mfeo15/CHIC-NAPaC/Report/LaTex source files/bibliography.tex

% References of the Report
\thispagestyle{empty}
\vspace{1cm}
\begin{thebibliography}{9}
\addcontentsline{toc}{section}{References}

\bibitem{lab3-report} 
\textit{Lab 3.0 : Camera \& LCD conceptual design}. \\
CS-473 EPFL. Matteo Yann Feo \& Simone Aron Sanso. November 28th, 2017

\bibitem{lcd-controller} 
\textit{ILI9341 - a-Si TFT LCD Single Chip Driver 240RGBx320 Resolution and 262K color}. 
Rev. 1.11. ILI TECHNOLOGY CORP.

\bibitem{lcd-display} 
\textit{LT24 User Manual}. 
Altera. June 2015
 
\bibitem{avalon-interface} 
\textit{Avalon® Interface Specifications}.
MNL-AVABUSREF. Intel. May 2017.
 
\bibitem{fifo} 
\textit{Single- and Dual-Clock FIFO Megafunction}.
Rev. 4.0. Altera. May 2007.

\end{thebibliography}
