mfeo15/CHIC-NAPaC/Report/LaTex source files/sections/3_EE/EE_main.tex

\newpage
\section{Electronic engineering}
\label{sec:ee}

In this section will be presented the work related on the electronic field.

\medskip First, the hardware subsection will explore the development kit selection, before highlighting the ESP32 capabilities and its electronic characteristics.
