mfeo15/CHIC-NAPaC/Report/LaTex source files/sections/appendix/B_mainPCBschematic.tex

\newpage
\section{Main PCB schematic}
\label{appendix:main_pcb_schematic}

\begin{figure}[H]
    \centering
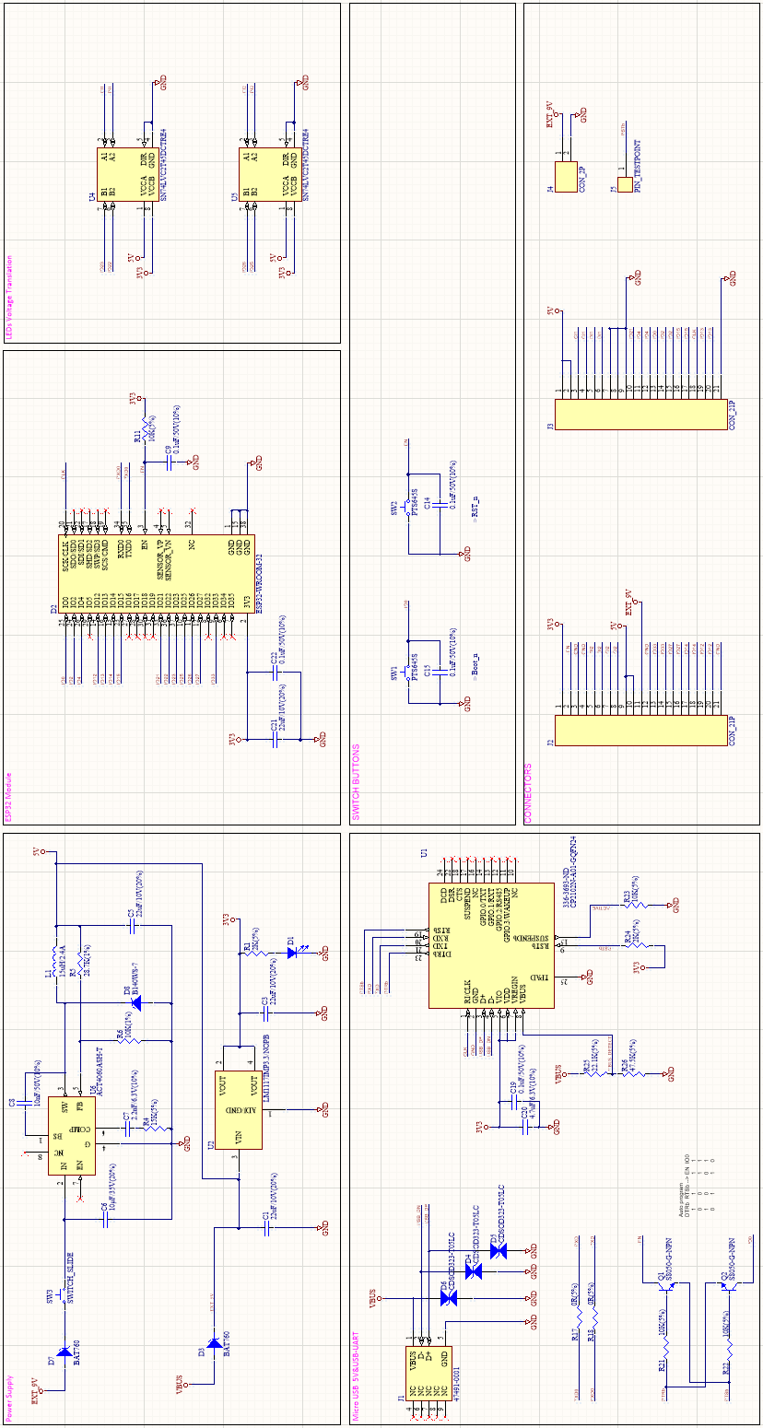
[picture p63: Report/LaTex source files/images/EE_fullPCBschematic.PNG]
    
    \caption{Full schematics of the main PCB}
    \label{fig:main_pcb_schematic}
\end{figure}
