mfeo15/CHIC-NAPaC/Report/LaTex source files/sections/appendix/F_HW.tex

\newpage
\section{Graphs from Soft Sensor testing}
\label{appendix:SS_graphs}

The following graphs illustrate test scenarios and values obtained while testing soft sensors.

\begin{figure}[ht]
    \centering
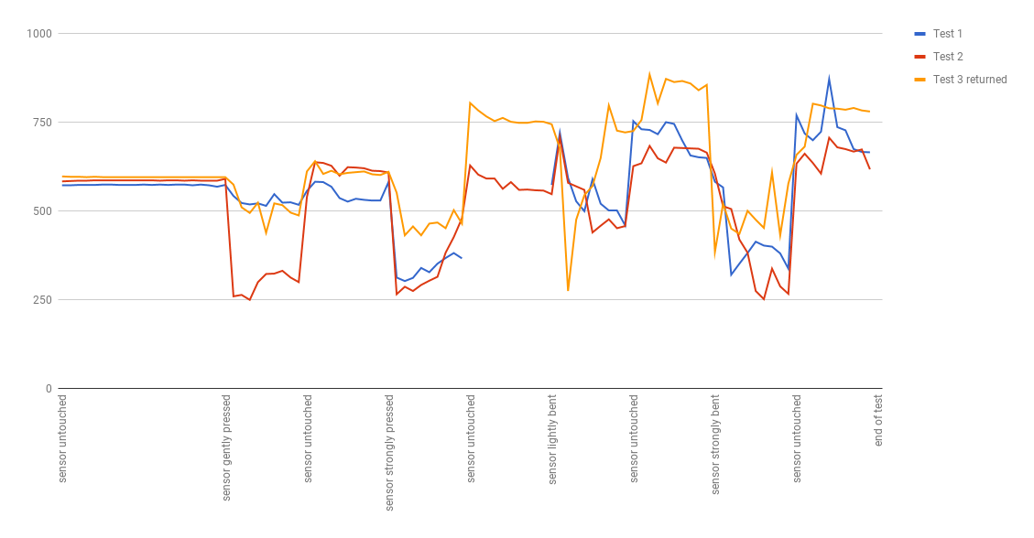
[picture p65: Report/LaTex source files/images/HW/velostat.png]
    
    \caption{Values obtained from testing the Velostat bend sensor}
    \label{fig:velostat_graph}
\end{figure}

\clearpage
\newpage

\begin{figure}[hbtp]
    \centering
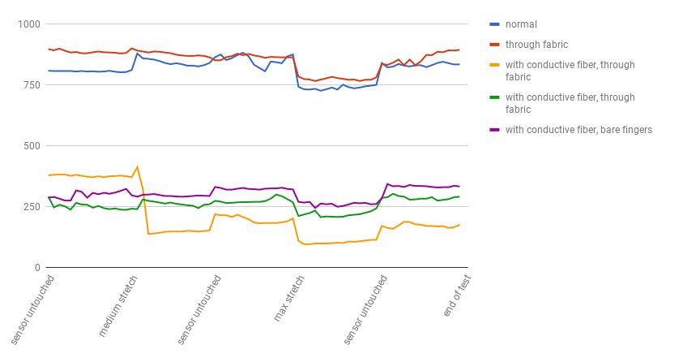
[picture p66: Report/LaTex source files/images/HW/eontex.png]
    
    \caption{Values obtained from testing the Eontex stretch sensor}
    \label{fig:eontex_graph}
\end{figure}

\clearpage
