mfeo15/CHIC-NAPaC/Report/LaTex source files/appendix.tex

% Appendix of the Report
\newpage
\appendix
\thispagestyle{empty}

\section{List of included contents}
\label{appendix:contents}

In the following appendix, a list of figures and a list of tables of the whole report is presented to the reader. This shall help him navigating through the content of the report, the different diagrams and tabulations.

\listoftables
\listoffigures

\section{Maybe another appendix ?}
\label{appendix:another}

Lorem ipsum dolor sit amet, consectetur adipiscing elit. Nunc ac ultricies felis. Donec lobortis dignissim velit, et rhoncus urna volutpat at. In hac habitasse platea dictumst. Nulla finibus ullamcorper eleifend. Suspendisse euismod placerat rhoncus. Donec rutrum eu lacus nec viverra. Maecenas luctus, dui nec scelerisque dictum, nisi lorem hendrerit ex, sed faucibus nulla metus ultricies ipsum. Nam luctus magna velit, ac luctus tortor porttitor ut. Aenean fringilla velit et magna tempus egestas.
