mfeo15/CHIC-NAPaC/Report/LaTex source files/kotlinLanguage.tex

\usepackage[dvipsnames]{xcolor}
\usepackage{listings}

\lstdefinelanguage{Kotlin}{
  keywords={package, as, as?, typealias, this, super, val, var, fun, for, null, true, false, is, in, throw, return, break, continue, object, if, try, else, while, do, when, class, interface, enum, object, companion, override, public, private, get, set, import, abstract, vararg, expect, actual, where, suspend, data, internal, dynamic, final, by},
  keywordstyle=\color{NavyBlue}\bfseries,
  ndkeywords={@Deprecated, @JvmName, @JvmStatic, @JvmOverloads, @JvmField, @JvmSynthetic, Iterable, Int, Long, Integer, Short, Byte, Float, Double, String, Runnable, Array},
  ndkeywordstyle=\color{BurntOrange}\bfseries,
  emph={println, return@, forEach, map, mapNotNull, first, filter, firstOrNull, lazy, delegate},
  emphstyle={\color{OrangeRed}},
  identifierstyle=\color{black},
  sensitive=true,
  commentstyle=\color{gray}\ttfamily,
  comment=[l]{//},
  morecomment=[s]{/*}{*/},
  stringstyle=\color{ForestGreen}\ttfamily,
  morestring=[b]",
  morestring=[s]{"""*}{*"""},
}
