mfeo15/CHIC-NAPaC/Report/LaTex source files/images/intro_one_pager.pdf

# Have you ever felt like spending more time with your child?

Toygether is a soft toy for kids, aged from 2 to 5, that can connect to their parent’s smartphone. It enables parents to have simple playful moments with their child through light and music.

With ever increasing working days and commute times, parents might have
less time to spend with their loved ones. Toygether aims at bridging this gap
by providing a screenless interaction platform, enabling young children and
parents to play even when they cannot physically be together. | When you see your

## toy filling up with light

and sound, my love,

## it’s me that is thinking about you and wants to play

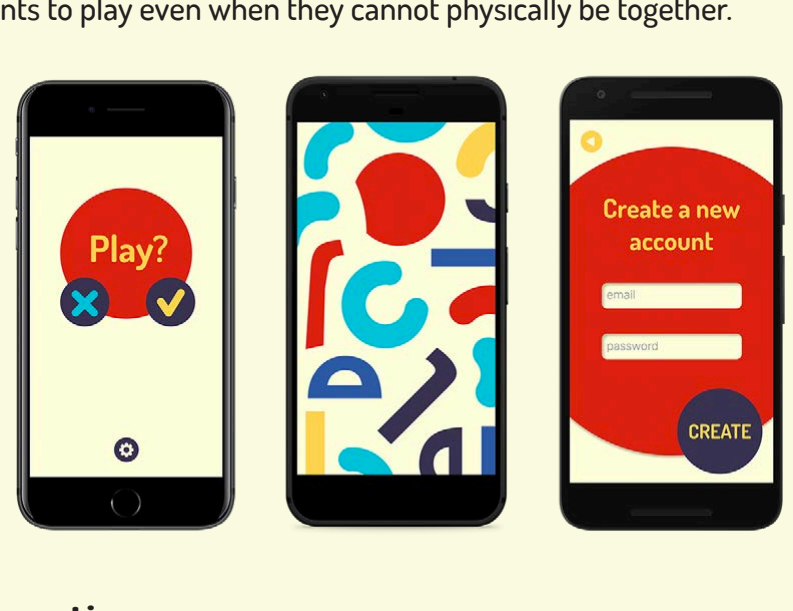
[picture p80: figure]

## Interactive

The plush toy and the smartphone app are connected together, allowing meaningful interaction between the parent and the child, even at distance.

## Educational

The plush toy helps developing all senses of the kid. The sense of touch is awakened with the different materials. The music feature provides a very rich experience for the cognitive development. Finally, playing with the toy can help improve memory and coordination.

## Washable

The electronics are easily removable, which allows easy cleaning.

## Screenless

Z-generation children are likely to be over-exposed to screens. Toygether is a solution enabling parents to stay in touch and play with their kids at distance without putting a screen in their hands.

Estelle GENEUX
Business Information
Technology

Simone SANSO
Electronic
Engineering

Chloe DICKSON
Firmware & Mechanical
Engineering

Matteo Yann FEO
Software
Engineering

Luca SASSOLI
Media & Interaction
Design

Marjane AMARA
Industrial Design

The Toygether team, based in Lausanne, Switzerland - toygether@163.com
