mfeo15/CHIC-NAPaC/SHS/SHS_Research_project.pdf

# Communication Technologies for Left-Behind Children in Rural China

Matteo Yann Feo
Master of Computer Science
Swiss Federal Institute of Technology, EPFL Lausanne, Switzerland
Email: matteo.feo@epfl.ch

Simone Aron Sanso
Master of Micro Engineering
Swiss Federal Institute of Technology, EPFL Lausanne, Switzerland
Email: simone.sanso@epfl.ch

Abstract—Starting from a literature review focusing on the effects of distant parenting on left-behind children in rural China, it has been shown that increased remittances (i.e. sending of money) allowed an enhancement of physical health and academic performance. However, mental health was found to be seriously affected by the lack of parental care, thus increasing the likelihood of depressions during the children’s growth. A comparative analysis has been then realized, comparing three different scenarios of distant parenting: the first one covered the hospitalization of children, the second incarcerated parents and the third transnational parents, out-migrating for the same reason of the Chinese context. All three scenarios revealed the importance and the pros of communication technologies in distant parenting situations. To validate our assumptions, a survey has been forwarded towards parents and children having lived at distance during a continuous period of time, because of activities organized for the children (boy-scouting, summer camps and intercultural exchange programs). Both parents and children demonstrated to rate as essential the importance of communication between parents and children at distance. With even stronger and more sensitive settings than those joyful ones presented here, we anticipate how even more crucial the communication technologies might be rated by families of left-behind children. During an interview with an expert in Chinese anthropology and urban sociology, this hypothesis has been ascertained. Envisioning further investigations on the Chinese field, an interview protocol has been implemented and can be used to validate or refute our hypothesis, by questioning parents of left-behind children. Furthermore, the interview protocol provides a useful tool to analyze more in-depth the psychological effects of parents in this situation.

LIST OF ABBREVIATION

CHIC | China Hardware Innovation Camp
CRC | Convention on the Rights of the Child
ICT | Information and communications technology
LBC | Left-Behind Child(ren)
UN | United Nations
I. INTRODUCTION
Every year, Mainland China witnesses the biggest human mass migration process on Earth, during the Lunar New Year celebrations (Jingyong Zhang et al. 2015). In February 2018, more than 385 million Chinese, according to Forbes (2018), converged back from cities to rural areas. This year, the purpose was to celebrate the year of the Dog, with their family

(Forbes 2018). Among those travellers, a substantial percentage consisted of migrant workers who moved from rural areas to more urbanized ones, in order to seek job opportunities. They live away from their family and usually all return home during the week before New Year, providing support to them via remittances throughout the year. According to Guo, Sun, and Wang 2017, ”An increasing number of children in Chinese rural areas live far away from their parents, as about 80% of the migrant workers leave their children behind in their home-village”. For this reason, they are called ”Left Behind Children” ( 留守儿童, pinyin: liush ´ ou’ ˇ ert ´ ong ´ ), because they are raised by other family members (the second parent figure or the grandparents) or, in the worst scenario, completely left on their own in their home village. The situation of departing parents has substantial impacts on the child’s development, depending on multiple factors involved.
Our research study aims at understanding how communication technologies, connecting parents with their left behind children in rural China, could be beneficial. First, when focusing the study on a subset of the population, as we are doing by specifying ”Rural China”, a clear definition of this expression needs to be provided. According to Shen 1995, the definition is strongly influenced by three crucial censuses, which occurred in 1982, 1987 and 1990. Those collected statistics have been used to divide home-towns of each Chinese province into either ”agricultural” or rural areas, and ”non-agricultural” or urbanized areas. The 1990-census is the most widely adopted allocation between ”agricultural” and ”non-agricultural” villages for such kind of researches. Therefore, our study will be based on this definition of ”rural China”. Nowadays, people are used to connecting with each other via always improving technologies (Bird 2018). We are thus interested in discovering patterns, in parallel to the enhancement of communication channels, between children and their distant parents. Our initial reasoning, biased by definition towards the western social context we have grown into, would indicate that the issue of left-behind children in China could harm both their physical and mental aspects. Moreover, our background suggests that a stronger communication between family members could lead to positive effects and eventually mitigate the issue. Such instinctive conclusions will be challenged during the course of the following research study. The Chinese context of left-behind children lays on the antipodes of our own and each conclusion we might consider trivial to draw needs to be reexamined in a different light. The study’s goal is to explore if and how such context-issue located in China could benefit from enriched communication, via technological means.
To illustrate our work on the presented topic, we will undergo a series of key steps as follows: firstly, an overview in the form of literature review will showcase related work and previous investigations, regarding the left-behind children issue in China and the effects caused by it (section II); then, the methodologies followed during the research will be presented and covered (III); obtained results of the research are thus introduced to the reader with the help of descriptive statistics (IV); interesting patterns in the collected data will be retrieved and compared to the main issue regarding left-behind children, with the support of external expertise (V); and lastly, our final remarks and future scenarios on the presented work (VI).

II. RELATED WORK

A large number of studies have been conducted about the reality of left-behind children, on different localities around the world. These studies have been focusing on different impacts of parental migration, from the children’s perspective. Interestingly, this phenomenon is not only restricted to China (Song and Y. Zhang 2009; He et al. 2012; Guo, Sun, and Wang 2017; Fan et al. 2010; Bai et al. 2017), but also frequently appears in Mexico (Sawyer 2016; Kanaiaupuni 2000; Hildebrandt et al. 2005; Fernandez 1998; Dreby 2007), Latin America (Mundial 2006; Acosta, Fajnzylber, and Lopez 2007; Anton 2010), Romania (Botezat and Pfeiffer 2014), ´ Philippines (Yang 2008; Cortes 2015; Arguillas and Williams 2010) and Thailand (Jampaklay 2006). In this section, specific terms used throughout the research will be defined. Then, related work will be reviewed, about the impact of parental migration on physical health, academic performance and mental health of left-behind children.

A. Definitions and terminology
According to the United Nations (UN 1998), the commonly accepted definition of ’migrant’ is ”any person who changes his or her country of usual residence”. A more precise classification can be introduced with time and space constraints (Rossi 2008). The process is then defined as ”permanent”, ”long-term” (at least 12 months) or ”seasonal”, with either an internal or an international migration. Purposes of recreation, holiday, visits to friends, business, medical treatment, or religious pilgrimages are, although, not considered as migration processes (UN 1998). Two scenarios of parental migration can appear. Either the parents migrate with their children, or they leave them behind (Rossi 2008). Another possible result of parental migration is related to the issue of foster children. Although they share the same loss of parental care, the complete interruption of communication with both parents determines a completely different case that cannot be discussed nor compared with the two previously mentioned scenarios

(Pilon 2003). The commonly accepted definition of LBC (left-behind children) refers to children who stay at home when one or both parents relocate elsewhere, to join the labor force, for at least six months (Lu 2011). In the Chinese context, parental migration is considered to be seasonal and internal, since migrants move from rural to industrialized regions, spending yearly around 11 months away and returning home during the Spring Festival. The formal definition of ’children’, given in the CRC (Convention on the Rights of the Child), Article 1 drafted by United Nations (1989), states that ”individuals below the age of 18” form the children population. However, other conventions to define ’children’ can be found. The 0-15 age range is the most adopted one, in accordance with the research context, due to medical (women fertility) and labor (legal working age) reasons.

B. Impact on LBC’s physical health

The study of Guo, Sun, and Wang (2017) reveals that the ”overall effect” of parental migration on children’s health is uncertain.
Several research studies found positive effects of parental migration on children’s health (Mundial 2006; Acosta, Fajnzylber, and Lopez 2007; Anton 2010; Stillman, Gibson, ´ and McKenzie 2012) and have mainly attributed them for the increased incomes of the family. Remittances helped reducing childbirth mortality (Hildebrandt et al. 2005), increasing birth weight and decreasing the number of underweight newborns (Frank and Hummer 2002). Children are better nourished and can take advantage of an eased access to health services (Nobles 2006). As a consequence, higher incomes enable the children to better manage chronic health problems through medication (Case, Lubotsky, and Paxson 2002).
Other research studies raised negative effects of parental migration (Amato and Gilbreth 1999; Kanaiaupuni 2000; Fernandez 1998), mainly due to the reduction of parental care. Song and Y. Zhang (2009) found that LBC started to overuse health services. A possible cause of this behaviour is the attempt to replace the lacking parental care by medical services. Another intriguing fact from this study is that the access to health services depended on whom the children were left with. Statistically, maternal migration had a negative effect on children’s health. This result confirms several studies showing that maternal presence is essential for the development of a child (Cortes 2015; Jampaklay 2006; Macours and Vakis 2010; Thomas 1994). With paternal migration, longer time and distance of migration positively affected children’s health, again as a consequence of increased remittances. Children’s health status revealed to be also affected by socio-economic factors, dependant on the household (Behrman 1996). One reason why poor parents do not out-migrate could be the need of initial capital to cover emigration costs, for transportation and accommodation reasons. Lastly, health impact of parental migration has been shown to be independent to the child’s age and gender (Guo, Sun, and Wang 2017).

C. Impact on LBC’s academic performance

The study of Bai et al. (2017) rejected the hypothesis that parental migration deteriorated the academic performance of children. Additionally, they found that when one parent or both out-migrated, the academic performance of LBC was even significantly improving, compared to the rest of the students. Increased incomes can, therefore, bring a larger impact than the reduction of parental care. Rising incomes might provide several benefits for LBC, like a better nutrition, improved access to educational materials and fewer housework responsibilities. An analysis about the heterogeneity of the impact, among children of different households, showed that the positive effect of parental migration was even larger for students initially poorly performing at school. An explanation for LBC’s academic improvements is the availability of additional materials, which might have led them to overcome educational barriers that limited their performances. For instance, betternourished students see their academic performance rising (Luo et al. 2012). Remittances could also be invested in tutoring and other additional learning materials like books, computers and learning software. The positive impact of parental migration has been found to become larger when the out-migrating parent had a poor level of education. If the parent has a high level of education, a trade-off between parental tutoring and migrant remittances appears. Therefore, depending on the out-migrating parent’s background, the impact on the academic performance can significantly differ among LBC (Sawyer 2016).

D. Impact on LBC’s mental health

According to the study of He et al. (2012), LBC were at greater risk to develop depression, compared to the other students. The work confirmed a previous study from Fan et al. (2010), conducted on the same topic. The emotional disturbances and higher risks of depression are more evident in specific age-ranges. During early adolescence, changes in sexual cognition and social development occur, leading to determinant consequences for the overall maturity process. Without parental care, psychological problems occurring in the late childhood and adolescence can introduce direct repercussions on LBC’s mental health, increasing the indicators of adult depression risks (Kosterman et al. 2010).
The results presented in the Chinese context were further confirmed by another study, deriving pieces of evidence from Romania (Botezat and Pfeiffer 2014), where the migration fluxes end towards more occidental European regions. Compared to non-migrant households, the study illustrates substantial increases in depression, as well as higher propensity to be bullied during childhood, particularly in rural areas. These research insights match previous results from the literature on the mental health of left-behind children (Gibson, McKenzie, and Stillman 2011; Dreby 2007; Mazzucato and Schans 2011). Children left alone to take care of themselves, living in an environment without any adult supervision, result in even larger risks of depression (Lahaie et al. 2009).

Ren and Treiman (2016) realized a more philosophical research about the possibility of wrongly perceiving causes of depression with Chinese LBC. The research compared the difference of family ”arrangements”, or emotional bonds between parents and children, in China and other countries where the phenomenon of parental migration frequently occurs (i.e. Nicaragua, Philippines, Mexico). They concluded that, in the Chinese context, these family arrangements have ”little impact on the emotional well-being of children”. For this reason, researches about LBC in the specific context of China should be considered a singularity of its own, due to the impressive number of internal migrants, incomparable to any other country. From the Chinese point of view, since the situation of leaving children behind became more common in rural areas (Hao 2006), non-Chinese researchers shall be cautious about their belief of understanding the local social context in China.

III. METHODS

In this study, we seek to evaluate how communication technologies could alleviate the negative consequences of parental migration in rural China. As widely covered in the previous section, LBC are particularly subjective to retain long-term effects on mental well-being, due to the absence of parental care in crucial ages. Therefore, we aim to investigate how the increasing adoption of ICTs (Information and communications technologies) might improve the condition of Chinese families in this context.
To this end, a research methodology has been structured as follows. The topic of ICTs for families will first be analyzed from a more global perspective, focusing on different geographical areas and situations. Our findings will be subsequently related to the local reality faced in rural China. In this manner, the importance of fostering communication technologies between distant parents and children will be explored, through a comparison of related studies within western countries (subsection III-A). Then, after drawing subsequent assumptions, these latter will be tested through a study case realized in our geographical proximity (Switzerland, France and Germany). For this purpose, the recruitment of the samples will be highlighted (III-B), before diving into the content of the survey (III-C).
A. Comparative analysis on similar situations

In this subsection, an analysis of different scenarios will be presented, investigating whether communication affects the mental well-being of children. The first sensible context that will be approached relates to hospitalized children, with long-term chronic diseases disrupting their previous social routine. The second scenario will explore the challenges faced by imprisoned parents to communicate with their children. The last scheme portrays transnational families, for which at least one of the parents left the family to migrate to another country.

a) Hospitals: In the research, conducted by Wadley et al. (2014), is shown that children undergoing long term hospitalization face psychological obstacles, due to a brutal change of previous daily habits. A long term isolation from their social life, both from their family and peers at school, causes concerns to their emotional well-being. Furthermore, this social dislocation occurs at a time when social engagement is crucial for children’s development, as explains the study of Hopkins, Moss, et al. (2014). A comparable situation emerges between this context and the LBC issue, despite the different duration of separation. Furthermore, staying ”out of sight” (Yates et al. 2010, page 80) can lead to apprehension for the isolated child, about coming back to meet again after a long period of time. Therefore, ICTs’ capabilities need to be further investigated. Innovative ICTs could not only be used to bridge distant people together, but also enhance emotional well-being by avoiding staying too long out of each other’s mind. According to different studies (Vernon et al. 1971, Bossert 1994 and Thomson 2012), hospitalization can increase children’s stress. Parents, on the other hand, must continue working and may also experience anxiety and sense of guilt, not being able to be present for their child. This context, thus, shows similarities with migrating parents, leaving their children behind. As revealed in the studies of Stewart-Brown (1998) and Ryan and Deci (2001), physical diseases could also result from emotional distress. Social support through ICTs, therefore, becomes essential for distant families. The research from Hopkins, Nisselle, et al. (2013) highlighted the impact of prolonged absence from school, possibly resulting in a child’s disengagement that can later cause employment difficulties. Challenges associated to unpredictability and vulnerability of children’s health within the hospital’s context, presented by Yates et al. (2010), can be compared to fears and worries of migrating parents, regarding their LBC.
Indirectly contributing to the emotional well-being of persons in sensitive settings, this first analysis of ICTs within hospitals already clearly demonstrates how technology could provide support and connection between LBC and out-migrating parents.
b) Prison parenting: In 2007, 1.7 millions of children had an incarcerated parent in the United States of America (Glaze and Maruschak 2008). Poehlmann et al. (2010) state that these children experience a larger risk of substance abuse, behavioural problems and thus academic failure. Furthermore, poverty and changes in caregiver due to the parents’ incarceration are either the cause or a ”risk marker” (Murray and Farrington 2008) of children’ problematics.
Children’s age is an important factor to take into consideration when approaching the parent-child interactions in this context. Infants, for instance, particularly need contact with their mother. In fact, Byrne, Goshin, and Joestl (2010) showed that infants who stayed in the nursery program of the prison, where the mother resided, were more likely to keep a long term attachment with their mother (with respect to other children discharged from the program less than one year after their arrival). The actual parent-child mean of contact may differ with the age of the child since infants are not able to write letters or even have an oral conversation. Furthermore, when children are too young to have their own opinion, caregivers might act as ”gatekeepers” (Enos 2001). Thus, instead of facilitating the parental contact with the child, some might even limit it. Then, when becoming teenagers, children further develop their verbal skills and sometimes start visiting their incarcerated parents, hiding it from the caregivers (Shlafer and Poehlmann 2010). An absence of contact with the parents might cause feelings of alienation to the child (Shlafer and Poehlmann 2010) since no one ever gave enough affection and attention to let the child feel self-confident.
Parents, on the other hand, might feel stress from losing contact with their children (Day et al. 2005, Clarke et al. 2005, Magaletta and Herbst 2001, Roy and Dyson 2005, J. Arditti and Few 2008). Experienced symptoms of incarcerated parents are depression and anxiety (Houck and Loper 2002). The impressive outcome is that both direct and distal communications are able to improve the state of mind of incarcerated parents. Poehlmann (2005) showed that visits could decrease the depression of mothers in prison. Likewise, Loper et al. (2009) discovered that mothers with more frequent phone calls, letters or emails were feeling less distress. As Casey-Acevedo, Bakken, and Karle (2004) associated joy and relief to visits, distant communications can also have a significant impact on parental mental health.
Regarding facility visitation policies, depending on the institutional security level, the parents are allowed to receive ”full” contact visits (where physical contact is allowed), or ”open” but without contact visits, or ”barrier” visits (occurring with a Plexiglas barrier) (Johnston 1995, Sturges and Hardesty 2005). In some jails, visits can even happen only through a television transmission, where the incarcerated parent and the child are located in two separate areas. From this literature review, child visits can happen to be associated with emotional distress, together with uncomfortable environments and almost no opportunity for meaningful contact, as also explained by
J. A. Arditti (2003) and Loper et al. (2009).
Parents might prefer avoiding their child seeing them in a rather negative environment. Incarcerated parents thus prefer contacting their family with alternatives to visitations, such as written correspondence, because the settings are more under the parental control than on the authorities of the penitentiary. On the other hand, the child is less likely to overhear inappropriate discussions. The parent might be more relaxed and focused on the content of the interaction with the child, rather than on the environment. Visitation rooms, letters and phone calls become the child’s reality of the relationship with their parent. When children and parents did not manage to keep in contact, visits could also be stressful for the child. A perfect transition before initiating visitations could then be remote forms of contact. Alternatives for younger children, not yet apt to communicate orally, could make the use of a playful interaction. To conclude with regard to this context, distal communications offer flexibility (Tuerk and

Loper 2006), which is not given to incarcerated parents.

c) Transnational parenting: The study of Bacigalupe and Lambe (2011) provides another relevant example to test the importance, for growing children, of having communication channels with their family. The paper focuses on the increasing adoption of ICTs in migrant families and how technologies can ease the parenting role that became more difficult with the distance.
The first key consideration the study highlights is the need to completely change people’s state of mind about ICTs in family communications. The general public is often reminded of the negative impact an over-usage of technologies could bring in the family bonds. In fact, the adoption of technologies in a household might lead to unhealthy and, paradoxically, even distant connections with the other family members. However, when families face the situation of living at distance, the previous negative statements about ICTs need to be questioned. Therefore, a transnational family context cannot be modeled as the common family idea, where both parents and children can easily meet in reality.
An objective analysis of the study’s content could not be possible without taking some distance with the paper. Faceto-face relationships are not anymore the only manner to maintain and build a social bond between people (Bacigalupe and Lambe 2011). Introducing new possibilities of ICTs, this vision can be completely remodelled. Licoppe (2004) describes this new era of communication technologies as ”a continuous pattern of mediated interactions that combine into ‘connected relationships’, in which the boundaries between absence and presence eventually get blurred” (page 135-136). The research of Bacigalupe and Lambe (2011) recalls that parental migration always existed since civilization exists. However, it often implied a sharp consequence on the household stability. The social concept of family often identifies the parental caregiving when growing children. Without ICTs, out-migrating parents would require frequent visits or, since recently, expensive international calls in order to keep a solid family bond. Most migrants, due to scarce resources, were not able to maintain such a functional long-distance family. This lack of parenting would eventually cause the irreversible problems during the child growth identified in the literature review (section II). Therefore, ICTs could bridge migrated parents with the rest of the family and provide the missing communication channel that leads to an unhealthy child’s growth. We believe that, potentially, such new communication technologies could be the key to mitigate negative mental consequences, introduced in the context of LBC in China. The role of ICTs is to allow families to engage in a ”transnational care-giving”. The rising adoptions of smart-phones, primary kind of ICT, is a clear signal of the importance such technologies have in the process. In fact, transnational families benefit from those tools to accomplish each small parental duty, necessary to the well functioning of the family such as bedtime routines or even hygiene check-ups. To further analyze this process, one needs to first define parental care-giving in detail. According to Finch (1989), it could be expressed in five basic forms: ’financial’ (i.e. remittances), ’practical’ (i.e. sharing expertise), ’personal’ (i.e. hands-on care of sickness), ’accommodation’ (i.e. having a place to stay), and ’emotional’ or moral support (Bacigalupe and Lambe 2011). The adoption of communication technologies gives access for children to a new channel that effectively provides care-giving, as described, by migrant parents. Therefore, by using ICTs, transnational families are able to cover each of the forms of care-giving listed previously (Baldassar 2007). While some of these forms could be argued to need real proximity with the parents and in-person visits, all of them can still be handled at distance. Furthermore, with ICTs, the emotional and moral support from parental care-giving would be strongly enhanced and could, therefore, be mitigating the negative consequences of mental well-being for LBC.
In conclusion, the usage of ICTs in migrant families is less likely to have the negative impact that families living close together could face. ICTs actually provide a tool to strengthen family connections otherwise very difficult, if not impossible, to maintain. In this new light, we think that children of out-migrating parents could benefit from communication technologies to mitigate consequences identified in LBC mental health. By enriching accesses to different forms of parental caregiving at distance, as defined Finch (1989), ICTs may be the key to improve the difficult conditions of migrant families.
B. Recruitment
In the analysis covered in the previous subsection, the importance of communication channels between growing children and the rest of the household has been clearly highlighted. Moreover, similar negative effects to the ones identified in the LBC’s context were presented. Therefore, considered as not completely grown up yet, children below the legal age (18 years old in Europe, 15 years old in China) require strong communication with their parents to avoid negative mental consequences, regardless of the surrounding context. Even though each person’s background is different, communication appeared to represent a key component of a healthy child’s development.
In order to enrich our research, we decided to test this assumption in our own local context. The purpose of this section is to introduce the procedure that has been used, before presenting the results (see section IV).
The objective of this phase is to understand the importance of communication in distant households and how ICTs might have helped mitigate negative effects related to that context. To this end, we decided to tackle the problem by identifying different situations present in our reality (a ”Western context”, primarily focused in Switzerland, France and Germany) in which households would be separated for a continuous amount of time. A complete recruited-population research has been done, which provided promising results for situations such as summer camps, scouting adventures or intercultural exchanges. Kids and teenagers whom joined such programs have spent from a couple of weeks (specifically the younger ones) up to six months or a year away from their family. As we previously did in the definition of LBC, by identifying constraints on both child age and family-separation time, the same must be done with the recruited population. While tackling the question from our local perspective, a trade-off aroused on the population characteristics. As mentioned, the younger the children and the less likely the children have spent more than a couple of weeks away from their family. On the other hand, increasing the age of the participants induced longer separation-times, better matching those of LBC (of at least six months). Therefore, during the discussion of the results, these factors shall be kept in mind to draw a more accurate conclusion.
In addition to children and teenagers recruitment, particular consideration from the parents’ side has been taken. Since the study focused on the importance of communication, obtaining results concerning the two sides of the channel could potentially lead to richer conclusions. Moreover, especially when dealing with younger children, parents could provide more easily the needed information.
While reading the previous paragraphs about the sample population recruitment phase, the reader might underline the impressive difference between the LBC issue and the distant-parenting experiences chosen. In fact, results collected from this selected population are difficult to relate to the Chinese issue because of the former experiences a family-detachment due to joyful and/or educative motifs. On the other hand, the migration decision is forced by much more difficult reasons. However, other possible populations have been considered to be recruited for such phase. Military recruits, who are often required to spend significant periods of time away from their home, or incarcerated parents who face the challenge of communicating with their family as already presented before could have led to richer results in the research. Although, due to difficulties with such recruitment, a trade-off has been achieved, thus leaving more accurate populations for further investigations and future iterations of the study.
To collect the data from those two described populations, an online survey has been prepared and posted on social media platforms. Initially, to be able to draw statistical conclusions, the expected minimum number of answers was set to 30 situations of distant parenting with children below 18 years old. Not being able to reach enough valuable data, we decided to turn ourselves to associations. The objective was not only to obtain more insights towards distant-parenting situations, but also to reach a more homogeneous population. Thus, we have been in contact with a consistent number of associations to spread out the survey (refer to annex D for the list of contacts). The idea was to examine the question in our own region, by reaching out entities in the Canton de Vaud (eventually expanding then to Switzerland as a whole), whose work related to distant parenting experiences for children and their families.
C. Content of the survey

As previously mentioned, the goal addressed with the survey was to determine the importance of maintaining a communication channel via ICTs, in any context of distant parenting. We aim to directly test on our European local reality how kids, away from their family, might find comfort in this connection. Even though the population we recruited and described in the previous section is mainly composed of families divided by joyful activities (intercultural exchanges, summer camps, etc.), homesickness can easily emerge. For this reason, even this type of joyful experiences can lead to a substantial decline in the emotional well-being, particularly for young children at their very first time away from home. The content of the survey intends to give an understanding about how essential channels of communication become for distant families in such context and, therefore, even more crucial in harder situations as the ones experienced by LBC in China.
The survey was written down in both French and English to maximize its accessibility. Post-processing tasks have then merged the results for comparisons. Moreover, the survey contained similar questions for both parents and children, but each from their own perspective to eventually later draw conclusions, with respect to both groups of family members. To investigate the problem, the survey tried to collect enough demographic data of both children and parents, answering about their first experience of distant parenting. The idea is to, during the afterwards analysis, determine different patterns in how the communication channel might be correlated to gender, age or parental role (mother and father). This latter, for example, might be interesting because it could lead to results similar to the ones mentioned in our literature review for LBC in China. Different parental roles are key factors in how the distant parenting experience is handled. Furthermore, we investigated the kind of short-term ”migration” to better understand how families have dealt with it, particularly in cases of long duration distant parenting and young ages of the children.
Before diving into the analysis of the results, the reader may first want to explore the questions that have been asked in the survey (appendix A). First, the context of the survey has been briefly explained. Then, questions were split into two categories, depending whether the person answering the survey has lived the situation of distant parenting as a child or a parent. Both child’s and parent’s gender were asked, in order to understand whether a stronger relationship could appear between distant mothers and children, as described in previously mentioned related work (section II-B). Then, more precise questions about the context of distant parenting situations were asked (reasons, duration, age of the child). The focus of the survey was on the communication technologies used during that period of time (frequency, main purpose and mean of communication). Finally, the questioned people were asked how they would rate the importance of communicating with their distant relatives. Notice that the scale has been chosen from 1 to 7, with value 1 corresponding to insignificant and 7 to essential, in order to keep one neutral answer (4/7) and three possible choices of negative (3/7 and below) and positive answers (5/7 and above). Notice as well that when the importance of communication is presented as null (0/7), it means that no data has been received for a particular setting of distant parenting (i.e. in fig. 11 with the frequency of communication corresponding to ”once per month”).

IV. RESULTS
This section reports the results of our study, organized around the questionnaires. In total, 116 persons have answered the questions that have been presented previously. Before diving into the analysis (see section V-A), the collected statistics need to be objectively presented. First of all, the sampled population present the following characteristics: 55.9% of the questionnaires have been filled with the English form, against 40.1% in French; 75% of the population was composed of children (37.9% sons and 62.1% daughters), and 25% by parents (10.3% fathers and 89.7% mothers). The two main features of interest are the Child’s age, to compare the input with the LBC issue, and the Importance of communication from which we aim to draw relevant conclusions. Such characteristics are presented in tables I and II, for the children and parents population, respectively. The first class contains 87 children, with a mean age of 14 years and 3 months old (14.31), having spent at least three days away from their family. These children rated, on average, the importance of communication 5.80 over a maximum score of 7, with a standard deviation of 1.46. The second class (29 questioned parents having lived a distant parenting experience with a child of 9 years old on average) rated the importance of communication at 5.79, with a standard deviation of 1.69. Despite the difference in the total number of parents and children having participated to the survey, both final results regarding such latter feature are surprisingly close to each other.

TABLE I
STATISTICS FOR THE CHILD RESULTS OF THE SURVEY
Child’s age | Importance Rating [0-7]
Mean Std Min 25% 50% 75% Max | 14,31 5,06 2 10 14 18 23 | 5,80 1,46 2 5 6 7 7
Count | 87

TABLE II
STATISTICS FOR THE PARENT RESULTS OF THE SURVEY
Child’s age | Importance Rating [0-7]
Mean Std Min 25% 50% 75% Max | 9,00 3,23 3 7 9 10 17 | 5,79 1,69 0 5 6 7 7
Count | 29

To conclude the section, we present to the user the statistics illustrated in the previous tables by adopting box-plot representation for each feature. Figure 1 illustrates the different input data regarding children’s age. Even though the parent population is considerably smaller than the children one, it generally focuses on a younger age range that better matches the premises of the research. Despite the heterogeneity of the two sampled categories, figure 2 illustrates surprising close results regarding the importance of communication.

0 | 5 | 10 | 15 | 20 | 25

Children
(Parents’ survey)

Children
(Children’s survey)

Children’s age

Fig. 1. Age of the children by the two categories of samples. Notice that the ’Parents’ samples have filled their children’s age, illustrated above.

0 | 2 | 4 | 6

Parents

Children

Importance of communication

Fig. 2. Importance of communication rated by the two categories of samples

V. DISCUSSION

The methodology of this study converged in a collection of results obtained through a research on the importance of maintaining a communication channel between parents and children, during distant-parenting situations. In the previous section, the results have been introduced in order to better define the sampled population. The aim of this section, on the other hand, is to construct from these objective results, our own hypotheses on the issue, by identifying the interesting patterns according to different features of the data (subsection V-A). Then, we will discuss whether the obtained hypotheses could be transposed back to a Chinese context, seen for the LBC issue (V-B). Lastly, we will draw an interview protocol, aimed to be helpful for a future field test in Mainland China, that could eventually bring to us the final prove, or disprove, to our hypotheses (V-C).

A. Analysis of the results
In this first part of the discussion, we aim to get a deeper understanding of the obtained results, that have been described in the previous section. The goal is to determine whether interesting patterns could be retrieved from the studied population, in accordance with the distant-parenting issue, and how this latter is faced by distant families.
As already mentioned while explaining the content of the survey (see section III-C), the literature review proposed substantial differences in the way the paternal or maternal figures dealt with distant parenting. Unfortunately, the data on the parent side is not sufficiently rich to draw a representative analysis and to determine whether similarities in our survey occurred. On the other hand, we might be interested in discovering unknown outlines on the child’s side according to statistics (like age, gender, etc.) that have not been sufficiently explored yet.

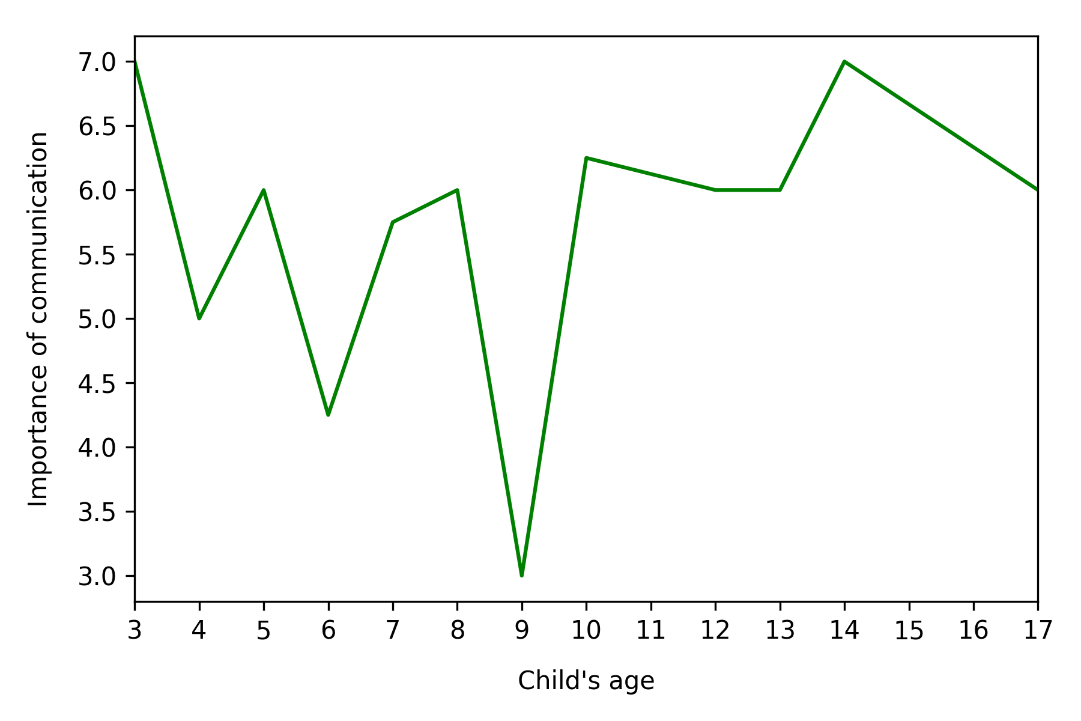
[picture p81: figure]

Fig. 3. Averaged importance of communication rated by the parents category, over child’s age

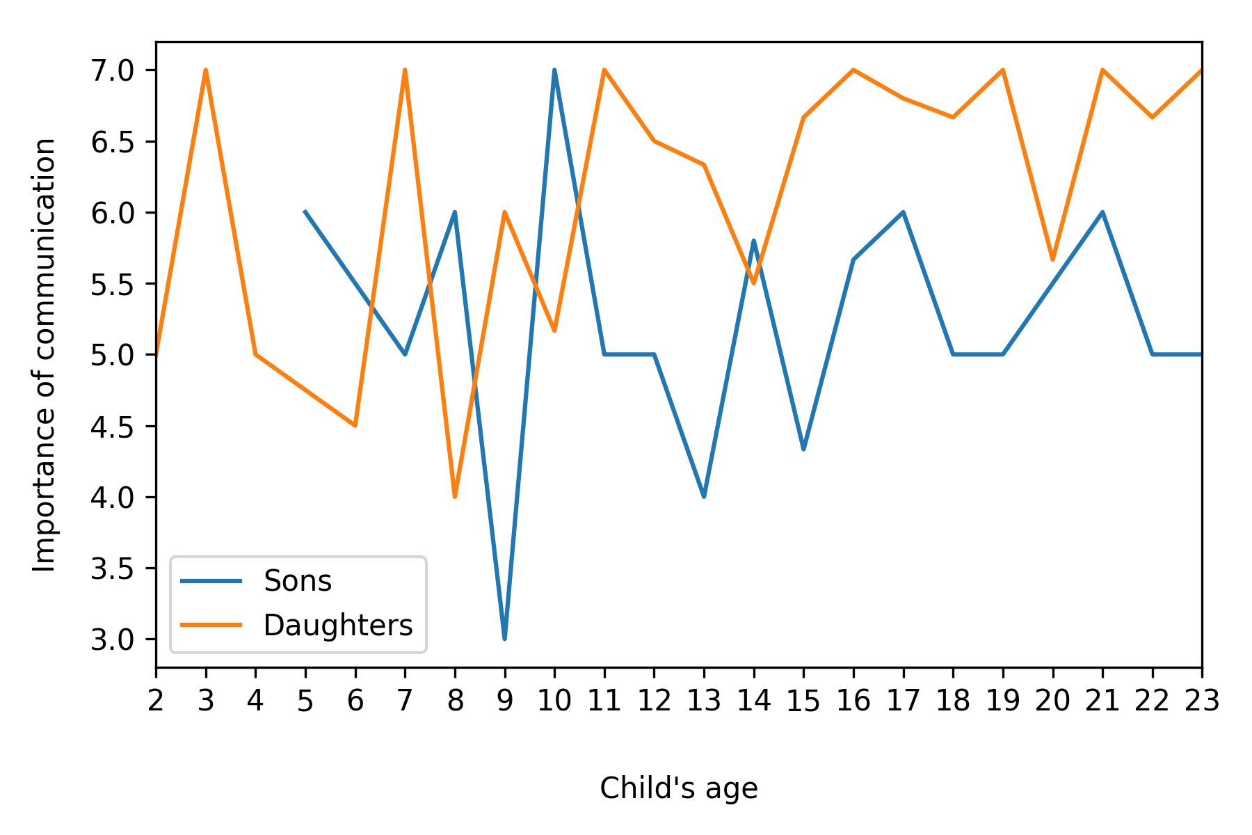
[picture p82: figure]

Fig. 4. Averaged importance of communication rated by the children category, over child’s age

The very first outcome from the collected data is about the feature regarding the importance of communication. We wanted to understand how the importance of communication was perceived, by both parents and children, and specifically how other factors might modify its trend. The two plots in figure 3 and figure 4 illustrate how the adoption of communication technologies (ICTs) are perceived by parents and children, according to different child’s age during the distant-parenting experience. As already shown in the initial results (table I and table II), the importance is generally perceived as extremely high, regardless of age differences. Although this latter might seem a trivial consideration, it is useful to keep in mind that such results are strongly related to the context from which they have been extrapolated and might be different in other social conditions and in other cultures, such as China. In order to avoid biases of any kind due to triviality in our own perspective, every result needs to be considered at this stage to later discuss it, in the Chinese context (see section V-B). Moreover, the two plots already illustrate the second consideration we can draw from the results. The trend clearly showcases a strong inclination of daughters, compared to same aged male peers, to give a higher weight to the importance of communication, from the age of ten years old (figure 4). Such results, therefore, suggests a possible exploratory pattern toward different responses according to child’s gender and age, when being away from home for the very first time.
The plot presented in figure 5 tries to relate the frequency of communication with distant parents-children, according to different duration of the journey, during which the children spent time away from their families. The first intuition we had regarding a possible child’s gender bias in the data is confirmed by such plot. It generally illustrates a higher tendency for girls to have more frequent communication with their distant families, regardless of the duration of the experience. Would this trend suggest that daughters are more likely to consider communication more important than boys?

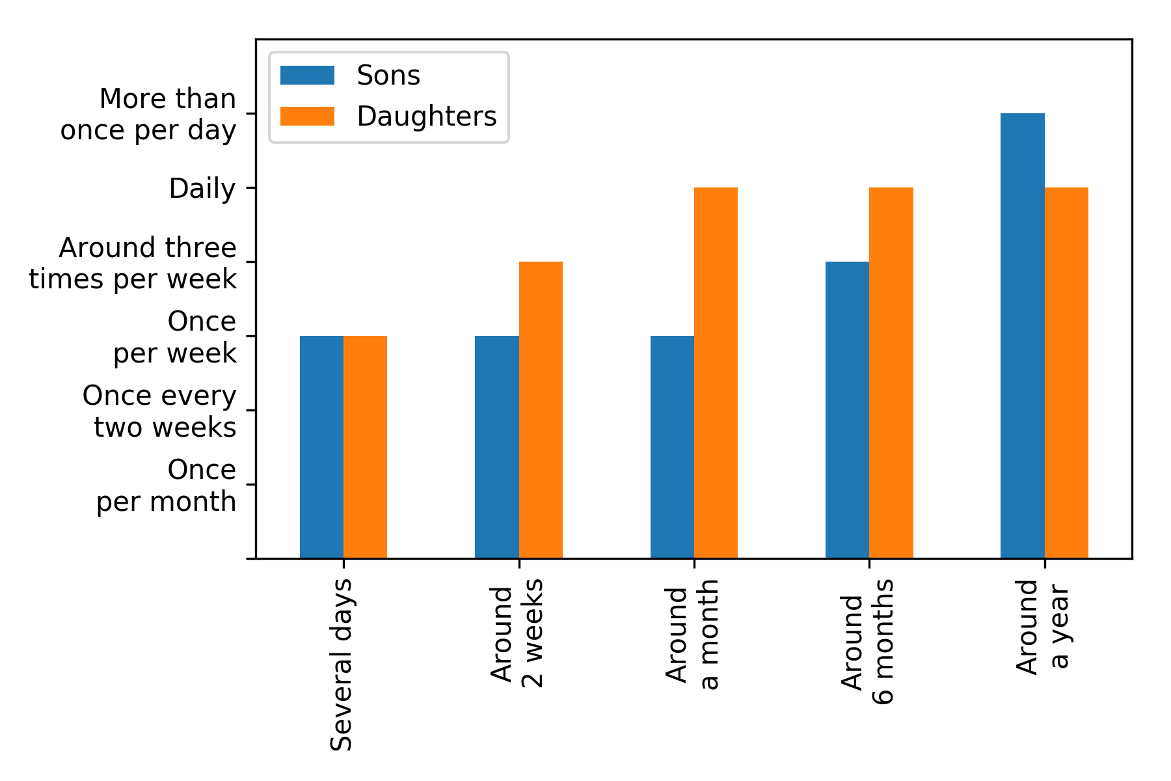
[picture p83: figure]

Fig. 5. Distribution of communication frequencies, over the duration of distant parenting
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
