mfeo15/CHIC-NAPaC/Report/LaTex source files/images/EE_Comparaison_ESP32_ArduinoUNO.jpg

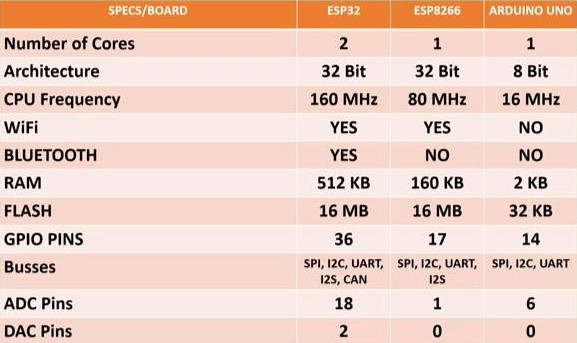
Report/LaTex source files/images/EE_Comparaison_ESP32_ArduinoUNO.jpg
