mfeo15/CHIC-NAPaC/Report/LaTex source files/images/EE_LEDsVoltageTranslation.PNG

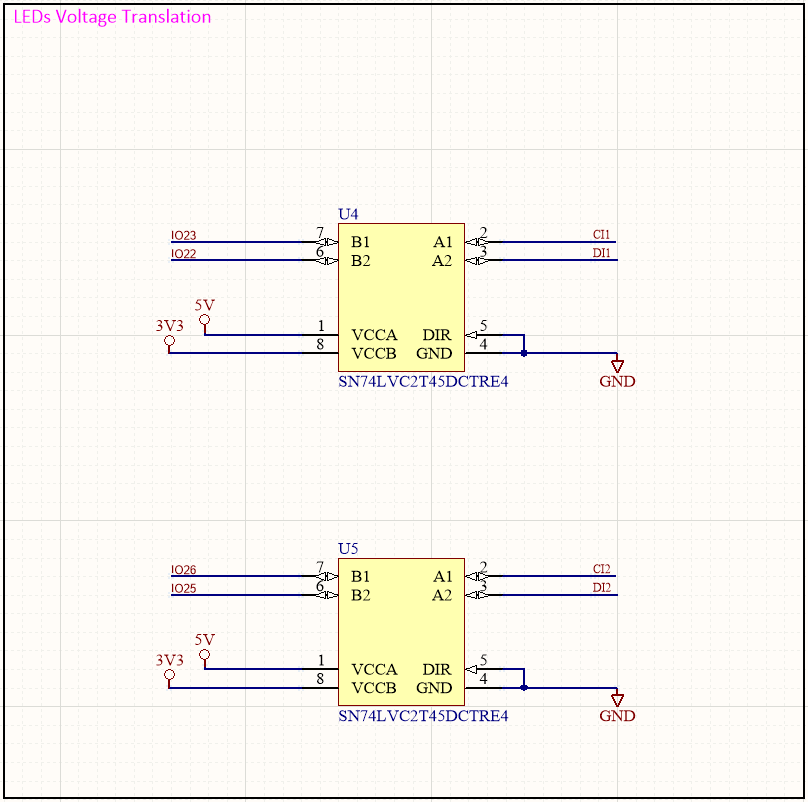
Report/LaTex source files/images/EE_LEDsVoltageTranslation.PNG
