mfeo15/CHIC-NAPaC/Report/LaTex source files/images/FW/capa_squeeze_hand.png

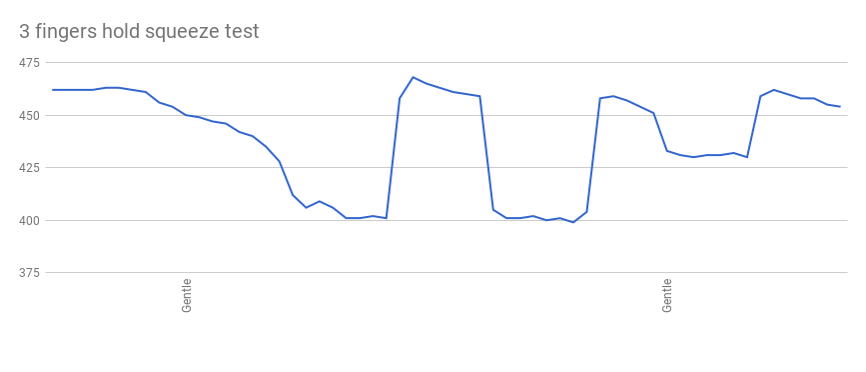
Report/LaTex source files/images/FW/capa_squeeze_hand.png
