mfeo15/CHIC-NAPaC/Report/LaTex source files/images/HW/heatbond_tracks.jpg

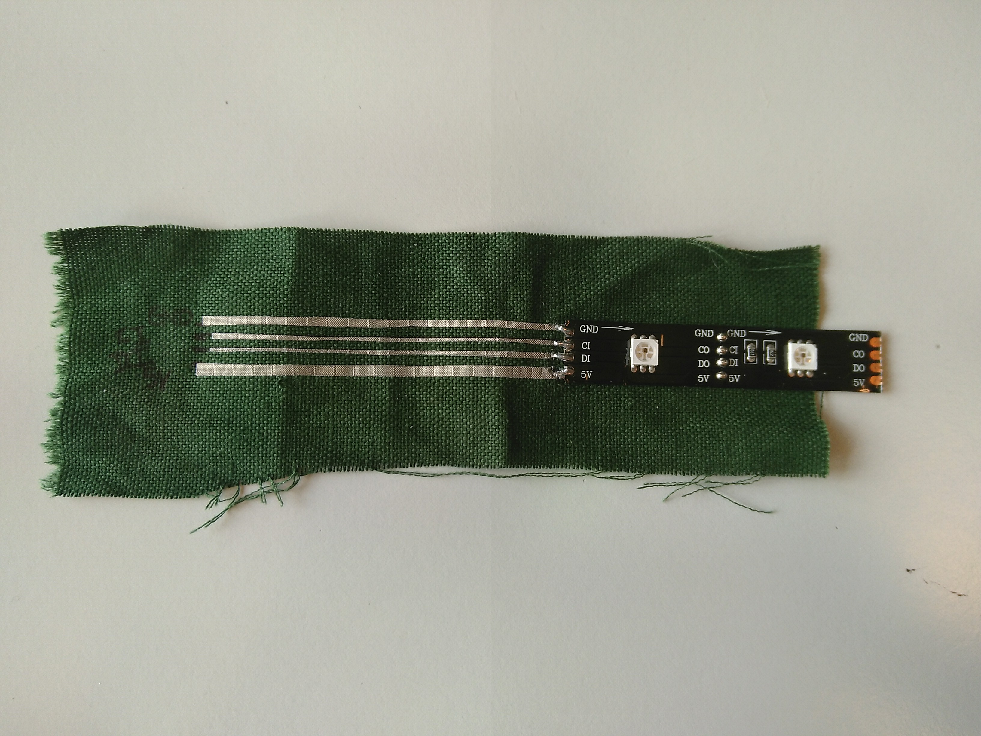
Report/LaTex source files/images/HW/heatbond_tracks.jpg
