mfeo15/CHIC-NAPaC/Report/LaTex source files/images/HW/proto1.jpg

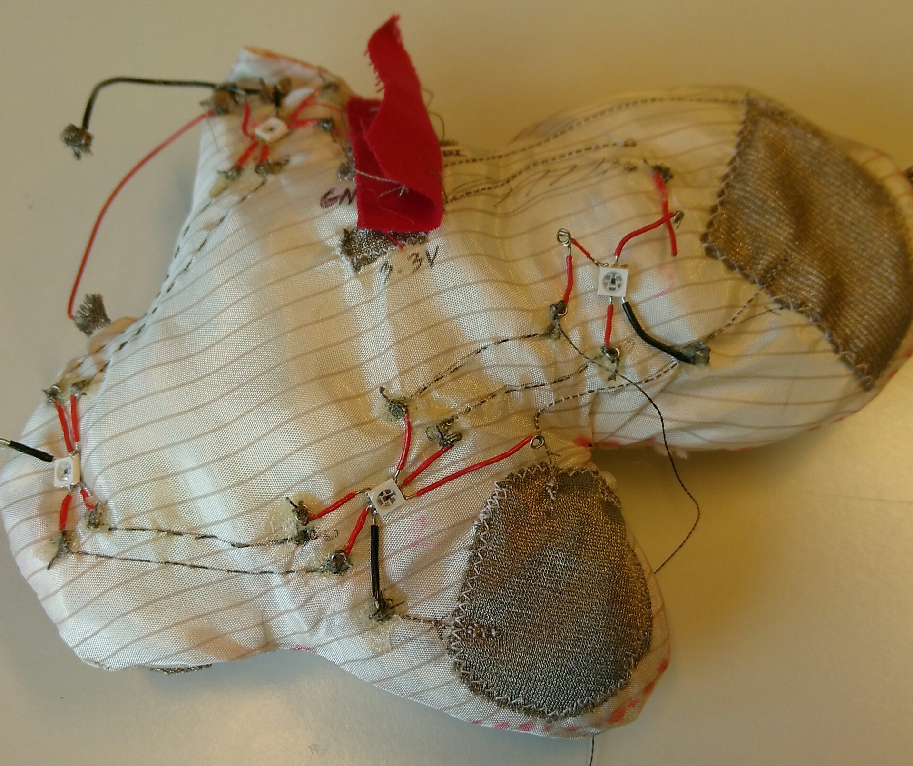
Report/LaTex source files/images/HW/proto1.jpg
