mfeo15/CHIC-NAPaC/Report/LaTex source files/images/HW/proto2_soft_connected.jpg

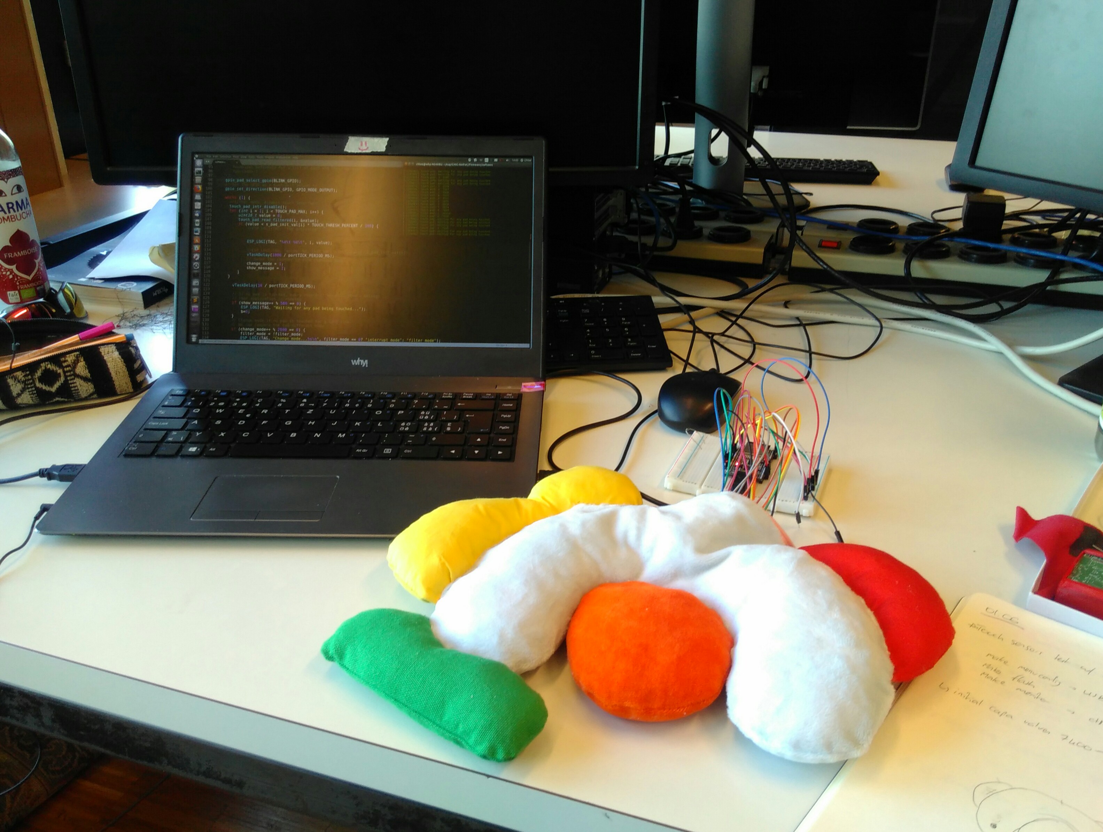
Report/LaTex source files/images/HW/proto2_soft_connected.jpg
