mfeo15/CHIC-NAPaC/Report/LaTex source files/images/HW/softPCB1_capa2.jpg

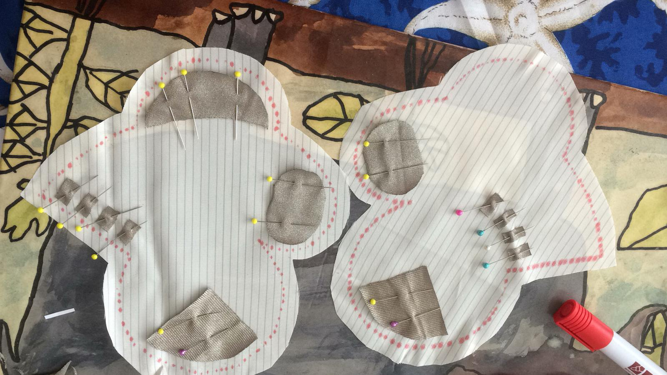
Report/LaTex source files/images/HW/softPCB1_capa2.jpg
