mfeo15/CHIC-NAPaC/Report/LaTex source files/images/HW/softPCB_sensors1.jpg

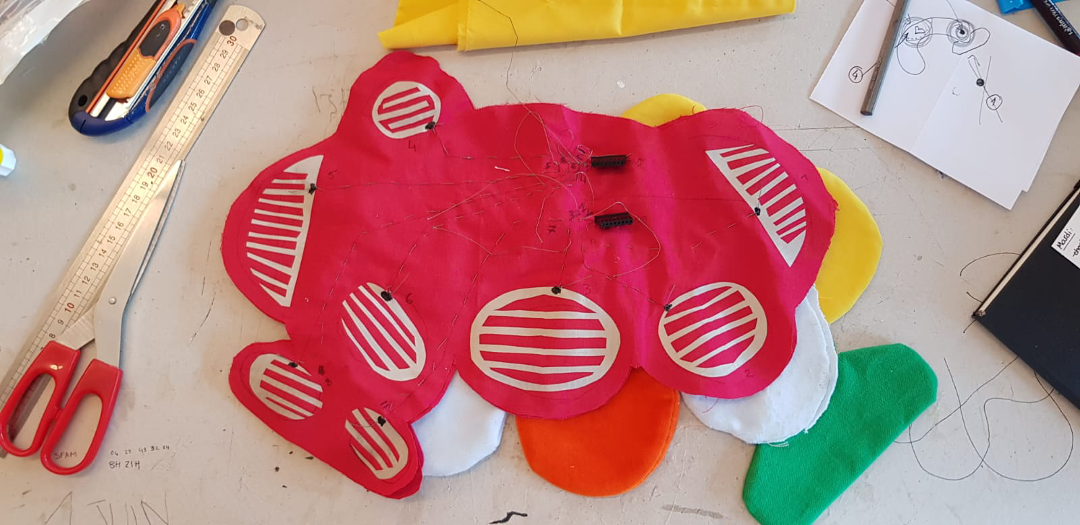
Report/LaTex source files/images/HW/softPCB_sensors1.jpg
