mfeo15/CHIC-NAPaC/Report/LaTex source files/images/HW/softPCB_track_inspo.jpg

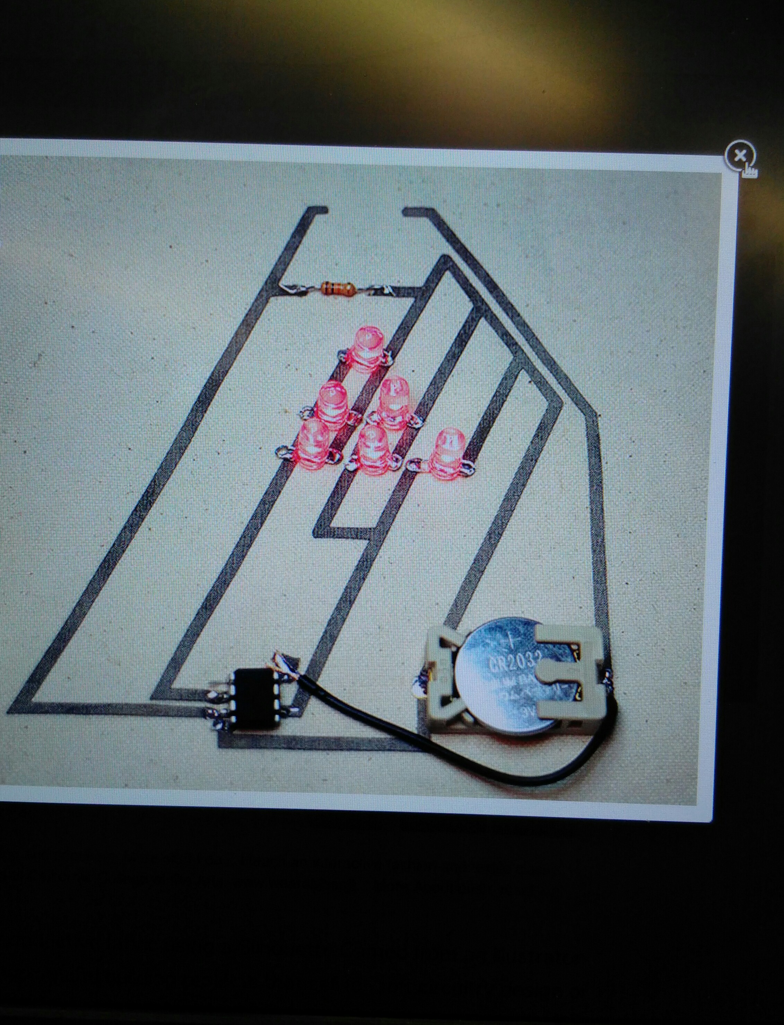
Report/LaTex source files/images/HW/softPCB_track_inspo.jpg
