mfeo15/CHIC-NAPaC/Report/LaTex source files/images/landing_page.PNG

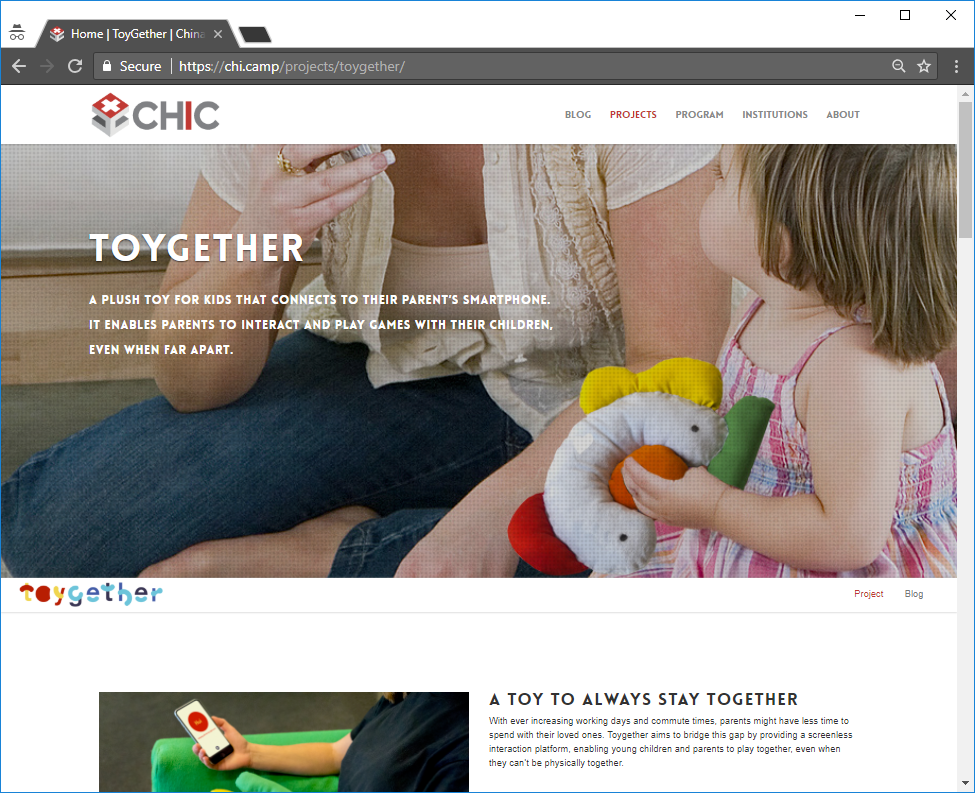
Report/LaTex source files/images/landing_page.PNG
