mfeo15/CHIC-NAPaC/Report/LaTex source files/images/SE_communication_sequenceDiag.png

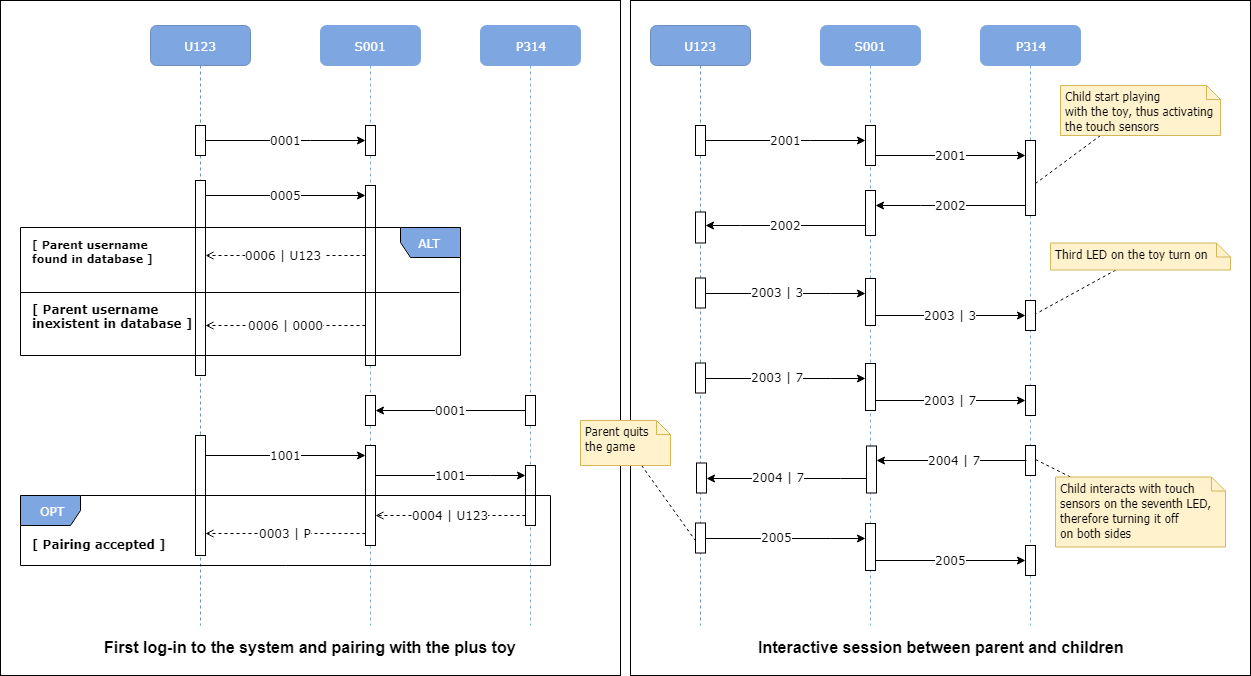
Report/LaTex source files/images/SE_communication_sequenceDiag.png
