mfeo15/CHIC-NAPaC/SHS/pre-processing of data/plot_5.png

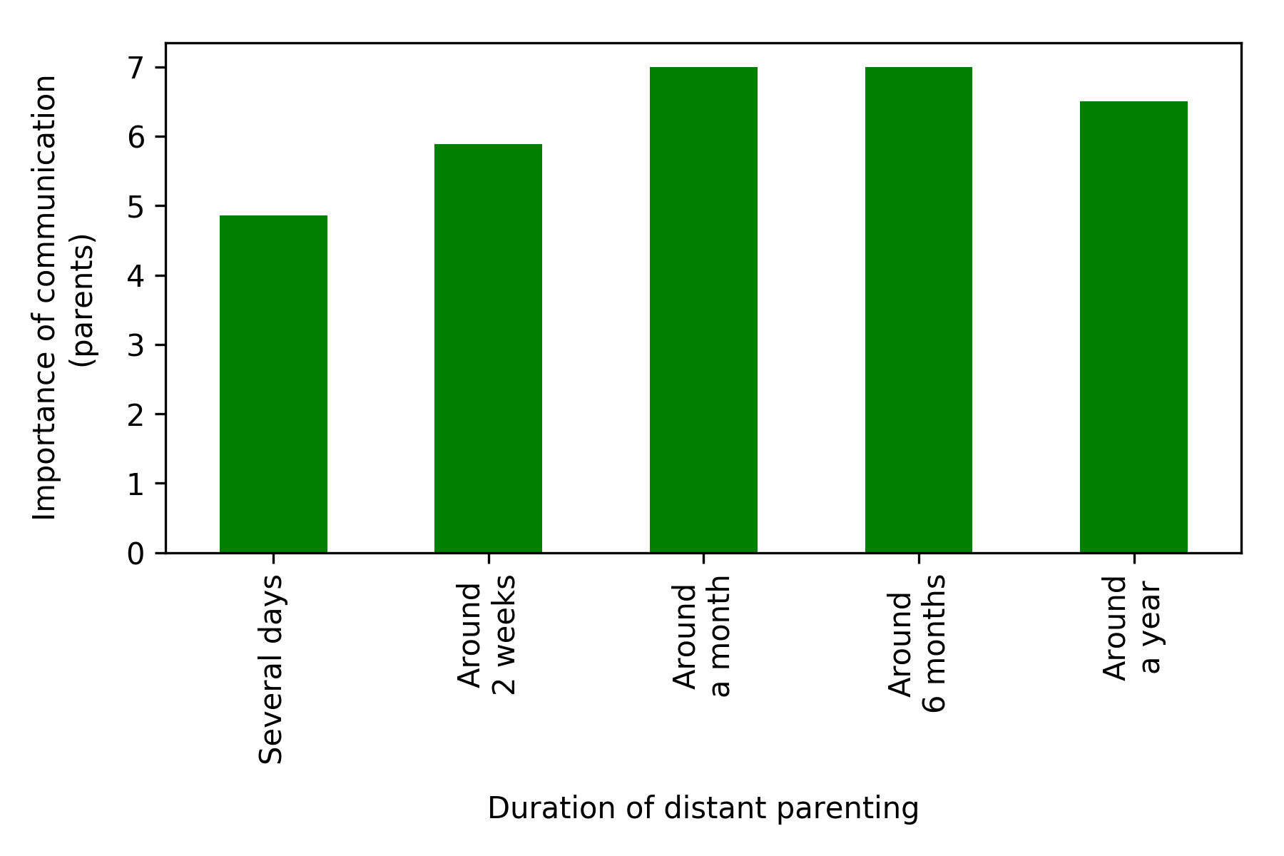
SHS/pre-processing of data/plot_5.png
