mfeo15/CHIC-NAPaC/SHS/pre-processing of data/plot_6.png

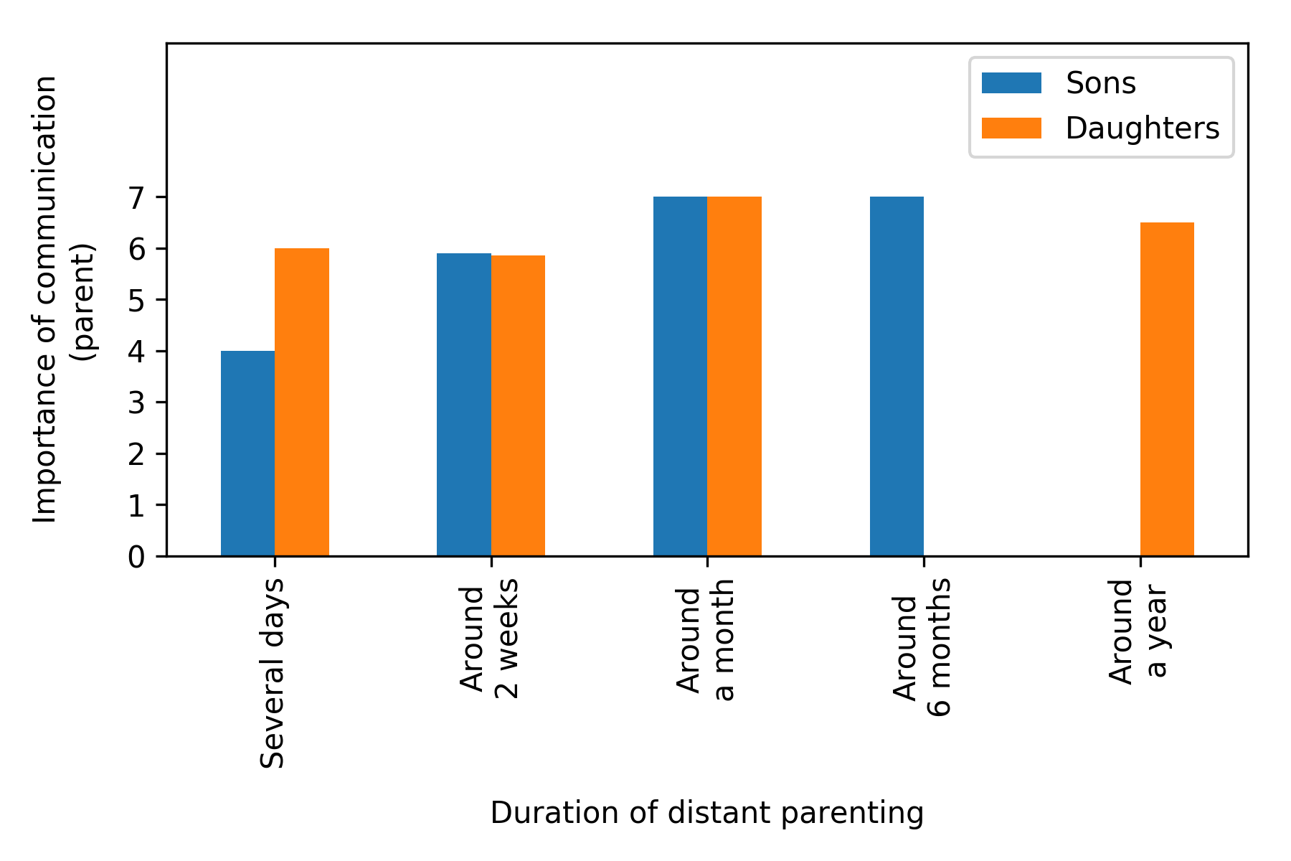
SHS/pre-processing of data/plot_6.png
