mfeo15/CHIC-NAPaC/SHS/pre-processing of data/plot_7.png

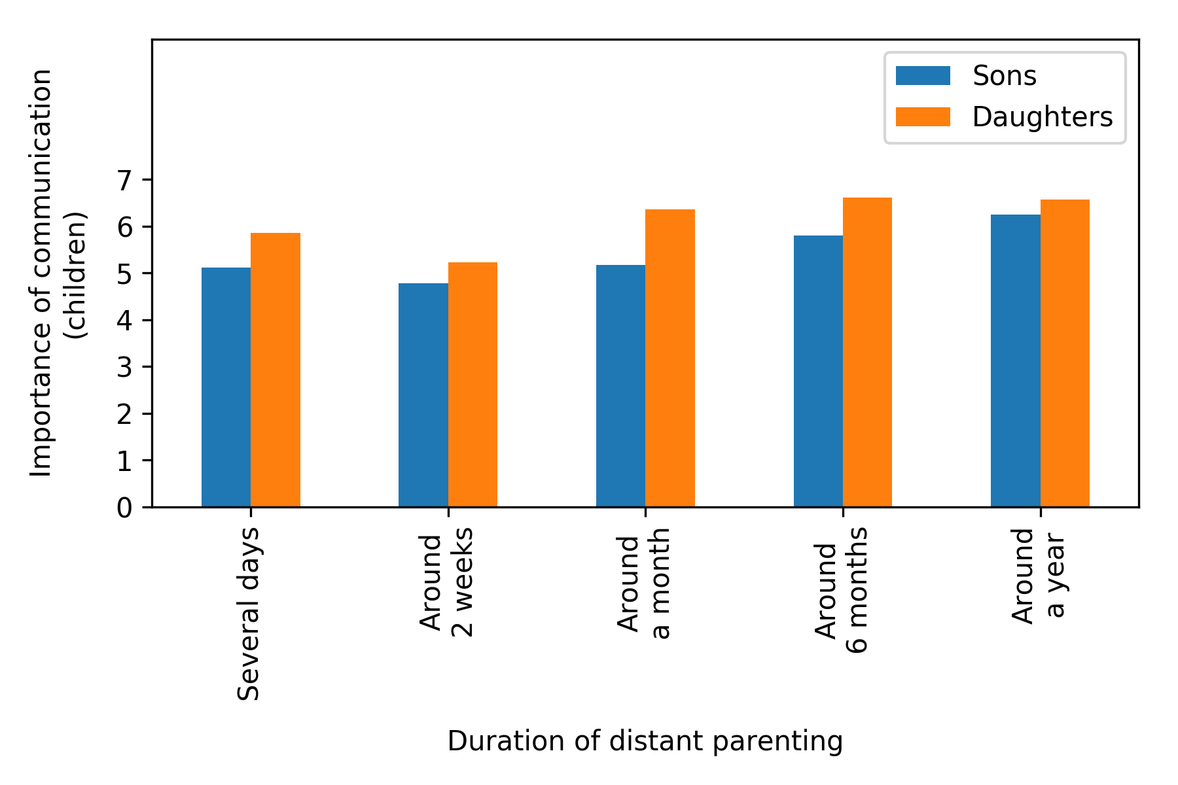
SHS/pre-processing of data/plot_7.png
