mfeo15/CHIC-NAPaC/SHS/pre-processing of data/plot_8.png

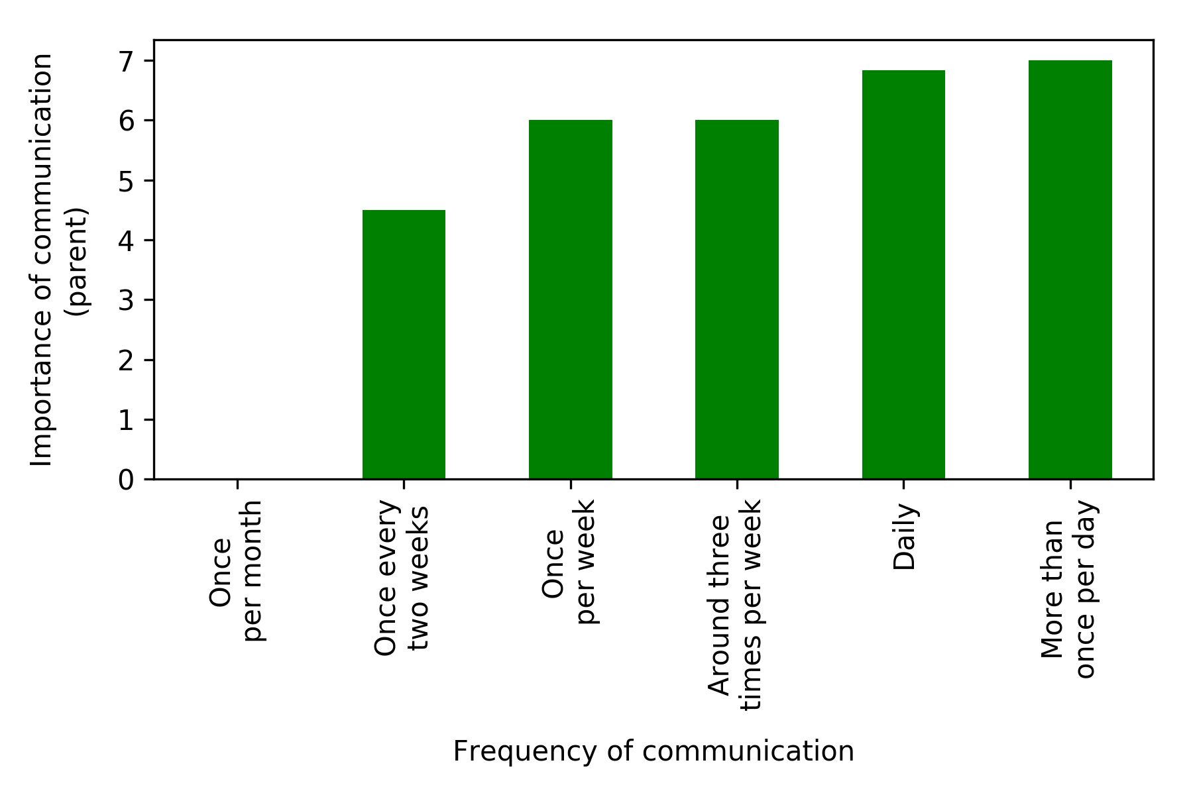
SHS/pre-processing of data/plot_8.png
