mfeo15/CHIC-NAPaC/SHS/pre-processing of data/plot_9.png

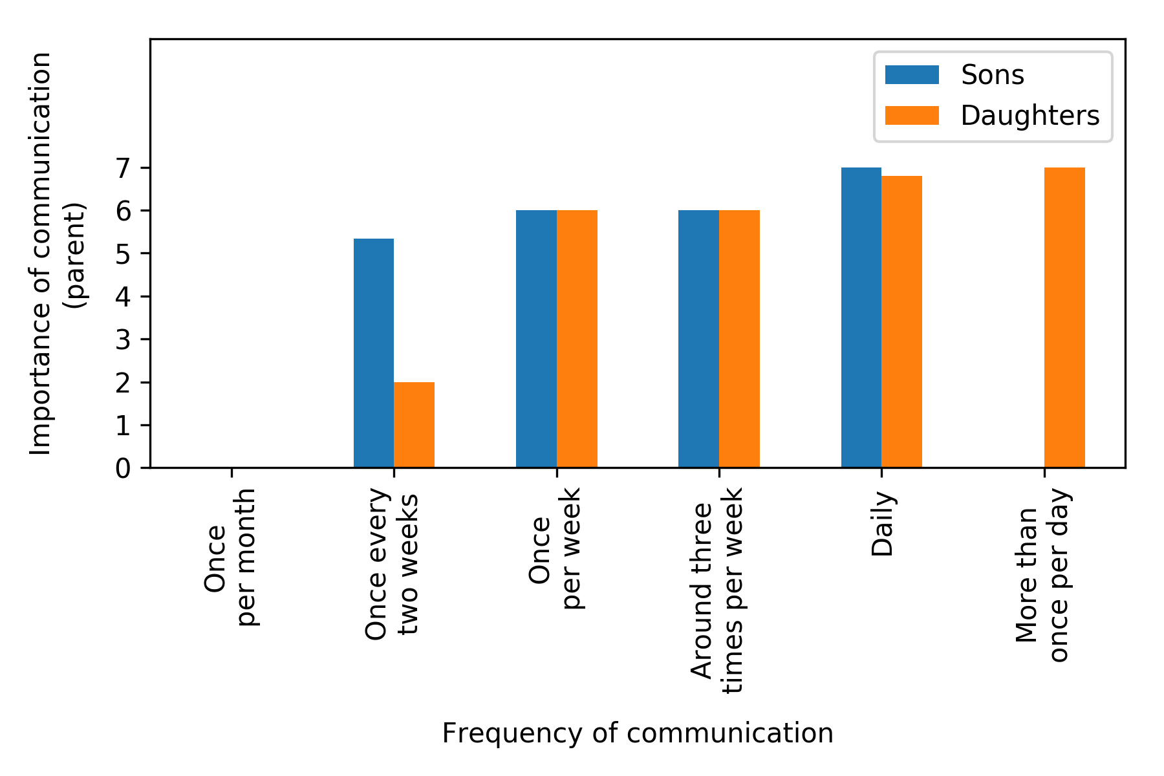
SHS/pre-processing of data/plot_9.png
