mfeo15/CHIC-NAPaC/SHS/pre-processing of data/plot_10.png

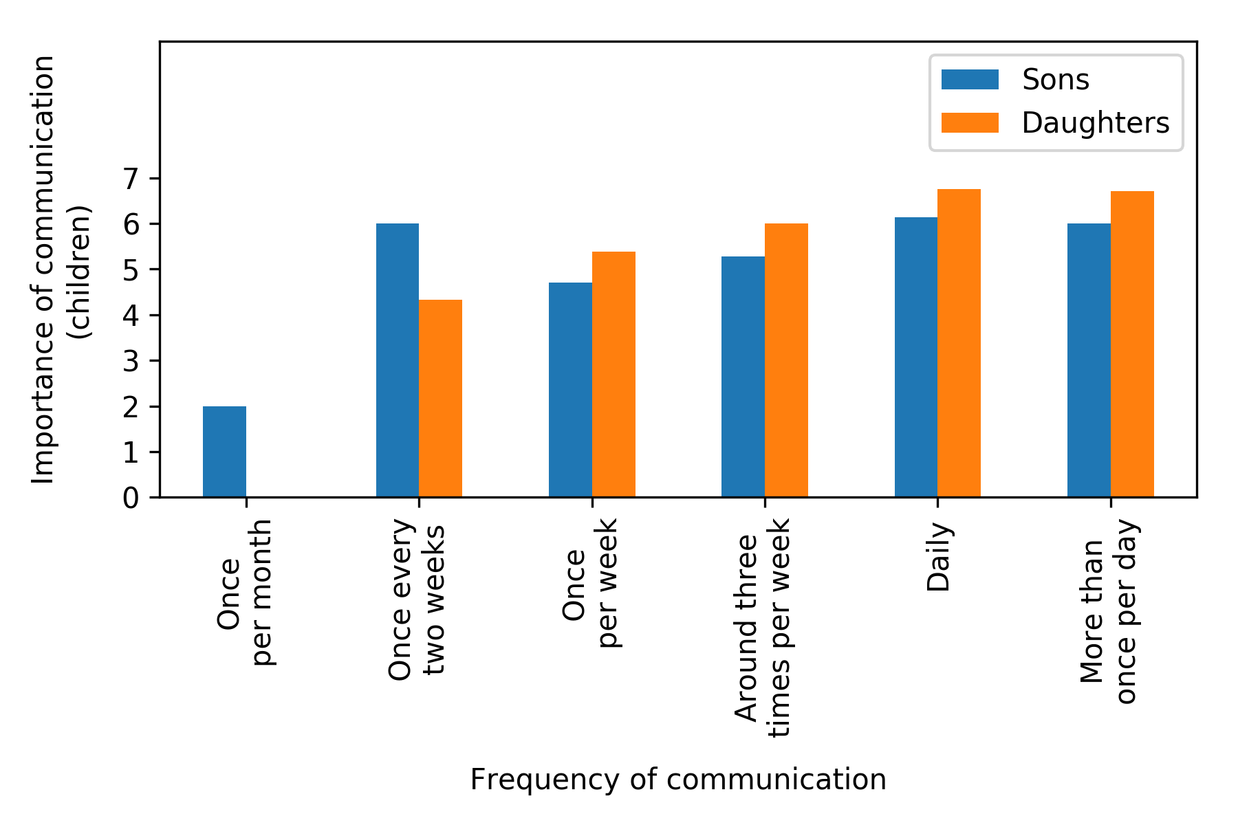
SHS/pre-processing of data/plot_10.png
