mfeo15/CHIC-NAPaC/SHS/pre-processing of data/plot_12.png

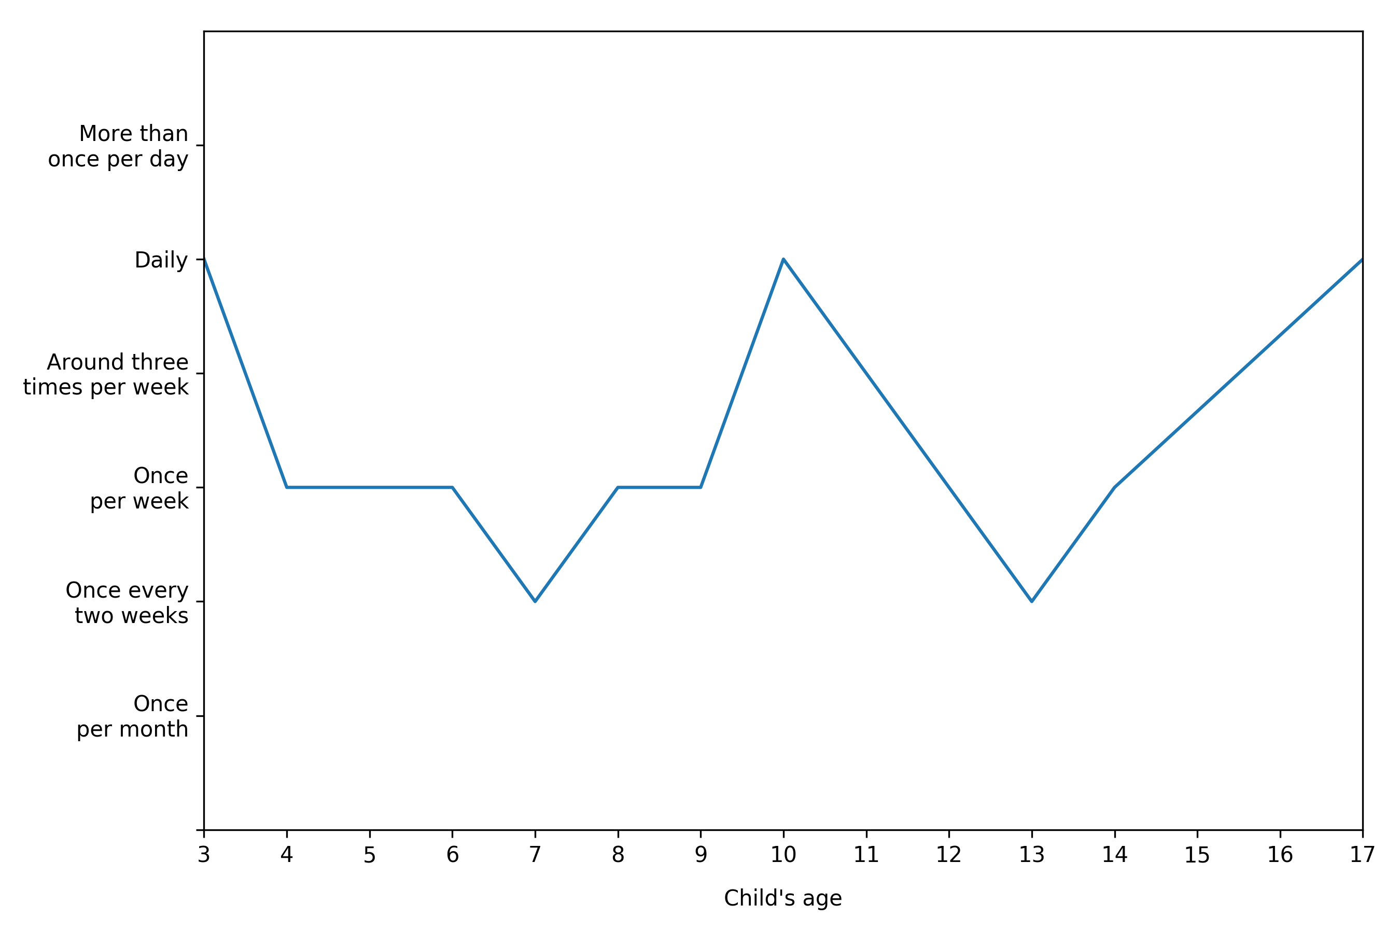
SHS/pre-processing of data/plot_12.png
