mfeo15/CHIC-NAPaC/SHS/report/plots/plot_6.png

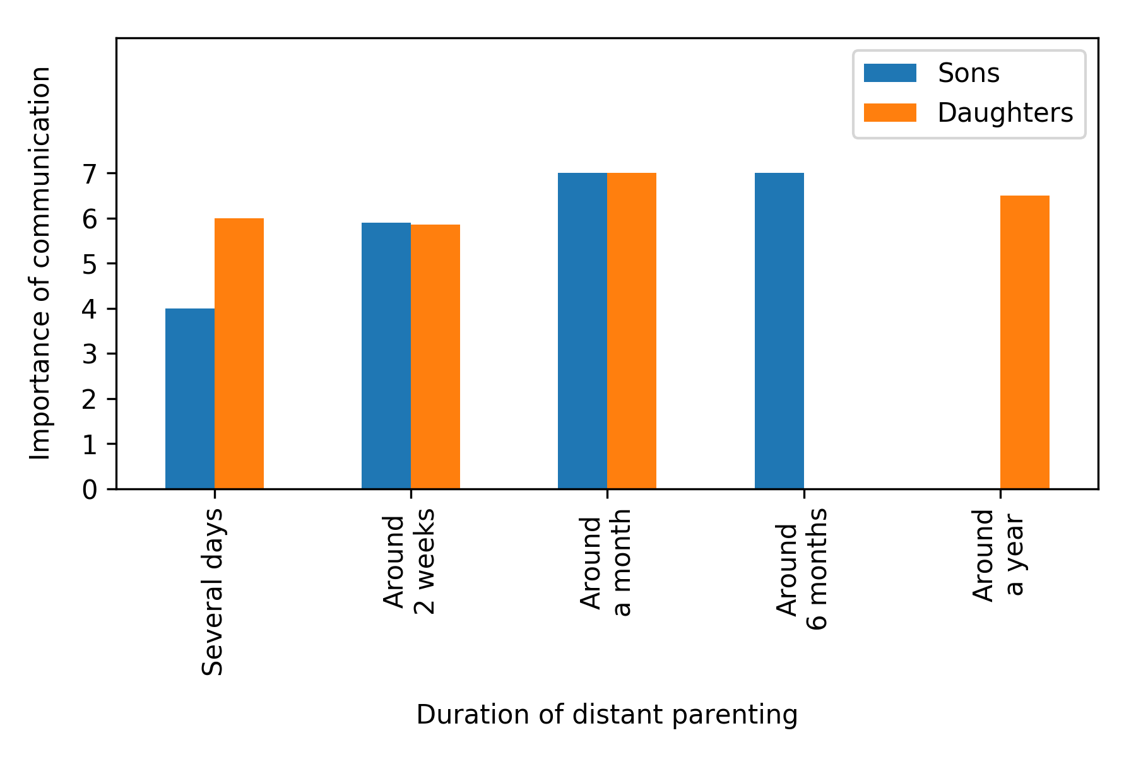
SHS/report/plots/plot_6.png
