mfeo15/CHIC-NAPaC/SHS/report/plots/plot_7.png

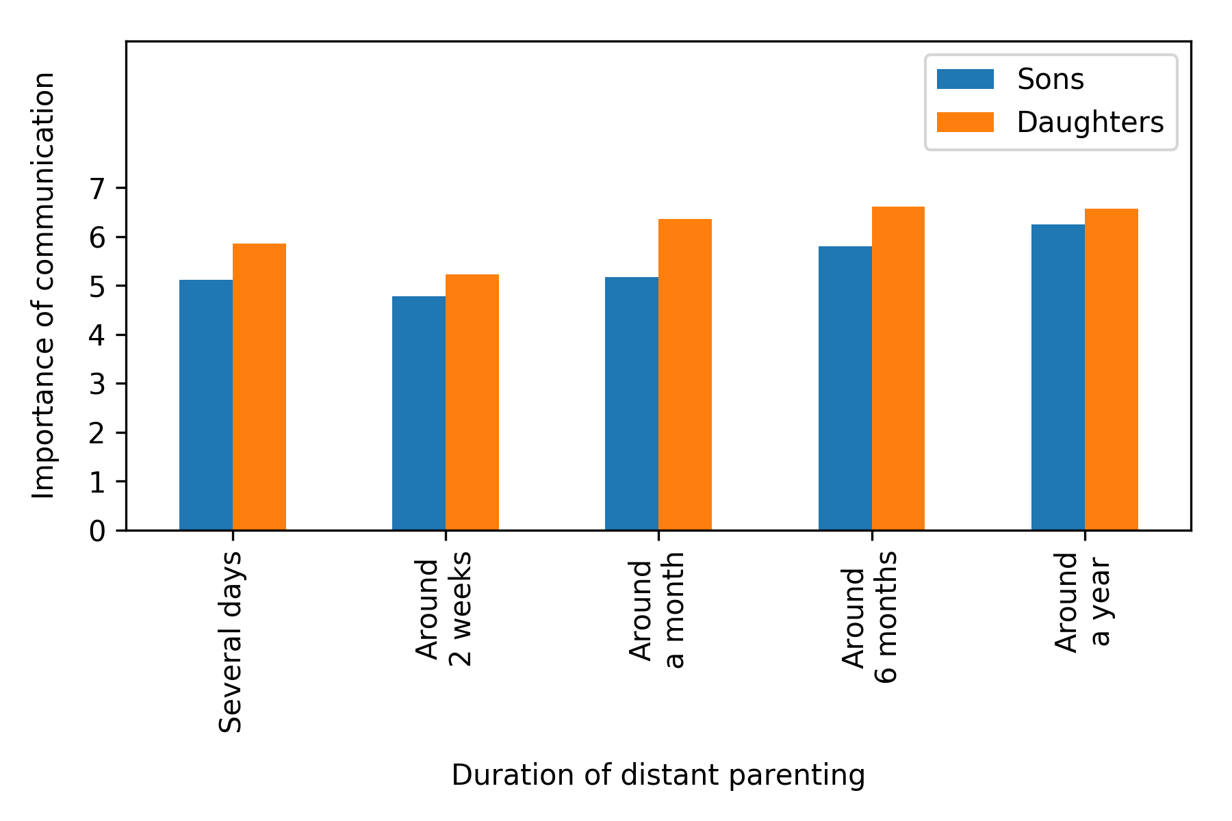
SHS/report/plots/plot_7.png
