mfeo15/CHIC-NAPaC/SHS/report/plots/plot_10.png

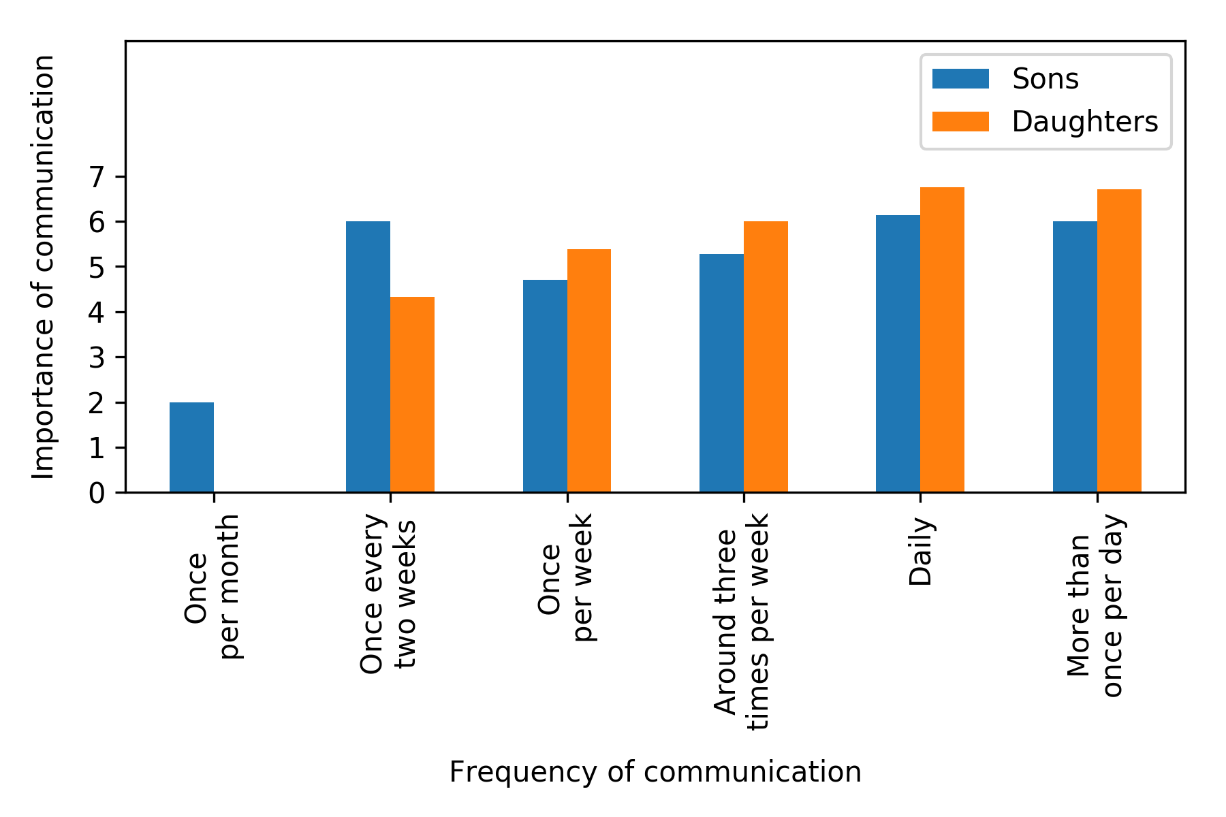
SHS/report/plots/plot_10.png
