mfeo15/CHIC-NAPaC/Project/PCB/PCB_NAPaC_Project1.xls

Description | LibRef | Designator | Supplier Order Qty 1 | Supplier Subtotal per Board 1 | Supplier Unit Price 1 | Manufacturer 1 | Manufacturer Part Number 1 | Supplier 1 | Supplier Currency 1
GRM188R71H104KA93D-0.1uF/50V(10%) | CAP-0.1uF/50V(10%) | C9, C14, C15, C19, C22 | 5 | 0.21 | 0.04 | Murata (https://octopart-clicks.com/click/altium?sku=16520001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) | GRM188R71H104KA93D (https://octopart-clicks.com/click/altium?sku=16520001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) | Distrelec | CHF
RC0402JR-0710KL | RESISTOR-10K(5%) | R11, R21, R22, R23 | 4 | 0.24 | 0.06 | Yageo (https://octopart-clicks.com/click/altium?sku=67R9964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) | RC0402JR-0710KL (https://octopart-clicks.com/click/altium?sku=67R9964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) | Newark | CHF
GRM188R61A226ME15D-22uF/10V(20%) | CAP-22uF/10V(20%) | C1, C3, C5, C21 | 4 | 1.23 | 0.31 | Murata (https://octopart-clicks.com/click/altium?sku=490-10476-6-ND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) | GRM188R61A226ME15D (https://octopart-clicks.com/click/altium?sku=490-10476-6-ND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) | Digi-Key | CHF
CDSOD323-T05LC | BidirectionalDiode | D4, D5, D6 | 3 | 2.43 | 0.81 | Bourns (https://octopart-clicks.com/click/altium?sku=652-CDSOD323-T05LC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) | CDSOD323-T05LC (https://octopart-clicks.com/click/altium?sku=652-CDSOD323-T05LC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) | Mouser | CHF
RC0402JR-070RL | RESISTOR-0R(5%) | R17, R18 | 2 | 0.12 | 0.06 | Yageo (https://octopart-clicks.com/click/altium?sku=67R9963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) | RC0402JR-070RL (https://octopart-clicks.com/click/altium?sku=67R9963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) | Newark | CHF
RC0402JR-072KL | RESISTOR-2K(5%) | R1, R24 | 2 | 0.12 | 0.06 | Yageo (https://octopart-clicks.com/click/altium?sku=67R9979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) | RC0402JR-072KL (https://octopart-clicks.com/click/altium?sku=67R9979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) | Newark | CHF
BAT760-7-Schottky Diodes & Rectifiers 0.5A 30V LF | SchottkyDiode | D3, D7 | 2 | 0.86 | 0.43 | Diodes (https://octopart-clicks.com/click/altium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) | BAT760-7 (https://octopart-clicks.com/click/altium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) | Avnet | CHF
21 Positions Header, Breakaway Connector 0.100" (2.54mm) Through Hole Tin | PINS_HEADER | J2, J3 | 2 | 0.73 | 0.37 | Sullins (https://octopart-clicks.com/click/altium?sku=S1012EC-21-ND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) | PREC021SAAN-RC (https://octopart-clicks.com/click/altium?sku=S1012EC-21-ND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) | Digi-Key | CHF
PTS645SL432LFS | SW | SW1, SW2 | 2 | 0.25 | 0.13 | ITT C&K (https://octopart-clicks.com/click/altium?sku=PTS645SL432LFS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) | PTS645SL43-2-LFS (https://octopart-clicks.com/click/altium?sku=PTS645SL432LFS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) | Avnet | CHF
Translation - Voltage Levels DUAL-BIT DUAL SUPPLY TRANSCEIVER | VOLTAGE_TRANSLATOR_3.3-5V | U4, U5 | 2 | 1.11 | 0.55 | Texas Instruments (https://octopart-clicks.com/click/altium?sku=9592768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) | SN74LVC2T45DCUT (https://octopart-clicks.com/click/altium?sku=9592768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) | Farnell | CHF
C0603X7R0J222K030BA | CAP-2.2nF/6.3V(10%) | C7 | 1 | 0.1 | 0.1 | TDK (https://octopart-clicks.com/click/altium?sku=810-C0603X7R0J222K0A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) | C0603X7R0J222K030BA (https://octopart-clicks.com/click/altium?sku=810-C0603X7R0J222K0A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) | Mouser | CHF
GRT188C80J475KE01D | CAP-0.4uF/6.3V(10%) | C20 | 1 | 0.3 | 0.3 | Murata (https://octopart-clicks.com/click/altium?sku=81-GRT188C80J475KE1D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) | GRT188C80J475KE01D (https://octopart-clicks.com/click/altium?sku=81-GRT188C80J475KE1D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) | Mouser | CHF
C0603C106M8PACTU | CAP-10µF/35V(20%) | C6 | 1 | 0.45 | 0.45 | KEMET (https://octopart-clicks.com/click/altium?sku=80-C0603C106M8PACTU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) | C0603C106M8PACTU (https://octopart-clicks.com/click/altium?sku=80-C0603C106M8PACTU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) | Mouser | CHF
RC0402F103CS | RESISTOR-10K(1%) | R6 | 1 | 0.18 | 0.18 | Samsung (https://octopart-clicks.com/click/altium?sku=1276-3530-6-ND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) | RC0402F103CS (https://octopart-clicks.com/click/altium?sku=1276-3530-6-ND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) | Digi-Key | CHF
C1608X7R1H103K080AE | CAP-10nF/50V(10%) | C8 | 1 | 0.2 | 0.2 | TDK (https://octopart-clicks.com/click/altium?sku=810-C1608X7R1H103KAE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) | C1608X7R1H103K080AE (https://octopart-clicks.com/click/altium?sku=810-C1608X7R1H103KAE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) | Mouser | CHF
RC0402JR-0715KL | RESISTOR-15K(5%) | R4 | 1 | 0 | 0 | Yageo (https://octopart-clicks.com/click/altium?sku=67R9973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) | RC0402JR-0715KL (https://octopart-clicks.com/click/altium?sku=67R9973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) | Newark | CHF
NRS8040T150MJGJ | SELF-15uH/2.4A | L1 | 1 | 0.49 | 0.49 | Taiyo Yuden (https://octopart-clicks.com/click/altium?sku=963-NRS8040T150MJGJ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) | NRS8040T150MJGJ (https://octopart-clicks.com/click/altium?sku=963-NRS8040T150MJGJ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) | Mouser | CHF
RC0402FR-0722K1L | RESISTOR-22.1K(5%) | R25 | 1 | 0 | 0 | Yageo (https://octopart-clicks.com/click/altium?sku=RC0402FR-0722K1L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) | RC0402FR-0722K1L (https://octopart-clicks.com/click/altium?sku=RC0402FR-0722K1L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) | Arrow | CHF
RC0402JR-072K7L | RESISTOR-28.7K(1%) | R5 | 1 | 0.06 | 0.06 | Yageo (https://octopart-clicks.com/click/altium?sku=67R9981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) | RC0402JR-072K7L (https://octopart-clicks.com/click/altium?sku=67R9981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) | Newark | CHF
RC0402FR-0747K5L | RESISTOR-47.5K(5%) | R26 | 1 | 0.02 | 0.02 | Yageo (https://octopart-clicks.com/click/altium?sku=2781938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) | RC0402FR-0747K5L (https://octopart-clicks.com/click/altium?sku=2781938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) | Future Electronics | CHF
USB Connectors MICRO USB B RECPT MIDDLE MNT ASSY | USB_CON8 | J1 | 1 | 1.03 | 1.03 | Molex (https://octopart-clicks.com/click/altium?sku=30076400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) | 47491-0001 (https://octopart-clicks.com/click/altium?sku=30076400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) | Distrelec | CHF
ACT4060ASH-T | SWITCHING_VOLTAGE_REGULATOR | U6 | 1 | 0.58 | 0.58 | Active-Semi (https://octopart-clicks.com/click/altium?sku=107-ACT4060ASH-T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) | ACT4060ASH-T (https://octopart-clicks.com/click/altium?sku=107-ACT4060ASH-T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) | Mouser | CHF
Diode Schottky 40V 1A 2-Pin SOD-323 T/R | SCHOTTKY_DIODE-40V/3A | D8 | 1 | 0.38 | 0.38 | Diodes (https://octopart-clicks.com/click/altium?sku=621-B140WS-7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) | B140WS-7 (https://octopart-clicks.com/click/altium?sku=621-B140WS-7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) | Mouser | CHF
CP2102N-A01-GQFN24 | CP2102N-GQFN24 | U1 | 1 | 1.33 | 1.33 | Silicon Labs (https://octopart-clicks.com/click/altium?sku=336-3693-ND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) | CP2102N-A01-GQFN24 (https://octopart-clicks.com/click/altium?sku=336-3693-ND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) | Digi-Key | CHF
ESP32-WROOM-32 | ESP-WROOM-32 | D2 | 1 | 3.75 | 3.75 | Espressif Systems (https://octopart-clicks.com/click/altium?sku=356-ESP-WROOM-32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) | ESP-WROOM-32 (https://octopart-clicks.com/click/altium?sku=356-ESP-WROOM-32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) | Mouser | CHF
LM1117IMP3.3/NOPB | LM1117-3.3 | U2 | 1 | 0.8 | 0.8 | Texas Instruments (https://octopart-clicks.com/click/altium?manufacturer=Texas%20Instruments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) | LM1117IMP-3.3/NOPB (https://octopart-clicks.com/click/altium?manufacturer=Texas%20Instruments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) | Distrelec | CHF
750-SS8050-G-BJT NPN SOT-23-3 TRANSISTOR 1.5A 40V | SS8050-G-NPN | Q1 | 1 | 0.23 | 0.23 | Comchip (https://octopart-clicks.com/click/altium?sku=750-SS8050-G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) | SS8050-G (https://octopart-clicks.com/click/altium?sku=750-SS8050-G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) | Mouser | CHF
SML-D12U1WT86-2.2V-20mA | RED_LED | D1 | 1 | 0.21 | 0.21 | Rohm (https://octopart-clicks.com/click/altium?sku=755-SML-D12U1WT86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) | SML-D12U1WT86 (https://octopart-clicks.com/click/altium?sku=755-SML-D12U1WT86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) | Mouser | CHF
48ASSP1S1M6QBT | SWITCH_SLIDE | SW3 | 1 | 2.26 | 2.26 | Wurth Electronics (https://octopart-clicks.com/click/altium?sku=11087397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) | 450302014072 (https://octopart-clicks.com/click/altium?sku=11087397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) | Distrelec | CHF
2 Positions Header, Breakaway Connector 0.100" (2.54mm) Through Hole Tin | PIN_ALIM | J4
1 Position Header, Breakaway Connector 0.100" (2.54mm) Through Hole Tin | PIN_TESTPOINT | J5
750-SS8050-G-BJT NPN SOT-23-3 TRANSISTOR 1.5A 40V | SS8050-G-NPNbis | Q2
 |  |  | TOT (CHF) | 19.67
