mfeo15/CHIC-NAPaC/Project/PCB/Project Outputs for PCB_NAPaC_Project1/PCB_NAPaC_Project1_Qt100.xls

LibRef | Quantity | Manufacturer 1 | Manufacturer Part Number 1 | Supplier Order Qty 1 | Supplier Unit Price 1 | Supplier 1 | Supplier Currency 1 | Supplier Subtotal 1
CAP-0.1uF/50V(10%) | 5 | Murata (https://octopart-clicks.com/click/altium?sku=16520001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) | GRM188R71H104KA93D (https://octopart-clicks.com/click/altium?sku=16520001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) | 500 | 0,03 | Distrelec | CHF | 15.38
RESISTOR-10K(5%) | 4 | Yageo (https://octopart-clicks.com/click/altium?sku=67R9964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) | RC0402JR-0710KL (https://octopart-clicks.com/click/altium?sku=67R9964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) | 400 | 0 | Newark | CHF | 1.19
CAP-22uF/10V(20%) | 4 | Murata (https://octopart-clicks.com/click/altium?sku=490-10476-6-ND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) | GRM188R61A226ME15D (https://octopart-clicks.com/click/altium?sku=490-10476-6-ND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) | 400 | 0,12 | Digi-Key | CHF | 48.3
BidirectionalDiode | 3 | Bourns (https://octopart-clicks.com/click/altium?sku=652-CDSOD323-T05LC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) | CDSOD323-T05LC (https://octopart-clicks.com/click/altium?sku=652-CDSOD323-T05LC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) | 300 | 0,48 | Mouser | CHF | 143.17
RESISTOR-0R(5%) | 2 | Yageo (https://octopart-clicks.com/click/altium?sku=67R9963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) | RC0402JR-070RL (https://octopart-clicks.com/click/altium?sku=67R9963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) | 200 | 0 | Newark | CHF | 0.79
RESISTOR-2K(5%) | 2 | Yageo (https://octopart-clicks.com/click/altium?sku=67R9979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) | RC0402JR-072KL (https://octopart-clicks.com/click/altium?sku=67R9979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) | 200 | 0 | Newark | CHF | 0.79
SchottkyDiode | 2 | Diodes (https://octopart-clicks.com/click/altium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) | BAT760-7 (https://octopart-clicks.com/click/altium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) | 200 | 0,3 | Avnet | CHF | 60.84
PINS_HEADER | 2 | Sullins (https://octopart-clicks.com/click/altium?sku=S1012EC-21-ND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) | PREC021SAAN-RC (https://octopart-clicks.com/click/altium?sku=S1012EC-21-ND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) | 200 | 0,27 | Digi-Key | CHF | 53.55
SW | 2 | ITT C&K (https://octopart-clicks.com/click/altium?sku=PTS645SL432LFS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) | PTS645SL43-2-LFS (https://octopart-clicks.com/click/altium?sku=PTS645SL432LFS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) | 200 | 0,11 | Avnet | CHF | 22.31
VOLTAGE_TRANSLATOR_3.3-5V | 2 | Texas Instruments (https://octopart-clicks.com/click/altium?sku=9592768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) | SN74LVC2T45DCUT (https://octopart-clicks.com/click/altium?sku=9592768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) | 200 | 0,31 | Farnell | CHF | 61.98
CAP-2.2nF/6.3V(10%) | 1 | TDK (https://octopart-clicks.com/click/altium?sku=810-C0603X7R0J222K0A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) | C0603X7R0J222K030BA (https://octopart-clicks.com/click/altium?sku=810-C0603X7R0J222K0A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) | 100 | 0,01 | Mouser | CHF | 1.38
CAP-0.4uF/6.3V(10%) | 1 | Murata (https://octopart-clicks.com/click/altium?sku=81-GRT188C80J475KE1D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) | GRT188C80J475KE01D (https://octopart-clicks.com/click/altium?sku=81-GRT188C80J475KE1D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) | 100 | 0,11 | Mouser | CHF | 11.16
CAP-10µF/35V(20%) | 1 | KEMET (https://octopart-clicks.com/click/altium?sku=80-C0603C106M8PACTU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) | C0603C106M8PACTU (https://octopart-clicks.com/click/altium?sku=80-C0603C106M8PACTU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) | 100 | 0,16 | Mouser | CHF | 15.91
RESISTOR-10K(1%) | 1 | Samsung (https://octopart-clicks.com/click/altium?sku=1276-3530-6-ND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) | RC0402F103CS (https://octopart-clicks.com/click/altium?sku=1276-3530-6-ND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) | 100 | 0,06 | Digi-Key | CHF | 5.8
CAP-10nF/50V(10%) | 1 | TDK (https://octopart-clicks.com/click/altium?sku=810-C1608X7R1H103KAE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) | C1608X7R1H103K080AE (https://octopart-clicks.com/click/altium?sku=810-C1608X7R1H103KAE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) | 100 | 0,06 | Mouser | CHF | 5.53
RESISTOR-15K(5%) | 1 | Yageo (https://octopart-clicks.com/click/altium?sku=67R9973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) | RC0402JR-0715KL (https://octopart-clicks.com/click/altium?sku=67R9973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) | 100 | 0 | Newark | CHF | 0.1
SELF-15uH/2.4A | 1 | Taiyo Yuden (https://octopart-clicks.com/click/altium?sku=963-NRS8040T150MJGJ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) | NRS8040T150MJGJ (https://octopart-clicks.com/click/altium?sku=963-NRS8040T150MJGJ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) | 100 | 0,31 | Mouser | CHF | 31.12
RESISTOR-22.1K(5%) | 1 | Yageo (https://octopart-clicks.com/click/altium?sku=RC0402FR-0722K1L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) | RC0402FR-0722K1L (https://octopart-clicks.com/click/altium?sku=RC0402FR-0722K1L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) | 100 | 0 | Arrow | CHF | 0.22
RESISTOR-28.7K(1%) | 1 | Yageo (https://octopart-clicks.com/click/altium?sku=67R9981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) | RC0402JR-072K7L (https://octopart-clicks.com/click/altium?sku=67R9981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) | 100 | 0 | Newark | CHF | 0.4
RESISTOR-47.5K(5%) | 1 | Yageo (https://octopart-clicks.com/click/altium?sku=2781938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) | RC0402FR-0747K5L (https://octopart-clicks.com/click/altium?sku=2781938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) | 100 | 0,02 | Future Electronics | CHF | 1.63
USB_CON8 | 1 | Molex (https://octopart-clicks.com/click/altium?sku=30076400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) | 47491-0001 (https://octopart-clicks.com/click/altium?sku=30076400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) | 100 | 0,84 | Distrelec | CHF | 84.32
SWITCHING_VOLTAGE_REGULATOR | 1 | Active-Semi (https://octopart-clicks.com/click/altium?sku=107-ACT4060ASH-T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) | ACT4060ASH-T (https://octopart-clicks.com/click/altium?sku=107-ACT4060ASH-T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) | 100 | 0,27 | Mouser | CHF | 26.97
SCHOTTKY_DIODE-40V/3A | 1 | Diodes (https://octopart-clicks.com/click/altium?sku=621-B140WS-7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) | B140WS-7 (https://octopart-clicks.com/click/altium?sku=621-B140WS-7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) | 100 | 0,12 | Mouser | CHF | 12.35
PIN_ALIM | 1
CP2102N-GQFN24 | 1 | Silicon Labs (https://octopart-clicks.com/click/altium?sku=336-3693-ND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) | CP2102N-A01-GQFN24 (https://octopart-clicks.com/click/altium?sku=336-3693-ND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) | 100 | 1,24 | Digi-Key | CHF | 123.93
ESP-WROOM-32 | 1 | Espressif Systems (https://octopart-clicks.com/click/altium?sku=356-ESP-WROOM-32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) | ESP-WROOM-32 (https://octopart-clicks.com/click/altium?sku=356-ESP-WROOM-32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) | 100 | 3,75 | Mouser | CHF | 375.46
LM1117-3.3 | 1 | Texas Instruments (https://octopart-clicks.com/click/altium?manufacturer=Texas%20Instruments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) | LM1117IMP-3.3/NOPB (https://octopart-clicks.com/click/altium?manufacturer=Texas%20Instruments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) | 100 | 0,66 | Distrelec | CHF | 66.09
PIN_TESTPOINT | 1
SS8050-G-NPN | 1 | Comchip (https://octopart-clicks.com/click/altium?sku=750-SS8050-G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) | SS8050-G (https://octopart-clicks.com/click/altium?sku=750-SS8050-G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) | 100 | 0,07 | Mouser | CHF | 6.72
SS8050-G-NPNbis | 1
RED_LED | 1 | Rohm (https://octopart-clicks.com/click/altium?sku=755-SML-D12U1WT86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) | SML-D12U1WT86 (https://octopart-clicks.com/click/altium?sku=755-SML-D12U1WT86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) | 100 | 0,06 | Mouser | CHF | 5.83
SWITCH_SLIDE | 1 | Wurth Electronics (https://octopart-clicks.com/click/altium?sku=11087397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) | 450302014072 (https://octopart-clicks.com/click/altium?sku=11087397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) | 100 | 1,9 | Distrelec | CHF | 190.28
TITLE_BLOCK | 1
 |  |  |  |  |  |  | TOT (CHF) (100 PCB) | 1373.5
 |  |  |  |  |  |  | Per PCB | 13.735
