mfeo15/CHIC-NAPaC/Project/PCB/Project Outputs for PCB_NAPaC_Project1/PCB_NAPaC_Project1_Qt1000.xls

LibRef | Quantity | Manufacturer 1 | Manufacturer Part Number 1 | Supplier Order Qty 1 | Supplier Unit Price 1 | Supplier 1 | Supplier Currency 1 | Supplier Subtotal 1
CAP-0.1uF/50V(10%) | 5 | Murata (https://octopart-clicks.com/click/altium?sku=16520001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) | GRM188R71H104KA93D (https://octopart-clicks.com/click/altium?sku=16520001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) | 5000 | 0,02 | Distrelec | CHF | 116.79
RESISTOR-10K(5%) | 4 | Yageo (https://octopart-clicks.com/click/altium?sku=67R9964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) | RC0402JR-0710KL (https://octopart-clicks.com/click/altium?sku=67R9964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) | 4000 | 0 | Newark | CHF | 7.9
CAP-22uF/10V(20%) | 4 | Murata (https://octopart-clicks.com/click/altium?sku=490-10476-6-ND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) | GRM188R61A226ME15D (https://octopart-clicks.com/click/altium?sku=490-10476-6-ND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) | 4000 | 0,07 | Digi-Key | CHF | 298.27
BidirectionalDiode | 3 | Bourns (https://octopart-clicks.com/click/altium?sku=652-CDSOD323-T05LC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) | CDSOD323-T05LC (https://octopart-clicks.com/click/altium?sku=652-CDSOD323-T05LC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) | 3000 | 0,33 | Mouser | CHF | 975.2
RESISTOR-0R(5%) | 2 | Yageo (https://octopart-clicks.com/click/altium?sku=67R9963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) | RC0402JR-070RL (https://octopart-clicks.com/click/altium?sku=67R9963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) | 2000 | 0 | Newark | CHF | 3.95
RESISTOR-2K(5%) | 2 | Yageo (https://octopart-clicks.com/click/altium?sku=67R9979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) | RC0402JR-072KL (https://octopart-clicks.com/click/altium?sku=67R9979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) | 2000 | 0 | Newark | CHF | 3.95
SchottkyDiode | 2 | Diodes (https://octopart-clicks.com/click/altium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) | BAT760-7 (https://octopart-clicks.com/click/altium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) | 2000 | 0,27 | Avnet | CHF | 541.25
PINS_HEADER | 2 | Sullins (https://octopart-clicks.com/click/altium?sku=S1012EC-21-ND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) | PREC021SAAN-RC (https://octopart-clicks.com/click/altium?sku=S1012EC-21-ND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) | 2000 | 0,18 | Digi-Key | CHF | 363.42
SW | 2 | ITT C&K (https://octopart-clicks.com/click/altium?sku=PTS645SL432LFS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) | PTS645SL43-2-LFS (https://octopart-clicks.com/click/altium?sku=PTS645SL432LFS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) | 2000 | 0,11 | Avnet | CHF | 223.1
VOLTAGE_TRANSLATOR_3.3-5V | 2 | Texas Instruments (https://octopart-clicks.com/click/altium?sku=9592768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) | SN74LVC2T45DCUT (https://octopart-clicks.com/click/altium?sku=9592768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) | 2000 | 0,23 | Farnell | CHF | 451.21
CAP-2.2nF/6.3V(10%) | 1 | TDK (https://octopart-clicks.com/click/altium?sku=810-C0603X7R0J222K0A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) | C0603X7R0J222K030BA (https://octopart-clicks.com/click/altium?sku=810-C0603X7R0J222K0A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) | 1000 | 0,01 | Mouser | CHF | 8.89
CAP-0.4uF/6.3V(10%) | 1 | Murata (https://octopart-clicks.com/click/altium?sku=81-GRT188C80J475KE1D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) | GRT188C80J475KE01D (https://octopart-clicks.com/click/altium?sku=81-GRT188C80J475KE1D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) | 1000 | 0,07 | Mouser | CHF | 69.16
CAP-10µF/35V(20%) | 1 | KEMET (https://octopart-clicks.com/click/altium?sku=80-C0603C106M8PACTU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) | C0603C106M8PACTU (https://octopart-clicks.com/click/altium?sku=80-C0603C106M8PACTU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) | 1000 | 0,13 | Mouser | CHF | 130.42
RESISTOR-10K(1%) | 1 | Samsung (https://octopart-clicks.com/click/altium?sku=1276-3530-6-ND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) | RC0402F103CS (https://octopart-clicks.com/click/altium?sku=1276-3530-6-ND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) | 1000 | 0,02 | Digi-Key | CHF | 24.26
CAP-10nF/50V(10%) | 1 | TDK (https://octopart-clicks.com/click/altium?sku=810-C1608X7R1H103KAE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) | C1608X7R1H103K080AE (https://octopart-clicks.com/click/altium?sku=810-C1608X7R1H103KAE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) | 1000 | 0,04 | Mouser | CHF | 37.55
RESISTOR-15K(5%) | 1 | Yageo (https://octopart-clicks.com/click/altium?sku=67R9973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) | RC0402JR-0715KL (https://octopart-clicks.com/click/altium?sku=67R9973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) | 1000 | 0 | Newark | CHF | 0.99
SELF-15uH/2.4A | 1 | Taiyo Yuden (https://octopart-clicks.com/click/altium?sku=963-NRS8040T150MJGJ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) | NRS8040T150MJGJ (https://octopart-clicks.com/click/altium?sku=963-NRS8040T150MJGJ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) | 1000 | 0,19 | Mouser | CHF | 185.75
RESISTOR-22.1K(5%) | 1 | Yageo (https://octopart-clicks.com/click/altium?sku=RC0402FR-0722K1L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) | RC0402FR-0722K1L (https://octopart-clicks.com/click/altium?sku=RC0402FR-0722K1L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) | 1000 | 0 | Arrow | CHF | 1.58
RESISTOR-28.7K(1%) | 1 | Yageo (https://octopart-clicks.com/click/altium?sku=67R9981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) | RC0402JR-072K7L (https://octopart-clicks.com/click/altium?sku=67R9981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) | 1000 | 0 | Newark | CHF | 1.98
RESISTOR-47.5K(5%) | 1 | Yageo (https://octopart-clicks.com/click/altium?sku=2781938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) | RC0402FR-0747K5L (https://octopart-clicks.com/click/altium?sku=2781938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) | 1000 | 0,02 | Future Electronics | CHF | 15.12
USB_CON8 | 1 | Molex (https://octopart-clicks.com/click/altium?sku=30076400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) | 47491-0001 (https://octopart-clicks.com/click/altium?sku=30076400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) | 1000 | 0,84 | Distrelec | CHF | 843.18
SWITCHING_VOLTAGE_REGULATOR | 1 | Active-Semi (https://octopart-clicks.com/click/altium?sku=107-ACT4060ASH-T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) | ACT4060ASH-T (https://octopart-clicks.com/click/altium?sku=107-ACT4060ASH-T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) | 1000 | 0,2 | Mouser | CHF | 202.55
SCHOTTKY_DIODE-40V/3A | 1 | Diodes (https://octopart-clicks.com/click/altium?sku=621-B140WS-7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) | B140WS-7 (https://octopart-clicks.com/click/altium?sku=621-B140WS-7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) | 1000 | 0,1 | Mouser | CHF | 97.82
PIN_ALIM | 1
CP2102N-GQFN24 | 1 | Silicon Labs (https://octopart-clicks.com/click/altium?sku=336-3693-ND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) | CP2102N-A01-GQFN24 (https://octopart-clicks.com/click/altium?sku=336-3693-ND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) | 1000 | 1,16 | Digi-Key | CHF | 1161.17
ESP-WROOM-32 | 1 | Espressif Systems (https://octopart-clicks.com/click/altium?sku=356-ESP-WROOM-32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) | ESP-WROOM-32 (https://octopart-clicks.com/click/altium?sku=356-ESP-WROOM-32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) | 1000 | 3,75 | Mouser | CHF | 3754.59
LM1117-3.3 | 1 | Texas Instruments (https://octopart-clicks.com/click/altium?manufacturer=Texas%20Instruments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) | LM1117IMP-3.3/NOPB (https://octopart-clicks.com/click/altium?manufacturer=Texas%20Instruments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) | 1000 | 0,66 | Distrelec | CHF | 660.87
PIN_TESTPOINT | 1
SS8050-G-NPN | 1 | Comchip (https://octopart-clicks.com/click/altium?sku=750-SS8050-G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) | SS8050-G (https://octopart-clicks.com/click/altium?sku=750-SS8050-G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) | 1000 | 0,04 | Mouser | CHF | 42.49
SS8050-G-NPNbis | 1
RED_LED | 1 | Rohm (https://octopart-clicks.com/click/altium?sku=755-SML-D12U1WT86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) | SML-D12U1WT86 (https://octopart-clicks.com/click/altium?sku=755-SML-D12U1WT86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) | 1000 | 0,04 | Mouser | CHF | 39.52
SWITCH_SLIDE | 1 | Wurth Electronics (https://octopart-clicks.com/click/altium?sku=11087397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) | 450302014072 (https://octopart-clicks.com/click/altium?sku=11087397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) | 1000 | 1,9 | Distrelec | CHF | 1902.85
TITLE_BLOCK | 1
 |  |  |  |  |  |  | TOT (CHF) (1000 PCB) | 12165.78
 |  |  |  |  |  |  | Per PCB | 12.16578
