mfeo15/CHIC-NAPaC/Project/PCB/Project Outputs for PCB_NAPaC_Project1/BOM.PNG

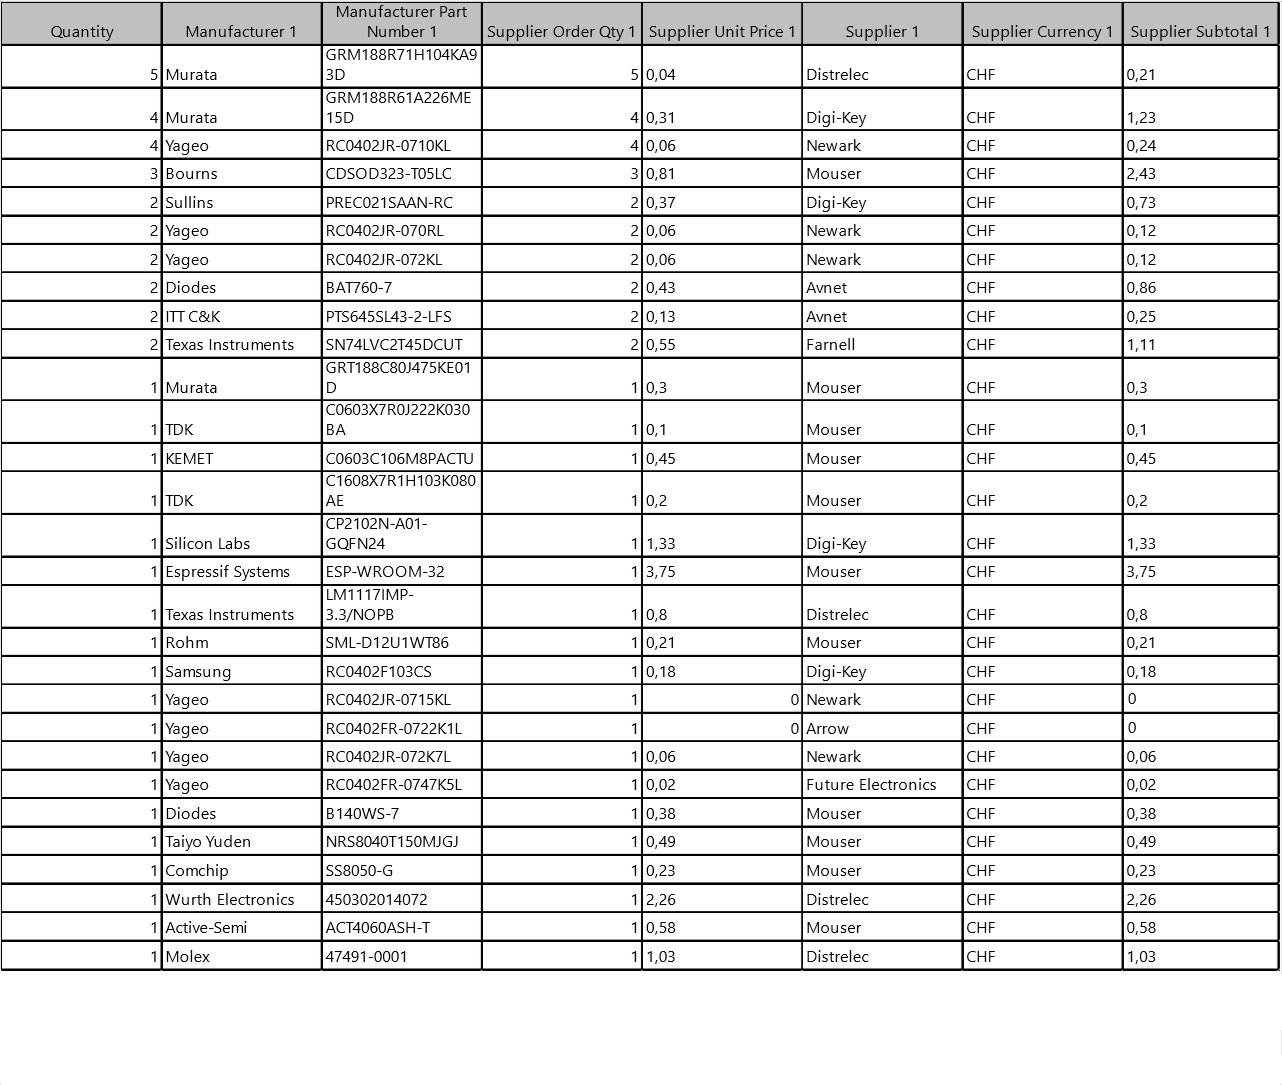
Project/PCB/Project Outputs for PCB_NAPaC_Project1/BOM.PNG
