mfeo15/CHIC-NAPaC/Project/PCB/NAPaC_DetachableModule.step

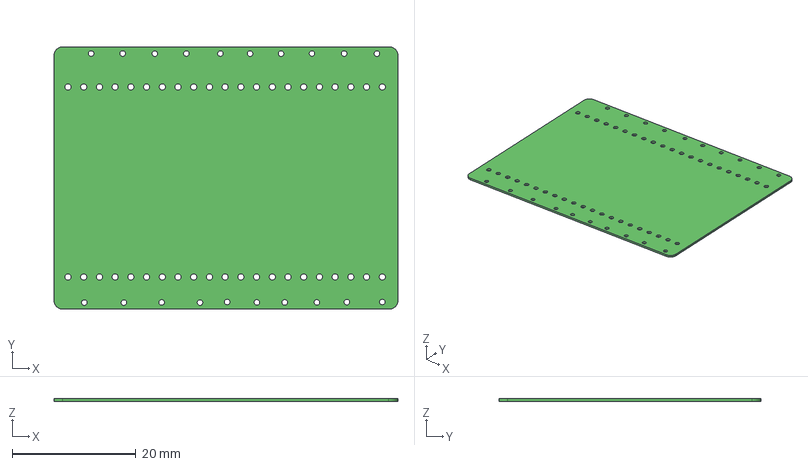
[picture p106: CAD file, 2018-06-01]
Project/PCB/NAPaC_DetachableModule.step
55.6 x 42.4 x 0.411 mm
