mfeo15/CHIC-NAPaC/(list of files, cad)

Other CAD files:
Project/PCB/oldPCB/NAPaC_DetachableModule.step
