mfeo15/CHIC-NAPaC/Project/PCB/Project Outputs for PCB_NAPaC_Project1/Job2.PDF

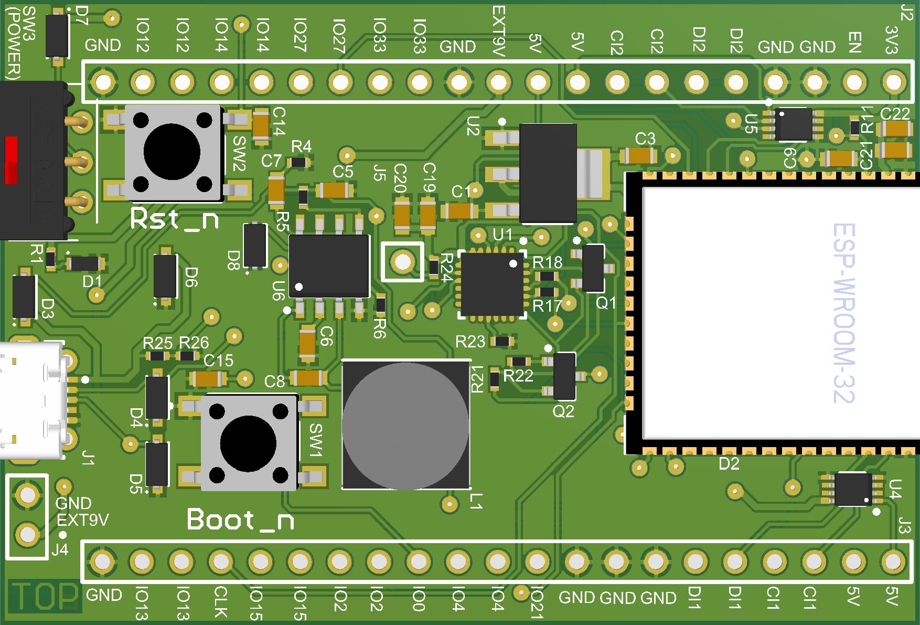
[picture p107: page 1]

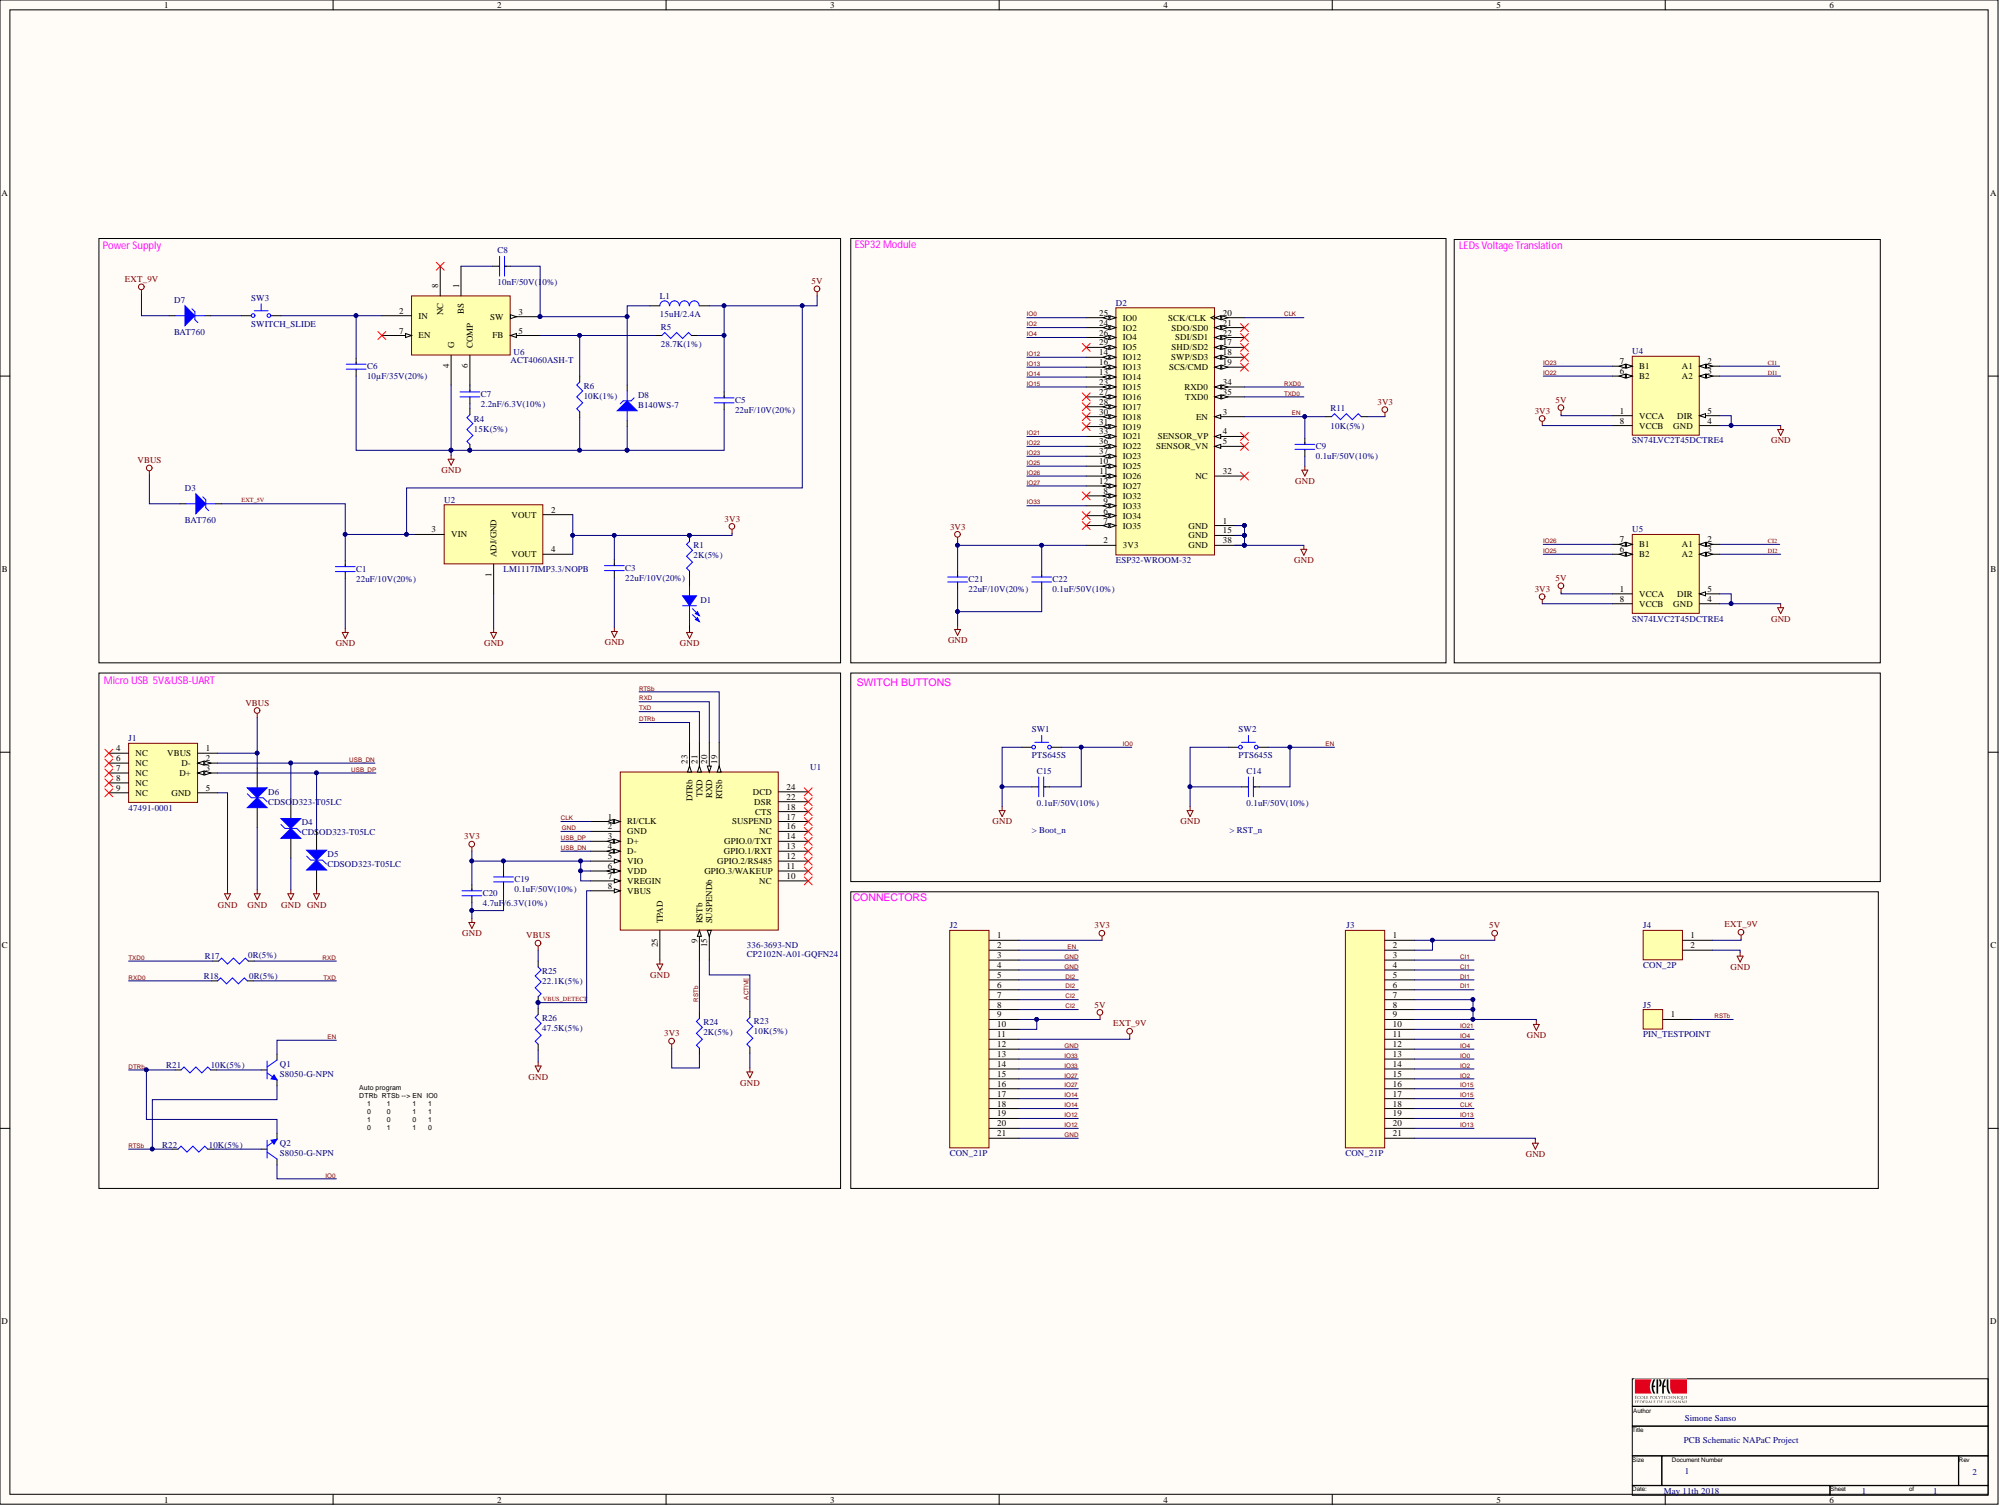
[picture p108: page 2]

Micro USB 5V&USB-UART

PCB Schematic NAPaC Project

Size | Document Number 1 | Rev 2

Date: May 11th 2018 | Sheet 1 of 1

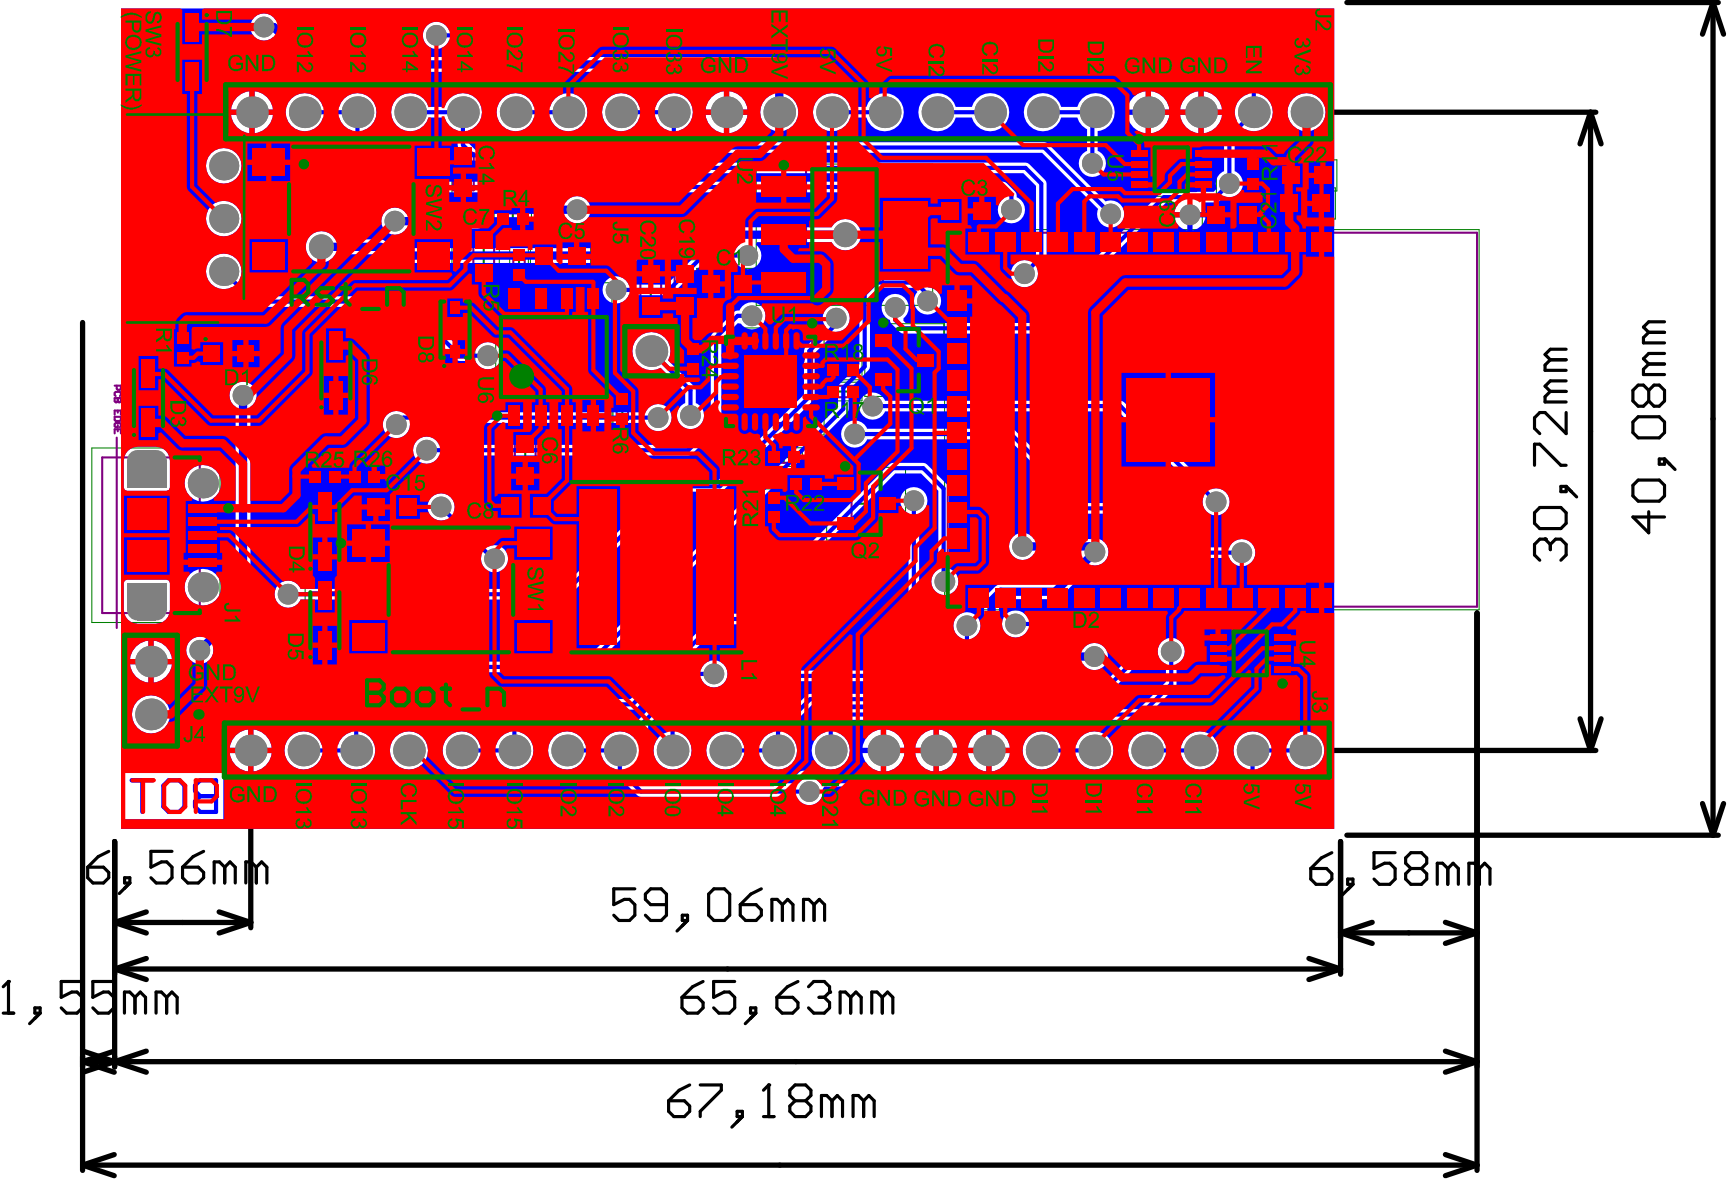
[picture p109: page 3]
