mfeo15/CHIC-NAPaC/SHS/report/InterviewProtocol_V2.pdf

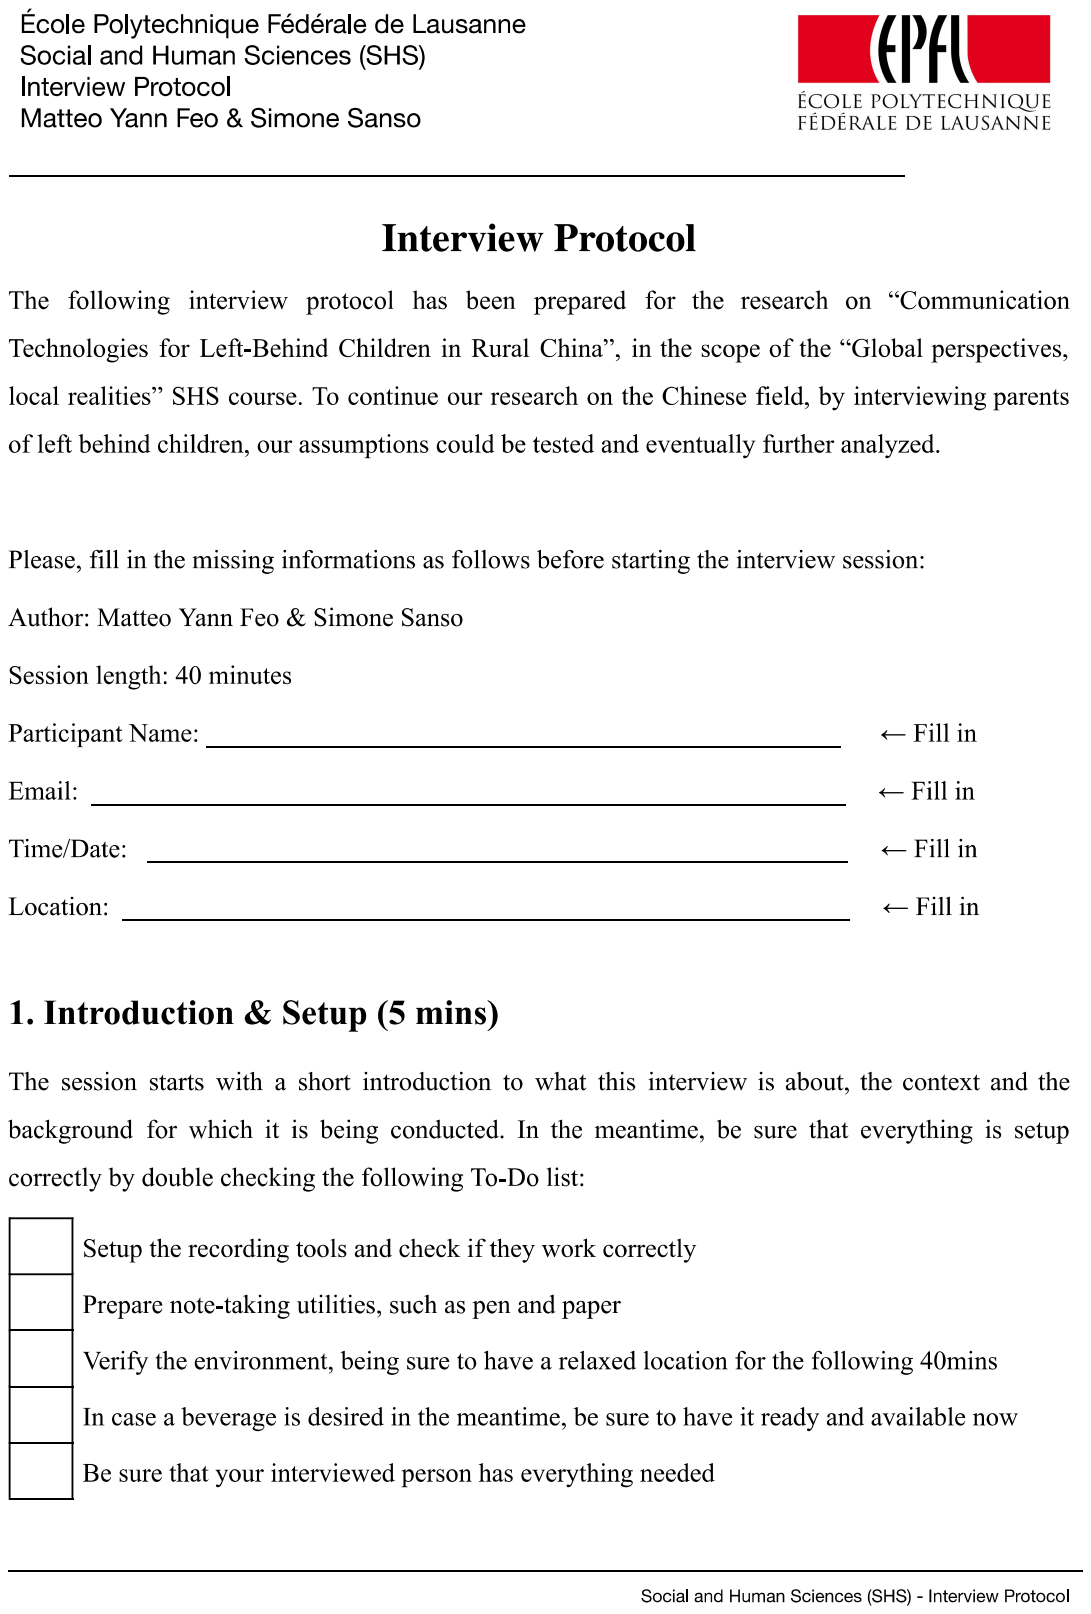
[picture p110: page 1]

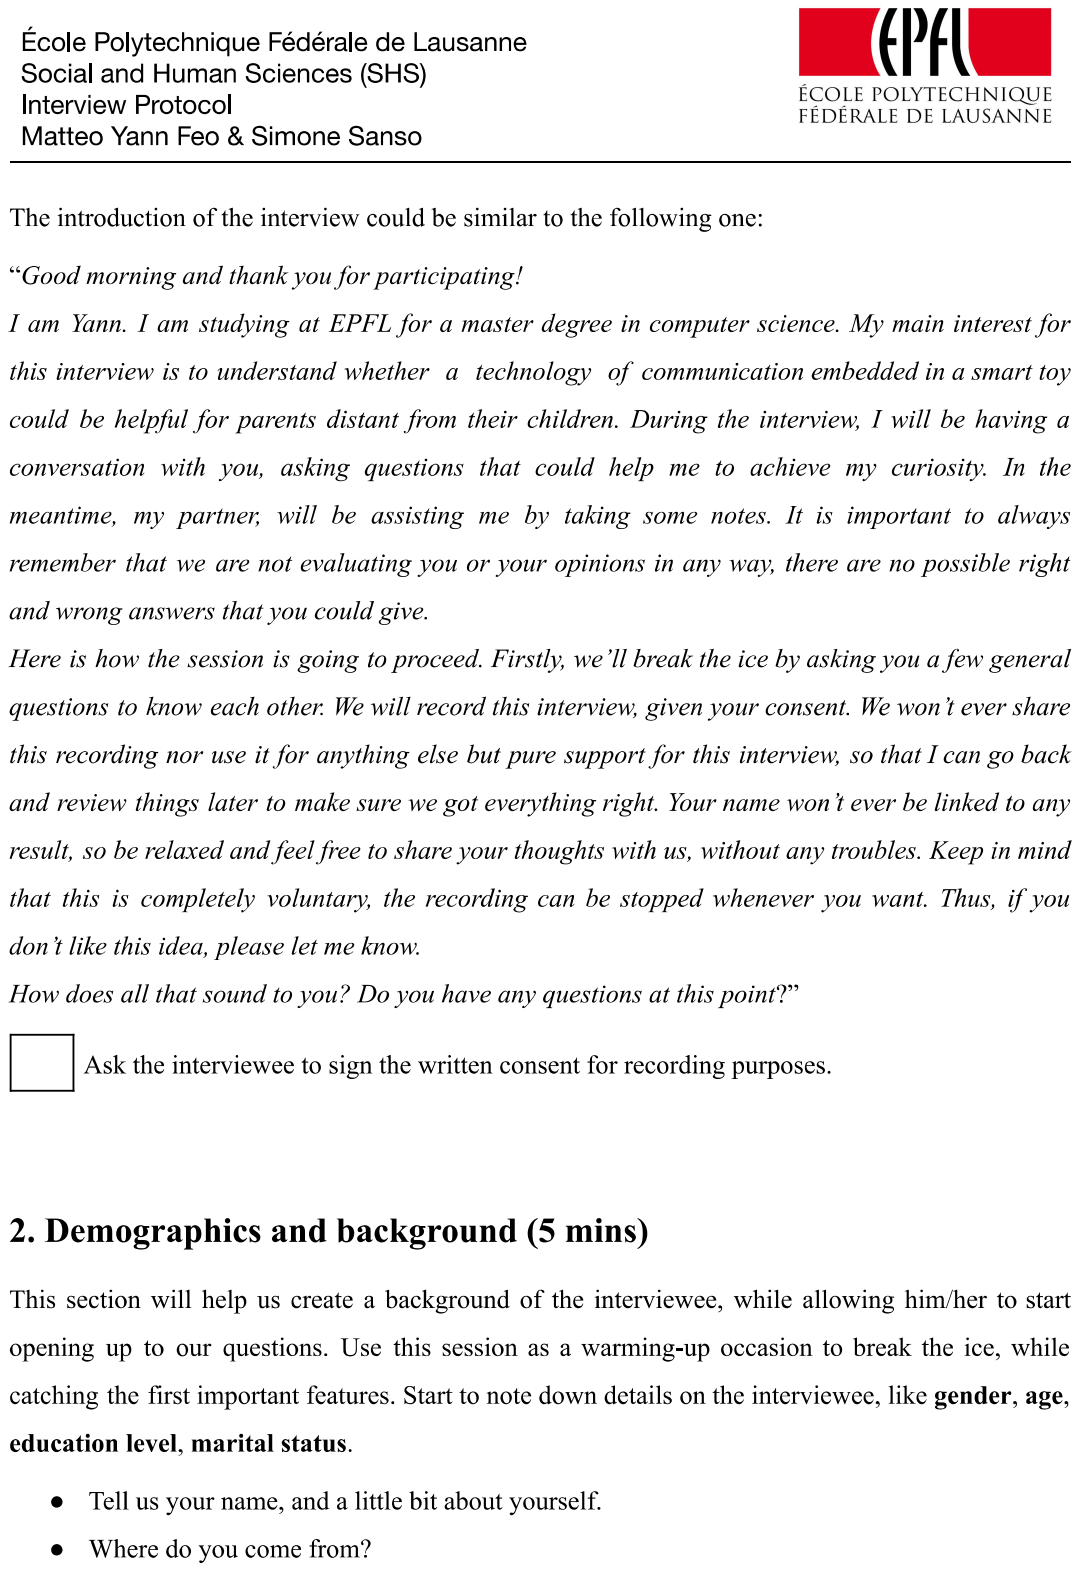
[picture p111: page 2]

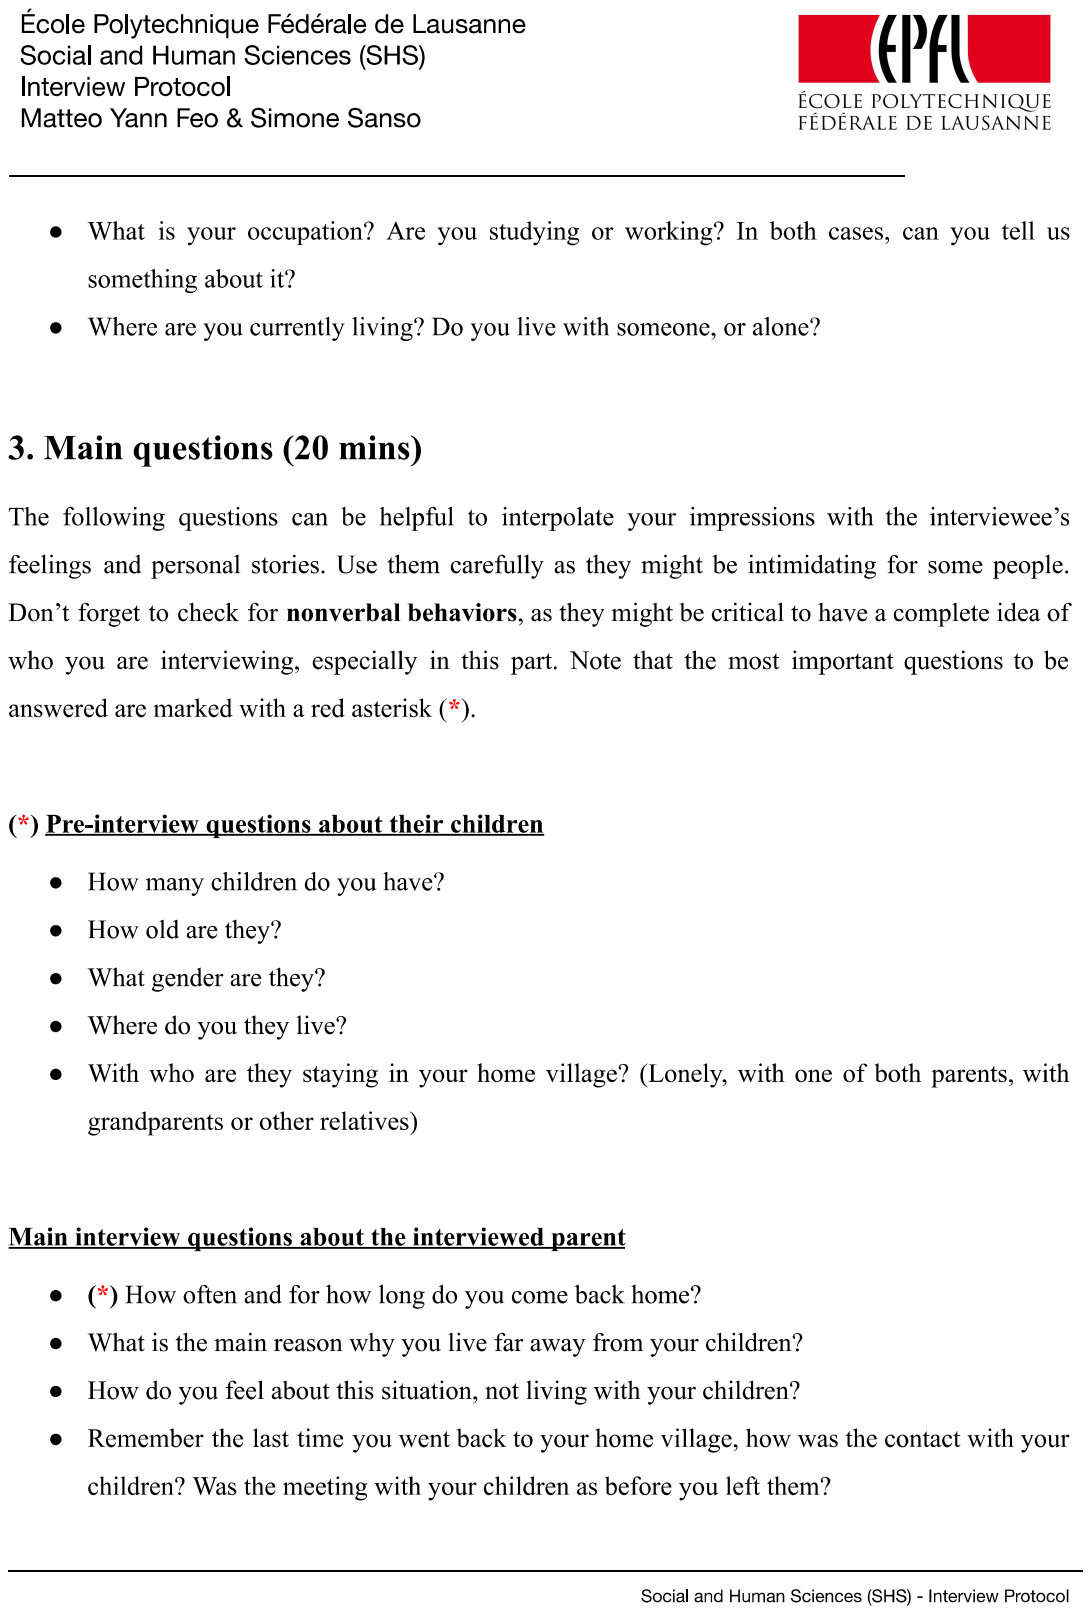
[picture p112: page 3]

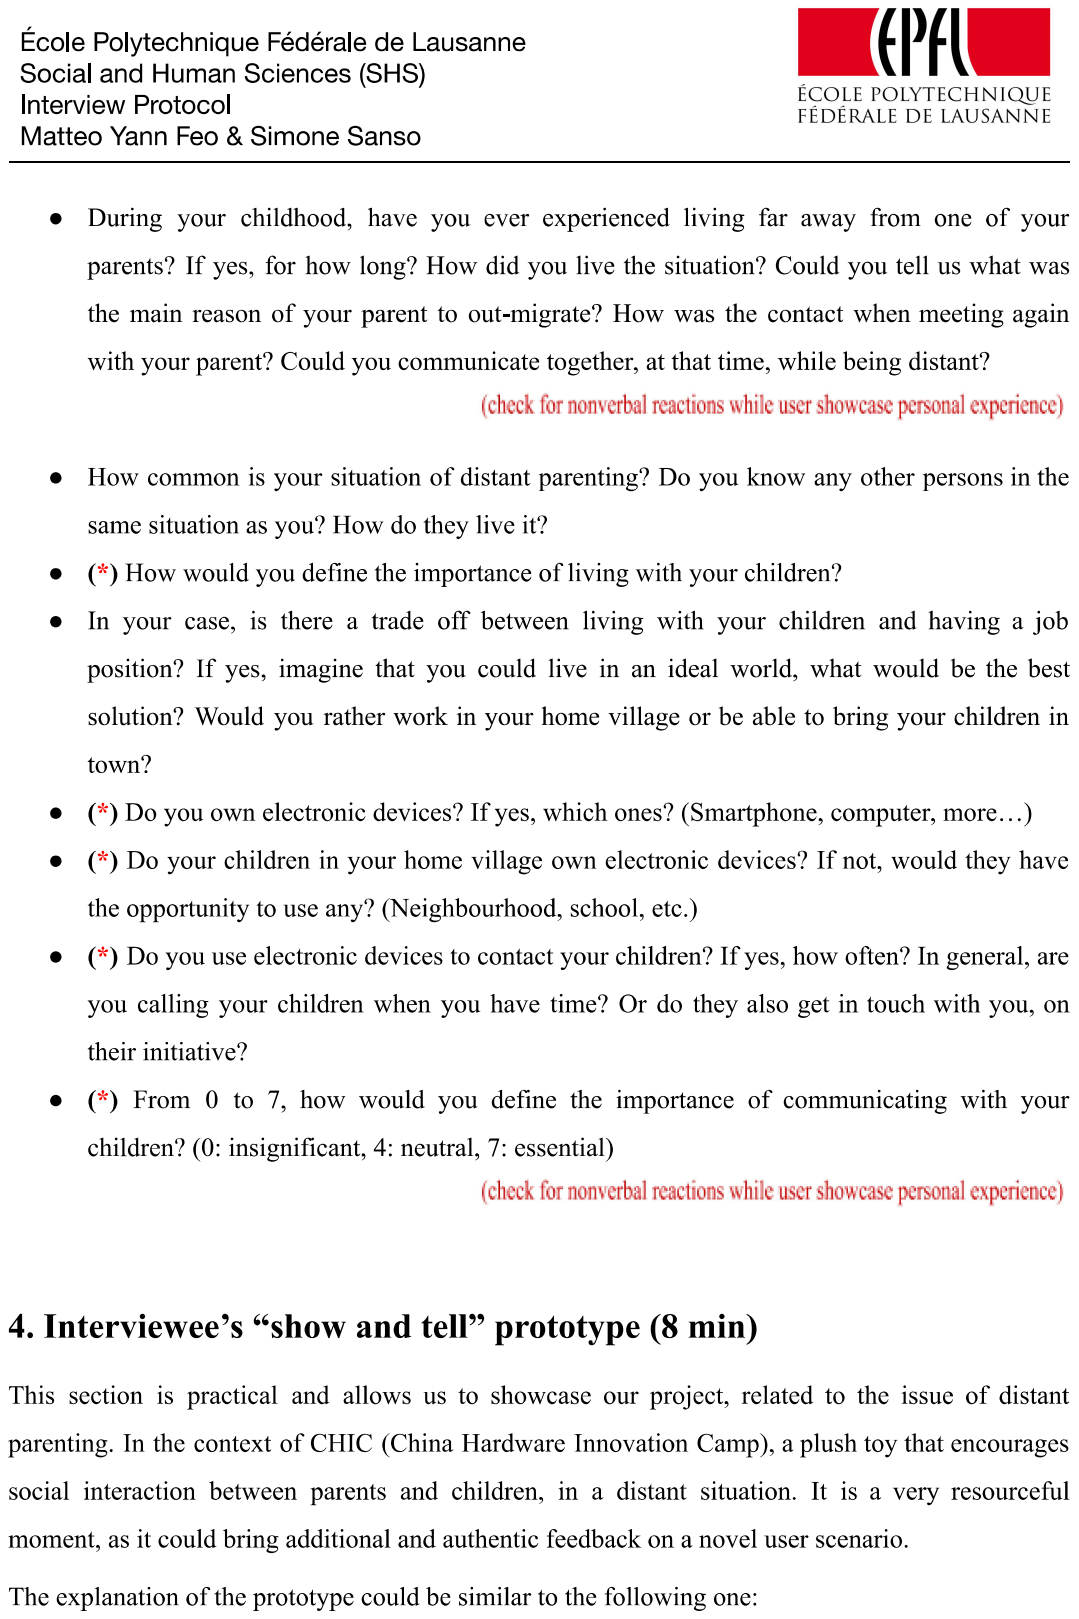
[picture p113: page 4]

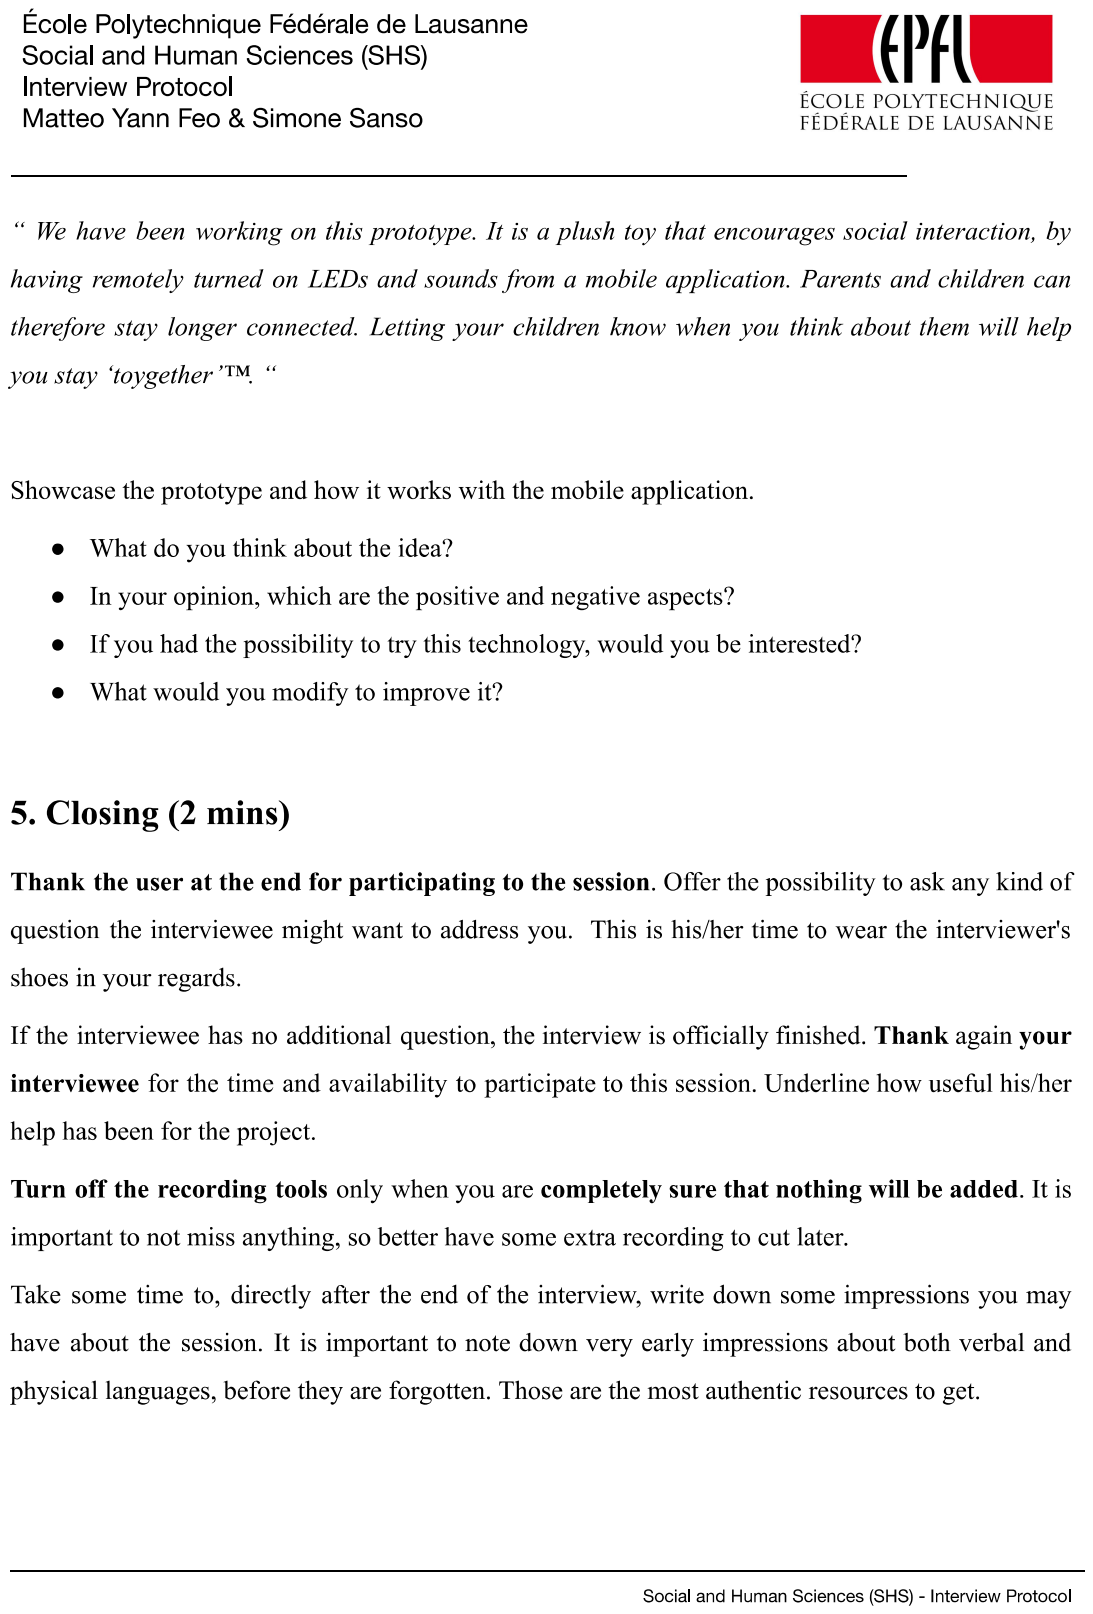
[picture p114: page 5]
