mfeo15/CHIC-NAPaC/Project/PCB/Project Outputs for NAPaC_DetachableModule/Job1.PDF

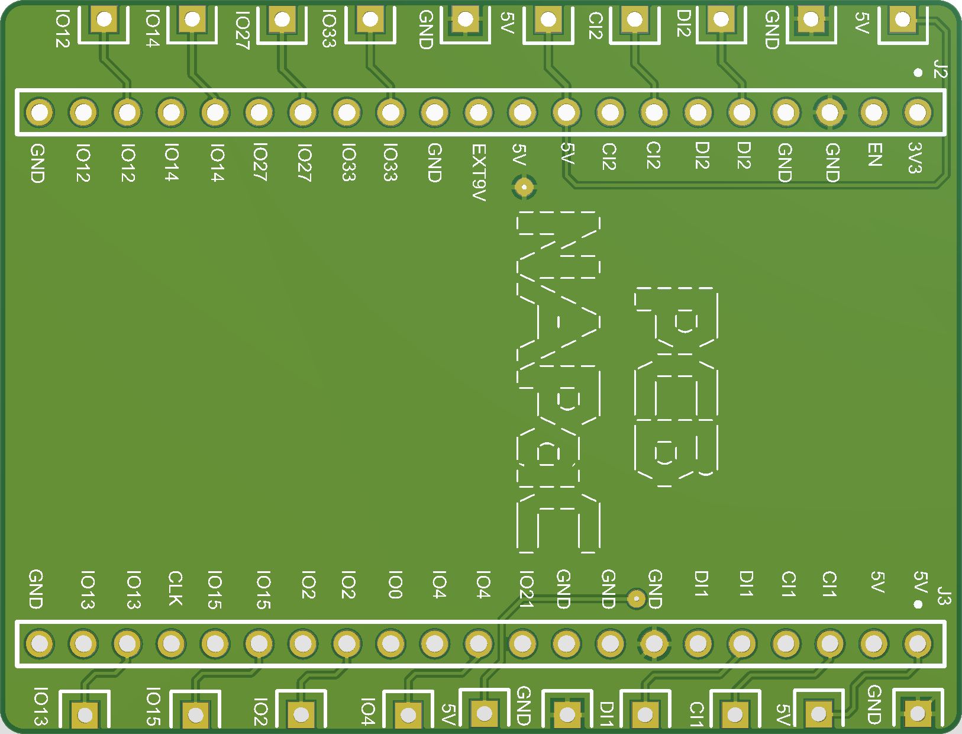
[picture p115: page 1]

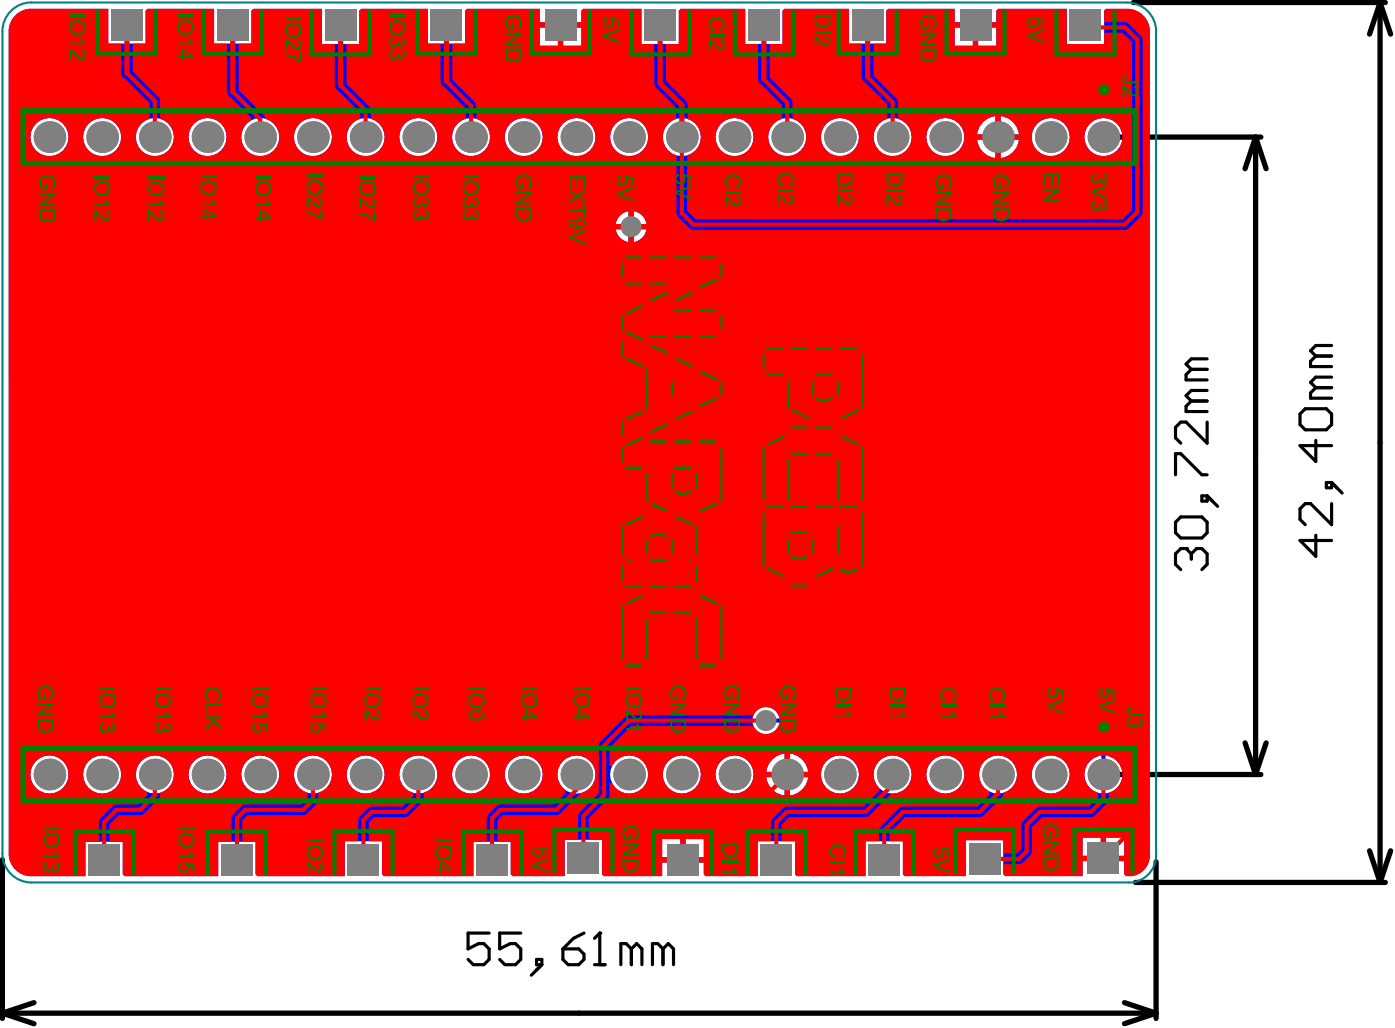
[picture p116: page 2]

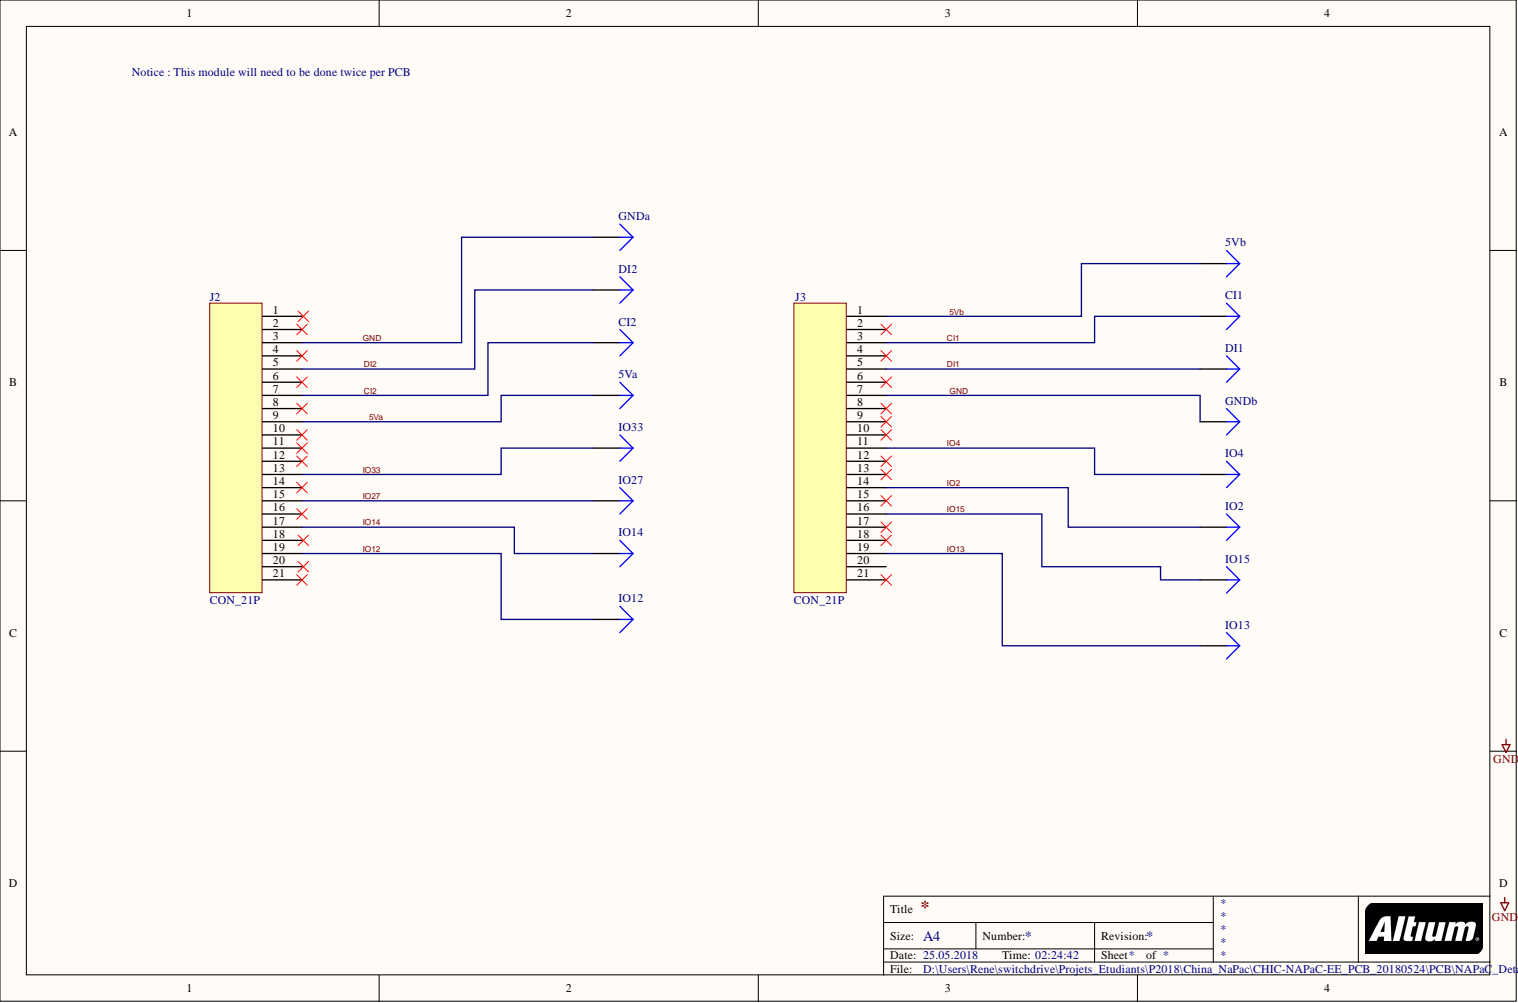
[picture p117: page 3]

Size: A 4 | N umber: * | Rev i s i o n : *
Date: 2 5.0 5.2 0 1 8 T ime: 0 2 : 2 4 : 4 2 | | Sheet * o f *
