mfeo15/CHIC-NAPaC/(list of files, drawings)

Other design files:
Project/PCB/ExportIntLib/MOLEX-MICRO-USB/MOLEX-MICRO-USB.PcbLib
Project/PCB/ExportIntLib/MOLEX-MICRO-USB/MOLEX-MICRO-USB.SchLib
Project/PCB/ExportIntLib/OLMX-ESP-WROOM-32/OLMX-ESP-WROOM-32.PcbLib
Project/PCB/ExportIntLib/OLMX-ESP-WROOM-32/OLMX-ESP-WROOM-32.SchLib
Project/PCB/ExportIntLib/SW_BUTTON/SW_BUTTON.PcbLib
Project/PCB/ExportIntLib/SW_BUTTON/SW_BUTTON.SchLib
Project/PCB/NAPaC.SchDoc
Project/PCB/NAPaC_DetachableModule.PcbDoc
Project/PCB/NAPaC_DetachableModule.PrjPCB
Project/PCB/NAPaC_DetachableModule.SchDoc
Project/PCB/NAPaC_DetachableModule_PcbLib.PcbLib
Project/PCB/NAPaC_PCB1.PcbDoc
Project/PCB/NAPaC_PcbLib.PcbLib
Project/PCB/NAPaC_Schlib.SchLib
Project/PCB/oldPCB/ExportIntLib/MOLEX-MICRO-USB/MOLEX-MICRO-USB.PcbLib
Project/PCB/oldPCB/ExportIntLib/MOLEX-MICRO-USB/MOLEX-MICRO-USB.SchLib
Project/PCB/oldPCB/ExportIntLib/OLMX-ESP-WROOM-32/OLMX-ESP-WROOM-32.PcbLib
Project/PCB/oldPCB/ExportIntLib/OLMX-ESP-WROOM-32/OLMX-ESP-WROOM-32.SchLib
Project/PCB/oldPCB/ExportIntLib/SW_BUTTON/SW_BUTTON.PcbLib
Project/PCB/oldPCB/ExportIntLib/SW_BUTTON/SW_BUTTON.SchLib
Project/PCB/oldPCB/NAPaC.SchDoc
Project/PCB/oldPCB/NAPaC_DetachableModule.PcbDoc
Project/PCB/oldPCB/NAPaC_DetachableModule.PrjPCB
Project/PCB/oldPCB/NAPaC_DetachableModule.SchDoc
Project/PCB/oldPCB/NAPaC_DetachableModule_PcbLib.PcbLib
Project/PCB/oldPCB/NAPaC_PCB1.PcbDoc
Project/PCB/oldPCB/NAPaC_PcbLib.PcbLib
Project/PCB/oldPCB/NAPaC_Schlib.SchLib
Project/PCB/oldPCB/PCB_NAPaC_Project1.PrjPCB
Project/PCB/PCB_NAPaC_Project1.PrjPCB
Project/PCB/PCB_NAPaC_Project11/NAPaC_PCB1.PcbLib
Project/PCB/PCB_NAPaC_Project11/PCB_NAPaC_Project1.SCHLIB
