mfeo15/CHIC-NAPaC/Report/LaTex source files/code_snippets/arduino/Messages.ino

/*
 * Messages file containing messages sent and received by server for NAPaC project
 */

 /*
  * setup_messages(); sets up message headers - not yet in use
  * first_message(); The toy presents itself to the server in initiate pairing
  * hello(); Prints NAPaC FW in serial 
  * 
  * accept_game_message(); Sends start of game session to parent
  * LED_on_message(LEDid); For play session with parent, tells the parent the child has turned a LED on
  * LED_off_message(LEDid); For play session with parent, tells the parent the child has turned a LED off
  * 
  */
 
#include <string.h>

char STX[1] = {char(2)};
char EOT[1] = {char(4)};
char RS[1]  = {char(30)};
char US[1]  = {char(31)};

int offset = 48; // = "1"

//Not in use yet - header for messages relevant to the user and parent, to be updated with signup etc
void setup_messages(){
  char message_header[22]={0};
  sprintf(message_header,"%c0020%cS001%cP314%c", STX[0],RS[0],RS[0],RS[0]);
  Serial.println("messages setup!");
}

//First packet : the microcontroller presents itself to the server, so that
//the server can link its IP address with its microcontroller name
void first_message(){
  char message1[22]={0};
  sprintf(message1,"%c0020%cS001%cP314%c0001%c", STX[0],RS[0],RS[0],RS[0],EOT[0]);
  send_message(message1);
  Serial.println("First Hello to server sent!");
}

void accept_game_message(){
  char message1[22]={0};
  sprintf(message1,"%c0020%cU123%cP314%c2002%c", STX[0],RS[0],RS[0],RS[0],EOT[0]);
  send_message(message1);
  Serial.println("Message sent: Child accepted game session!");
}

//Message to tell parent a kid turned on a LED - no error checking
void LED_on_message(uint8_t LEDid){
  char message1[31]={0};
  char led_id = (char)LEDid + offset;
  sprintf(message1,"%c0020%cU123%cP314%c2003%c1%c%c%c", STX[0],RS[0],RS[0],RS[0],RS[0],US[0],led_id,EOT[0]);
  send_message(message1);
  Serial.print("Message sent: Child turned on LED");
  Serial.println(LEDid);
}

//Message to tell parent a kid turned off a LED - no error checking
void LED_off_message(uint8_t LEDid){
  char message1[31]={0};
  char led_id = (char)LEDid + offset;
  sprintf(message1,"%c0020%cU123%cP314%c2004%c1%c%c%c", STX[0],RS[0],RS[0],RS[0],RS[0],US[0],led_id,EOT[0]);
  send_message(message1);
  Serial.print("Message sent: Child turned off LED");
  Serial.println(LEDid);
}



void hello(){
    Serial.println();
    Serial.println("                                                                                ");
    Serial.println("  _   _    _    ____        ____   _____ _                                      ");
    Serial.println(" | \\ | |  / \\  |  _ \\ __ _ / ___| |  ___(_)_ __ _ __ _____      ____ _ _ __ ___ ");
    Serial.println(" |  \\| | / _ \\ | |_) / _` | |     | |_  | | '__| '_ ` _ \\ \\ /\\ / / _` | '__/ _ \\");
    Serial.println(" | |\\  |/ ___ \\|  __/ (_| | |___  |  _| | | |  | | | | | \\ V  V / (_| | | |  __/");
    Serial.println(" |_| \\_/_/   \\_\\_|   \\__,_|\\____| |_|   |_|_|  |_| |_| |_|\\_/\\_/ \\__,_|_|  \\___|");
    Serial.println();
    Serial.println();
    Serial.println();
    Serial.println();
    
    Serial.println("Toygether Welcomes You To MS5!");
    Serial.println();
    Serial.println();
}
 
