mfeo15/CHIC-NAPaC/Project/Firmware/NAPaC_FW/test_LED/test_LED.ino

/* This example shows how to display a moving rainbow pattern on
 * an APA102-based LED strip. */

/* By default, the APA102 library uses pinMode and digitalWrite
 * to write to the LEDs, which works on all Arduino-compatible
 * boards but might be slow.  If you have a board supported by
 * the FastGPIO library and want faster LED updates, then install
 * the FastGPIO library and uncomment the next two lines: */
// #include <FastGPIO.h>
// #define APA102_USE_FAST_GPIO

#include <APA102.h>

// Define which pins to use.
const uint8_t dataPin1 = 22;
const uint8_t clockPin1 = 23;
APA102<dataPin1, clockPin1> ledStrip1; 

const uint8_t dataPin2 = 25;
const uint8_t clockPin2 = 26;
APA102<dataPin2, clockPin2> ledStrip2;

// Set the number of LEDs to control.
const uint16_t ledCount1 = 5;
const uint16_t ledCount2 = 5;
const uint16_t ledCount = ledCount1 + ledCount2;

// Create a buffer for holding the colors (3 bytes per color).
rgb_color colours1[ledCount1];
rgb_color colours2[ledCount2];

// Set the brightness to use (the maximum is 31).
const uint8_t brightness = 31;

void setup()
{
}

/* Converts a color from HSV to RGB.
 * h is hue, as a number between 0 and 360.
 * s is the saturation, as a number between 0 and 255.
 * v is the value, as a number between 0 and 255. */
rgb_color hsvToRgb(uint16_t h, uint8_t s, uint8_t v)
{
    uint8_t f = (h % 60) * 255 / 60;
    uint8_t p = (255 - s) * (uint16_t)v / 255;
    uint8_t q = (255 - f * (uint16_t)s / 255) * (uint16_t)v / 255;
    uint8_t t = (255 - (255 - f) * (uint16_t)s / 255) * (uint16_t)v / 255;
    uint8_t r = 0, g = 0, b = 0;
    switch((h / 60) % 6){
        case 0: r = v; g = t; b = p; break;
        case 1: r = q; g = v; b = p; break;
        case 2: r = p; g = v; b = t; break;
        case 3: r = p; g = q; b = v; break;
        case 4: r = t; g = p; b = v; break;
        case 5: r = v; g = p; b = q; break;
    }
    return rgb_color(r, g, b);
}

void loop()
{
  uint8_t time = millis() >> 4;
  uint8_t j = 0;
  
  for(uint16_t i = 0; i < ledCount; i++)
  {
    uint8_t p = time - i * 8;
    if (i<5){
      colours1[i] = hsvToRgb((uint32_t)p * 359 / 256, 255, 255);
    }
    else{
      j = i - 5;
      colours2[j] = hsvToRgb((uint32_t)p * 359 / 256, 255, 255);
    }
  }

  ledStrip1.write(colours1, ledCount1, brightness);
  ledStrip2.write(colours2, ledCount2, brightness);

  delay(10);
}
