mfeo15/CHIC-NAPaC/(commit log)

2018-03-10 multi-client threaded server implemantation
2018-03-15 fix missing lambda in send thread function
2018-03-19 Updatable messages for color buttons
2018-03-20 Button color changed from green to yellow to match physical led
2018-03-20 TouchSensors toggling LEDs
2018-03-22 LEDs activated by Server requests (WiFi) and deactivated by TouchSensors
2018-04-28 add of files for ADC testing of soft sensors (variable resistance)
2018-05-02 everything for ms4: send&receive messages and funky LEDs
2018-05-03 MS4 PCB Schematic and beginning of routing
    [NAPaC.SchDoc, NAPaC_PCB1.PcbDoc, PCB_NAPaC_Project1.PrjPCB]
2018-05-03 Interaction working with one LED and all sensors as one
2018-05-11 Schematic modified and components placed
    [MOLEX-MICRO-USB.PcbLib, MOLEX-MICRO-USB.SchLib, NAPaC.SchDoc, NAPaC_PCB1.PcbDoc, NAPaC_PcbLib.PcbLib, NAPaC_Schlib.SchLib, OLMX-ESP-WROOM-32.PcbLib, OLMX-ESP-WROOM-32.SchLib]
2018-05-11 First iteration to be reviewed
    [NAPaC_PCB1.PcbDoc]
2018-05-11 Minor changes, 1st version of PCB done (to be reviewed)
    [PCB_NAPaC_Project1.PrjPCB]
2018-05-14 ÊEPROM setup working - read from EEPROM after reset not working
    [setup_EEPROM.ino, test_save_smartconfig.ino]
2018-05-18 Rectifications on the 1st iteration of the PCB and realization of the detachable modules
    [NAPaC.SchDoc, NAPaC_DetachableModule.PcbDoc, NAPaC_DetachableModule.PrjPCB, NAPaC_DetachableModule.SchDoc, NAPaC_PCB1.PcbDoc, NAPaC_PcbLib.PcbLib, NAPaC_Schlib.SchLib, PCB_NAPaC_Project1.PrjPCB]
2018-05-18 PCB pinout implemented in FW, test scenarios for LED & capa working. Solo game not working yet
    [Games.ino, LEDs.ino, Messages.ino, NAPaC_FW.ino, WiFi.ino, test_save_smartconfig.ino, test_touch.ino]
2018-05-18 IO25/26 replaced IO34/35 for DI2 and CI2 LEDs commands + added missing component on the PCB (Schottky barrier for EXT_9V)
    [NAPaC.SchDoc, NAPaC_DetachableModule.PcbDoc, NAPaC_PCB1.PcbDoc, NAPaC_Schlib.SchLib, PCB_NAPaC_Project1.PrjPCB]
2018-05-18 Modifications applied on the shape of the detachable module
    [NAPaC_DetachableModule.PcbDoc]
2018-05-21 Completed report and processing, ready for review phase
    [Children.xlsx, Parent.xlsx]
2018-05-22 Correction of design rule check error
    [MOLEX-MICRO-USB.PcbLib, NAPaC_PCB1.PcbDoc, NAPaC_PcbLib.PcbLib, OLMX-ESP-WROOM-32.PcbLib, SW_BUTTON.PcbLib]
2018-05-24 Modified distance on main PCB between the 2 rows of 21 pins (proportional to 2.56mm)
    [NAPaC_DetachableModule.PcbDoc, NAPaC_DetachableModule.PrjPCB, NAPaC_PCB1.PcbDoc]
2018-05-24 Resolution of errors from design rule check (both main PCB and DetachableModule)
    [MOLEX-MICRO-USB.PcbLib, NAPaC_DetachableModule.PcbDoc, NAPaC_DetachableModule.PrjPCB, NAPaC_DetachableModule.SchDoc, NAPaC_DetachableModule_PcbLib.PcbLib, NAPaC_PCB1.PcbDoc]
2018-05-24 Minor changes
    [NAPaC_DetachableModule.PcbDoc, NAPaC_DetachableModule.step]
2018-05-25 Sound integrated in solo game - TOUCH8 not working
    [Games.ino, Messages.ino, NAPaC_FW.ino, Sound.ino]
2018-05-28 added LED interaction messages
2018-05-30 Final version of the first iteration of PCB (with modifications from supervisor taken into consideration)
    [MOLEX-MICRO-USB.PcbLib, MOLEX-MICRO-USB.SchLib, NAPaC.SchDoc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]
2018-05-30 Updated BOM
    [NAPaC.SchDoc, NAPaC_Schlib.SchLib, PCB_NAPaC_Project1.PrjPCB, PCB_NAPaC_Project1.xls, PCB_NAPaC_Project1_Qt1.xls, PCB_NAPaC_Project1_Qt100.xls, PCB_NAPaC_Project1_Qt1000.xls]
2018-05-30 Hardcoded WiFi working - interactions working but with LED bugs
    [Games.ino, LEDs.ino, Messages.ino, NAPaC_FW.ino, Server.ino, Sound.ino, WiFi.ino]
2018-05-30 Parent Game working with interactions - blink not working
    [Games.ino, LEDs.ino, NAPaC_FW.ino]
2018-05-30 test files for LED and Sensors added
2018-06-14 Re-organization of the repo structure
    [MOLEX-MICRO-USB.PcbLib, MOLEX-MICRO-USB.SchLib, NAPaC.SchDoc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]
2018-07-19 working Solo Game with 3 Zones + 3 LEDs
2018-07-19 code for Solo Game on proto with 5 working zones and LEDs, soundoff
2018-11-30 START competition, pitch application demo
2018-12-06 Updated CLK pin for LED_PRESENCE
2018-12-06 Updated pin for LED_6
2018-12-09 MassChallenge FW, first iteration on PCB
2018-12-09 MassChallenge FW, second iteration on PCB
